rkrafted/silent-speech/hw/pod/design-notes.md

# ss-pod v1 schematic: design notes (rev 0.8)

Rev 0.2 is Claude's rebuild of the DeepSeek draft (rev 0.1, commit d74f075). Every pin and value
below was checked against the datasheets in `hw/pod/ref/` (gitignored). Items still waiting on a
datasheet are marked **OPEN**. The schematic is generated by `gen_sch.py`. Edit the generator and
not the `.kicad_sch` file, because the next run overwrites manual edits.

Verification, all re-run after every change:

```
python3 hw/pod/gen_sch.py
kicad-cli sch erc --severity-error --exit-code-violations -o hw/pod/erc.rpt hw/pod/pod.kicad_sch   # 0 errors
kicad-cli sch export netlist -o hw/pod/pod.net hw/pod/pod.kicad_sch
python3 hw/pod/check_nets.py hw/pod/pod.net                                                       # 129 rules
```

ERC leaves 6 warnings, and all of them are intended. TESTP_PACE_OUT1/2 are tied to AVDD, and GPIO1..4
are tied to GND, exactly as TI specifies. KiCad warns because those pins are "bidirectional".
`check_nets.py` was itself tested against rev 0.1: it flags every bug listed in section 2.

## 1. What it is

A battery-powered 8-channel surface-EMG front end for a small wearable sensor pod. It is built from these parts:

- **Analog front end:** an ADS1298IPAG (TQFP-64) on a unipolar 3.3 V supply. All 8 channels are
  referential: IN1P..IN8P go to electrodes E1..E8, and IN1N..IN8N go to the REF electrode. One bias
  electrode is driven by the chip's RLD amplifier.
- **Radio:** a u-blox **NINA-B306-00B** module (nRF52840, 10 × 15 mm, internal antenna, 32.768 kHz
  crystal on board, CE/RED). It talks to the ADS1298 over SPI and streams over BLE.
- **Battery input:** one protected 1-cell LiPo on the swappable cartridge (or the bench JST), through an
  **AO3401A reverse-polarity FET**.
- **Charging (rev 0.7):** none on the pod. The cartridge is charged on the separate dock board (`hw/dock`).
- **Fuel gauge (rev 0.7):** MAX17048 on +BATT, I2C on EXP4/EXP5.
- **Supplies:** two **TPS7A2033** low-noise regulators (7 µV RMS, pin-compatible with the LP5907, which is out of stock). LDO1 feeds AVDD only, and LDO2 feeds DVDD and the
  module.
- **Electrode lines:** each of the 10 lines has an ESD array, a 2.2 k series resistor and a 1 nF
  capacitor to ground (OpenBCI Cyton values).
- **Connector:** 12 individual SMD spring pins (**Harwin P70-1000045R**) carry E1..E8, REF, BIAS, CLK_POGO and GND,
  in a 3 × 4 grid at 3.0 mm pitch on the top side. Rev 0.7: P11 = CLK_POGO (the ADS clock, for linking two pods;
  it was VBUS) and P12 = GND (the link's shared ground).

## 2. Bugs fixed from rev 0.1

| # | Rev 0.1 | Rev 0.2 | Source |
|---|---|---|---|
| 1 | TESTP_PACE_OUT1, TESTN_PACE_OUT2, RLDIN tied to GND | tied to **AVDD** | TI SBAS459K TQFP pin table, note 1: "Connect unused pins to AVDD". The forum bug the draft cited was about unused INxP inputs with SRB2 on the ADS1299, a different pin type |
| 2 | ADS1298 GPIO1..4 left floating | shorted to **DGND** | SBAS459K GPIO section: "do not float these pins … If not used, short these pins to DGND" |
| 3 | WCT not connected | **1 nF** to AVSS | SBAS459K Figure 106 (single-supply example) |
| 4 | NINA VBUS (pin 31) tied to +3V3 | fed from the **5 V VBUS** through 2.2 k | UBX-17052099 Table 8: "USB interface 5 V input … Must be connected to 5 V". The nRF52840 now detects the charger natively (USBDETECTED), which removes the old VBUS divider |
| 5 | MCP73831 STAT wired to a 3.3 V nRF GPIO | STAT **left open** | STAT swings to VDD = 5 V when charging is complete, which is over the nRF52840 pin rating. Charging state comes from USBDETECTED plus battery voltage instead |
| 6 | Battery divider switched by a 2N7002. With the FET off, the ADC pin saw the full battery voltage (4.2 V) through 1 M | **fixed 1 M / 1 M divider**: the pin sees at most 2.1 V, and the divider draws 2.1 µA. The FET was removed | nRF52840 inputs must stay ≤ VDD + 0.3 V |
| 7 | No battery polarity protection | **AO3401A P-FET**: drain to the cell, source to the load, gate to GND | Small JST LiPo leads come in both polarities from different vendors. A reversed cell would otherwise destroy both LDOs and the charger |
| 8 | 1 µF on the charger input and output | **10 µF 0805 25 V** on VBUS and on VBAT | MCP73831 DS20001984H 3.1/3.2: "Bypass to VSS with a minimum of 4.7 µF" (VDD and VBAT). A 0603 10 V part loses about half its capacitance at 5 V, so it uses 0805 25 V |
| 9 | ADS control pins float while the nRF boots | 100 k pulls: PWDN low, CS high, START low, RESET high | defines a known state before firmware runs, and keeps the ADS powered down until firmware starts it |
| 10 | Battery soldered to bare pads (the assembler does not fit LiPo cells, and the owner does not solder) | **JST SH 1.0 mm 2-pin socket**: the cell plugs in | owner requirement |
| 11 | Unreadable grid of label-connected boxes, custom box symbols | 6 labelled blocks, **stock KiCad library symbols** (ADS1298xPAG, LP5907MFX-3.3, MCP73831-2-OT, AO3401A, R, C, LED), power symbols | stock symbols carry pin numbers checked by the KiCad librarians. The ADS1298 pin map was cross-checked against them on all 64 pins |
| 12 | ADS1298 price in the BOM was $32 | DigiKey/Mouser 1-off **≈ $46–49** | distributor listings |
| 13 | Two LEDs, pin 1 = anode (they would have been mounted reversed) | **no LEDs at all** | owner 2026-10-07: nothing on the pod may light up. Status, battery and charging are shown in the phone app |

## 2a. Rev 0.3 changes (2026-10-12, from the MobilECG-II comparison in `ref-compare.md`)

1. **BIAS series 10 k (R25)**: RLDOUT → R25 10 k → C10 1 nF + bead → BIAS pad. The RLD amplifier no longer
   drives C10, the ESD capacitance and the strip directly (series R isolates a capacitive load), and fault
   current into skin is limited. RLD feedback (R10 ‖ C11) is taken at RLDOUT, before R25. Answers reviewer
   question 2 (section 8). MobilECG-II uses the same 10 k.
2. **33 Ω source series resistors (R26–R30)** on SCLK, MOSI, CS_N (NINA drives) and MISO, DRDY (ADS drives).
   Nets: NINA side keeps the old name, ADS side is `<name>_A`. CS pull-up R21 is on CS_N_A.
3. **Ferrite bead per electrode line (FB1–FB10)** between the ESD array and the series R (BIAS: between pad
   and C10). Against BLE-burst pickup on the strip. MobilECG-II and the 12-lead holter use the same pattern.

**OPEN (parts):** LCSC numbers for the 33 Ω 0402 (Yageo RC0402FR-0733RL or the JLCPCB basic equivalent) and
for BLM15HD182SN1D, plus its impedance at 2.4 GHz (want ≥ 1 kΩ; otherwise pick a BLM15GG/HG type).

## 2b. Rev 0.4 changes (2026-10-14, from the layout)

1. **ADS1298 link moved to the NINA's outer left pin column.** The inner-ring pins (31-46) cannot be
   escaped on this LGA: the outer pads are 0.3 mm apart. New map, in the ADS1298's pin order:
   MOSI = pin 8 (P1.00), PWDN = 7 (P0.25), RESET = 5 (P0.24), START = 4 (P0.16), CS = 3 (P0.15),
   SCLK = 2 (P0.14), MISO = 1 (P0.13), DRDY = 25 (P0.04). UBX-17052099 flags **none of these as near the
   radio**, which is better than rev 0.3: P1.01-P1.11 were near the radio.
2. **SPI 33 ohm series resistors R26-R30 removed.** The ADS1298 sits under that pin column, so each line
   is about 3 mm (pad -> via -> pad). That is electrically short for nRF52840 standard-drive edges.
3. **EXP1-EXP5 (pins 17, 18, 20, 21, 22) ARE near the radio** (UBX-17052099): use them only for signals
   below 10 kHz, so no 100/400 kHz I2C there. BAT_SENSE (pin 16, P0.03) is near the radio too; it is a
   slow analog input, which is fine.
4. **SWD on a Tag-Connect TC2030-NL footprint J3** (pads only; cable TC2030-CTX-NL) instead of loose test
   pads. Test and expansion pads are 0.8 mm.
5. **6-layer board** (see section 6).

## 2c. Rev 0.5 / 0.6 changes (2026-10-16, owner review of the 3D model)

1. **Swappable battery cartridge (rev 0.6; owner decision: modular, swappable cells).** The cell no longer lives
   inside the pod. It sits on a removable cartridge (`hw/cartridge/`, generated by `gen_cartridge.py`): a 0.6 mm
   2-layer board that forms the pod's bottom, with a JST SH socket J1 for the cell's plug and two tall SMD pogo pins
   (Harwin P70-1100045R, C20826701: 6.3 mm free, 5.0 mm working, 0.4 um gold; picked 2026-10-17) that press up onto
   two 1.8 mm ENIG pads on the pod's bottom face:
   TP15 = BATT+ on BAT_RAW at (110.9, 126.1) and TP16 = BATT- on GND at (112.4, 128.6). Swap = unclip one cartridge,
   clip in a charged one: no tools, no soldering. Spare cartridges can be sold separately.
   - **Cell:** 20 x 20 x 4 mm pouch (402020 class, about 120 mAh, about 17-20 h at 5-6 mA), at y 104.8-124.8, clear
     of the H1 screw head. It leaves the strip y 125-130 for the pads, the pins and J1. Footprint unchanged; the
     0.6 mm cartridge board replaces the 0.8 mm printed bottom wall, so the thickness is unchanged too.
   - **Pads diagonal, 2.9 mm apart:** a misplaced pin can never bridge + and -, which would short the cell.
   - **Test/expansion pads** moved from that strip to the free spot by H1 (3 x 3 at 1.3 mm around (110.4, 103.4)).
     They stay reachable: the cartridge comes off.
   - The cartridge's + also goes through the AO3401A, so a reversed cell is blocked like a reversed plug.
     J1 pin 1 = +, the same as the pod's own J2. **One cell at a time:** J2 (bench) or the cartridge, never both.
   - A swap restarts the pod (about 1 s plus a BLE reconnect); the flash buffer covers it.
   - The clip and the locating features that hold the cartridge to within about 0.4 mm belong to the case.
2. **Electrode tab without overhang**: the right-angle 1x10 header that stuck out past the pod edge is replaced by
   an upright SMD 2x5 2.54 mm header on the tab's top face. The tab is L-shaped and stays inside the pod outline:
   the grid part (x 100-110.4) plus a foot over the pod's low parts (all <= 1.25 mm; the tab rides 3.0 mm up) that
   stops 0.5 mm short of the JST socket and clear of the antenna end. All tab traces are on F.Cu (the pod side
   carries only the contacts), so the header pin order is whatever routes planar; `route_tab.py` finds it and the
   silkscreen prints it.
3. **Charger tab unchanged**: inside the outline its USB-C shell legs would land on C28 or the JST socket. It is only
   attached while charging, so it keeps its overhang.

## 2d. Rev 0.7 changes (2026-10-16, owner decisions: no charging on the pod, two pods worn at once)

1. **No USB charging on the pod.** U5 MCP73831, R11, C28, D5 SMAJ5.0A, R16 and the VBUS net are removed, and so is
   the charger tab. Cells are charged in their cartridge on the new **dock** board (`gen_dock.py`, `hw/dock/`).
   - NINA pin 31 (VBUS) was left open in rev 0.7, with **R34** (0R to GND, DNP). **Rev 0.8 fits R34** (section 2e).
   - C29 10 uF stays as bulk on +BATT. Q2 stays.
   - With no USB, firmware is flashed with a cell fitted (the programmer does not power the pod).
2. **Two-pod clock link.**
   - ADS1298 CLKSEL moves from DVDD to NINA pin 23 (P0.29), with **R33 100k** to +3V3: internal oscillator by
     default, firmware pulls it low on a slave pod.
   - ADS CLK (net CLK_SYNC, also on TP1) -> **R31 100R** -> pogo **P11** (net CLK_POGO), ESD on D4's spare IO3.
     **R32 1M** to GND, so CLK never floats.
   - The master sets CONFIG1 CLK_EN = 1. Without a lead, each pod time-stamps its samples and the phone aligns the two streams.
   - START needs no pin: both pods start on a BLE command, and the fixed whole-sample offset is removed from the
     timestamps.
3. **MAX17048 fuel gauge U7** (TDFN-8 2 x 2):
   - VDD and CELL on +BATT; CTG, QSTRT and EP on GND; ALRT open (polled); C35 100 nF (datasheet: bypass VDD with 0.1 uF).
   - SDA = EXP4 (pin 21), SCL = EXP5 (pin 22), R35/R36 4.7k to +3V3. The bus stays on the expansion pads, so add-on
     sensors share it.
   - These pins are near the radio. I2C runs about 1 ms once a minute, timed between BLE events (reviewer question).
   - The 1M/1M divider stays as a fallback.
   - Pin table checked 2026-10-17 against datasheet 19-6171 p. 6: identical.
4. **Board size stays 24 x 30.** 24 x 28 was checked first, on paper: cell 20 mm + H1 screw-head clearance + the
   4.3 mm cartridge-pad strip = 28.0 mm with zero margin, and the case needs about ±0.4 mm for the cartridge.
5. **Board 1.2 mm thick** (2026-10-17): JLCPCB offers 6 layers at 1.2 mm for the same price, with the same rules
   (JLCPCB capabilities and quote pages, checked 2026-10-17). Spring-pin heights are measured from the board faces, so nothing else moves.
   The pod gets 0.4 mm thinner. Short top-side pins were checked and rejected: thinner gold, and no gain with a
   1.2 mm PETG wall.
6. **Layout:** the charger's strip now holds U7, C35, R35/R36 and, right under P11, R31/R32. R33 and R34 take the
   free slots in the right-edge resistor columns.
   - ADS GND pin 20 lost its via-reachable pour (an island under the module), so `fix_gnd_pin.py U1 20` routes it to
     the nearest GND via, as pin 51 already was.
   - CLK_SYNC is about 37 mm of track (ADS CLK pin -> TP1 -> R31/R32). It only toggles on a master pod with CLK_EN
     set (reviewer question).
7. **Electrode tab:**
   - The 2x5 electrode header J1 is unchanged.
   - A new SMD 1x2 header J2 above the grid carries CLK and GND, for a 2-wire lead between two pods' tabs.
   - A single 2x6 header was tried and did not route on one layer.

## 2e. Rev 0.8 changes (2026-10-19)

1. **VCAP1 cap C14 is now a polymer tantalum:** Vishay T58MM226M6R3C0300 (LCSC **C215879**), 22 µF, 6.3 V, 1608-09 case,
   0.9 mm max height, 300 mΩ max ESR, about $0.57, JLCPCB Extended, in stock. Backup: KEMET T597S226M010APE100
   (C19941081, 3216-12, 1.2 mm, but only 40 in stock). Research: `research/jaw/tantalum.md`.
   - **Why:** SBAS459K p. 96: where the board sees vibration, use a nonferroelectric VCAP1 cap, "a tantalum or class 1
     capacitor (C0G or NPO)"; X5R is piezoelectric and picks up microphonics. The same page says noise on VCAP1 degrades
     performance (forum answer Q3, `research/jaw/chip-forums.md`).
   - **Voltage:** with the 3.3 V analog supply the reference is 2.4 V. The 4 V figure in the research file (datasheet p. 33)
     is the 5 V-supply option (VREF_4V), which this board does not use. 6.3 V clears either.
   - **Footprint:** `Capacitor_Tantalum_SMD:CP_EIA-1608-10_AVX-L`, with the Vishay T58 pad table giving the same pads for the
     MM (1608-09) and M0 (1608-10) cases. **Pad 1 = +**, on VCAP1 (toward ADS pin 28); pad 2 = GND. Symbol Device:C_Polarized.
     Placed where the 0805 was (bottom side, second row). Checked in the rebuilt PCB and in `check_nets.py`.
   - **Leakage:** polymer, up to 14 µA at 6.3 V (about 0.1·C·V in general terms). The ADS1298 gives no leakage limit for VCAP1
     (reviewer question 6).
2. **NINA pin 31 (VBUS) is tied to GND through R34 0R, now fitted** (was open, DNP). Nordic's no-USB reference configuration
   and the DevZone threads 35658 and 48589 say to ground VBUS (forum answer Q5, `research/jaw/chip-forums.md`). The
   reviewer question about it stays as a confirmation.
3. Nothing else changed. Pod board 24 × 30 mm, 91 placed parts, DRC 0, unconnected 0, parity 0, ERC 0, net rules pass.

## 3. Values and their sources

| Part | Value | Source |
|---|---|---|
| Electrode series R (R1–R9) | 2.2 k | OpenBCI Cyton R4 array (CC BY-SA 4.0) |
| Electrode ferrite beads (FB1–FB10) | BLM15HD182SN1D | MobilECG-II / 12-lead holter input filter pattern (rev 0.3) |
| BIAS series R (R25) | 10 k | MobilECG-II RLD output (rev 0.3) |
| SPI series R (R26–R30) | 33 Ω | MobilECG-II RP3 (51 Ω) pattern; 33 Ω because the nRF52840 driver adds its own output resistance (rev 0.3) |
| Electrode C to GND (C1–C10) | 1 nF | Cyton C26. With 2.2 k this forms a ≈72 kHz EMI filter, not an anti-alias filter (SBAS459K 9.3.1.1) |
| ESD arrays (D2–D4) | TPD4E1B06 | Cyton D5/D6. Placed on the electrode side of the 2.2 k |
| RLD feedback | 392 k ‖ 10 nF (R10, C11) | TI ADS1298ECG-FE user guide SBAU171D 4.8 |
| RLDREF | internal (AVDD+AVSS)/2, 100 nF on the pin | SBAS459K, CONFIG3 RLDREF_INT |
| VREFP | 0.1 µF + 10 µF, VREFN = AVSS, internal 2.4 V | SBAS459K Figure 106 |
| VCAP1 / VCAP2..4 | 22 µF polymer tantalum C215879 (rev 0.8) / 1 µF | SBAS459K pin table + Figure 106 |
| AVDD, DVDD decoupling | 0.1 µF + 1 µF each | Figure 106 ("as close to the package as possible") |
| CLKSEL | rev 0.7: NINA pin 23 + 100 k pull-up (internal oscillator unless firmware pulls it low). CLK on TP1 and pogo P11 | SBAS459K Table 11 |
| RESV1, DAISY_IN | DGND | pin table |
| Charger (dock, rev 0.7) | MCP73831-2 (4.20 V) on the dock, R_PROG 15 k = 67 mA (about 0.55 C for 120 mAh) | MCP73831 datasheet: I = 1000 V / R_PROG |
| Fuel gauge (rev 0.7) | MAX17048 on +BATT, I2C 4.7 k pull-ups | MAX17048 datasheet 19-6171 p. 6 (pin table checked 2026-10-17); LCSC C2682616 |
| Two-pod clock | CLK 100 R series, 1 M pull-down; CLKSEL 100 k pull-up | SBAS459K CLKSEL / CONFIG1 CLK_EN |
| LDOs | TPS7A2033PDBVR (LCSC C2862740, 200k in stock). EN tied to IN (always on). 1 µF in and out | TPS7A20 datasheet: SOT-23 pins 1 IN, 2 GND, 3 EN, 4 NC, 5 OUT (same as LP5907). Needs ≥ 0.47 µF effective on OUT. Noise 6.7 µV RMS at 20–100 mA |
| Module decoupling | 0.1 µF + 1 µF | u-blox NINA-B3 integration |
| Battery sense | 1 M / 1 M + 100 nF on NINA pin 16 (P0.03, AIN1) | the 100 nF supplies the SAADC sample charge at the high source impedance |

**Part types:** 23 BOM lines, of which 5 resistor values and 6 capacitor values are JLCPCB basic parts.
Reusing values keeps the extended-part fees low.

## 4. Pin map: NINA-B306 ↔ ADS1298 and the rest

| NINA pin | nRF52840 | Net | Notes |
|---|---|---|---|
| 2 | P0.14 | SCLK → ADS SCLK | rev 0.4: the whole ADS link is on pins u-blox does **not** mark near the radio, with no series R |
| 8 | P1.00 | MOSI → ADS DIN | (P1.00 is also SWO; SWO is not used: J3 pin 6 is open) |
| 1 | P0.13 | MISO ← ADS DOUT | |
| 3 | P0.15 | CS_N → ADS CS | R21 100 k pull-up |
| 25 | P0.04 | DRDY ← ADS DRDY | 500-1000 Hz |
| 4 | P0.16 | START | static; also on TP2. R22 pull-down |
| 5 | P0.24 | ADS_RESET | static. R23 pull-up |
| 7 | P0.25 | ADS_PWDN | static. R20 pull-down |
| 17, 18, 20 | P0.28, P0.02, P0.31 | EXP1-EXP3 | **near the radio**: signals below 10 kHz only |
| 21, 22 | P1.12, P1.13 | EXP4 = SDA, EXP5 = SCL | rev 0.7: MAX17048 I2C (bursts about 1 ms per minute), also on the pads |
| 23 | P0.29 | CLKSEL | rev 0.7: static. R33 100 k pull-up |
| 16 | P0.03 / AIN1 | BAT_SENSE | analog (near the radio: fine for a slow ADC input) |
| 31 | VBUS | VBUS_MOD: tied to GND by R34 0R (fitted) | rev 0.8: no USB on the pod; Nordic no-USB configuration |
| 15 / 11 / 19 | SWDIO / SWDCLK / P0.18 | J3 Tag-Connect pins 2 / 4 / 3 | programming (J3.1 = +3V3, J3.5 = GND). R13 pulls RESET up |
| 9, 10 | VCC_IO, VCC | +3V3 | VCC_IO must tie to VCC on NINA-B3 |
| 6/12/14/26/30/53, EGP, EAGP | | GND | **EAGP** (antenna-area ground pads, NINA-B306 only) must be grounded, so the footprint must carry them |

All other module pins have no-connect flags.

## 5. Firmware rules the hardware depends on

- **Power-up:** drive PWDN and RESET high, wait for t_POR, pulse RESET, send SDATAC, and only then
  write registers (SBAS459K power-up sequence).
- **ADS1298 registers:**
  - CONFIG3: `PD_REFBUF = 1` (internal reference), `RLDREF_INT = 1`, `PD_RLD = 1`.
  - RLD_SENSP/N: select the electrode channels.
  - Gain: x6 or lower for EMG (the forum found x24 rails).
  - Data rate: 1000 SPS by default (owner 2026-10-07); 500 only as the weak-link fallback.
  - Do not use the pace/test outputs. They are tied to AVDD.
- **Charging (rev 0.7):** never on the pod. A cartridge swap restarts the pod; buffer to flash and back-fill after the
  BLE reconnect. Battery % comes from the MAX17048 (fallback: BAT_SENSE).
- **Two pods:** the master keeps CLKSEL high and sets CONFIG1 CLK_EN = 1; the slave drives CLKSEL low before START.
  Only one pod drives BIAS (the other powers its RLD amplifier down).
- **No light anywhere:** there are no LEDs. Every status (connected, recording, battery, charging)
  goes to the phone app over BLE.
- **Battery:** read BAT_SENSE × 2. Below 3.5 V, warn and stop, because LDO dropout starts near 3.4 V.
- **Idle:** keep PWDN low and advertise BLE slowly. There is no power switch, so idle current sets
  shelf life (tens of µA is weeks to months on the 120 mAh cartridge; MAX17048 adds about 23 µA, or 4 µA in hibernate).

## 6. Layout (rev 0.4 board, 2026-10-14; rev 0.5-0.7 changes in sections 2c and 2d)

Rebuild everything with `hw/pod/build.sh`:

| Step | Script | What it does |
|---|---|---|
| 1 | `gen_sch.py` | schematic, ERC, netlist, `check_nets.py` |
| 2 | `gen_nina_fp.py` | module footprint |
| 3 | `gen_pcb.py` | placement, rules, planes, keep-outs, locked decoupling routes, GND fan-out |
| 4 | `route.py` | Freerouting |
| 5 | `finish_route.py` | A* for leftovers, GND stitching, clearance nudges |
| 6 | DRC | must be clean |

Order files come from `fab.py`, which refuses on any DRC error, unrouted net or placeholder. The mating
tabs come from `gen_tabs.py`, and the electrode tab is then routed by `route_tab.py` (F.Cu only). Shared mechanics are in `pod_geom.py`. The review package is `hw/review/`.

- **Board:** 24 x 30 mm, **6 layers**: F.Cu / In1 GND / In2 sig / In3 sig / In4 GND / B.Cu, parts on both
  sides. The owner chose 24 x 30 after 22 x 28 measured 76 % courtyard density (893 mm2 of parts). Six
  layers instead of four (about $10-30 more per order) because:
  - on four layers the autorouter left 8-27 nets open in every attempt;
  - an In2 +3V3 plane split into islands;
  - six layers give each assembled side its own solid ground plane.
  Rev 0.6+: the 402020 cell (20 x 20 x 4, about 120 mAh) sits on the removable cartridge against the bottom side.
- **Top:**
  - NINA-B306 at the top edge, antenna outward (footprint rotated 180 deg), with an all-layer copper
    keep-out under its antenna end;
  - 3 x 4 pogo grid (3.0 mm pitch, P1-P3 / P4-P6 / P7-P9 / P10-P12; rev 0.7: P11 CLK_POGO + P12 GND), with
    an M2 NPTH clamp hole at each end;
  - Tag-Connect between H1 and the grid;
  - rev 0.7: R31 (CLK 100R) and R32 (1M) under P11, where the VBUS TVS was;
  - flash directly under the module's QSPI pin row;
  - rev 0.7: MAX17048 + pull-ups where the charger was; FET, JST SH socket (opening at the bottom edge);
  - the boot pull resistors and battery divider in two columns at the right edge.
- **Bottom:**
  - ADS1298 under the module;
  - every decoupling cap 2 mm outside its own pin, with a **locked** pad-to-pin route;
  - VREFP 10 uF and VCAP1 22 uF (rev 0.8: 1608 polymer tantalum) in a second row, lined up on free gaps;
  - the 10 filter rows (bead, 2.2k, 1 nF) under the pogo grid in ADS pin order, ESD arrays in the
    grid-area corners;
  - both LDOs, with EN tied to IN on a locked route;
  - 0.8 mm test and expansion pads.
- **Clamp:** the bench electrode tab screws down on 3.0 mm M2 nylon spacers (pogo
  working height 2.9 mm). Hole keep-out is r 2.1 mm on both sides (spacer on top, screw head below).
  Screws are for the bench tab only. The worn flex strip, the battery cartridge and the dock hold on with magnets in
  the printed case (owner, 2026-10-06/07). The two NPTH holes double as locating posts.
- **Tabs:**
  - the pod-facing side carries only the contact pads, so a pogo tip can't press through the mask onto
    other copper;
  - the electrode tab stays inside the pod outline (rev 0.5); the charger tab is gone (rev 0.7);
  - electrode tab header J1 (upright SMD 2x5, pin 1 top left, odd pins left column), rev 0.7 order: 1 REF, 2 E6,
    3 E3, 4 E5, 5 E4, 6 E2, 7 E1, 8 E8, 9 BIAS, 10 E7. Link header J2 (1x2): 1 CLK, 2 GND. The order is the one that routes on the top layer alone; the
    silkscreen prints it beside the header.
- **Rules (JLCPCB 6-layer standard):**
  - signals routed at 0.10 / 0.10 mm; necked tracks widened to the 0.09 mm minimum;
  - DRC uses 0.09 mm space;
  - vias 0.45 / 0.20 mm;
  - via hole to copper 0.20 mm (confirm in review);
  - copper to edge 0.30 mm;
  - battery path (+BATT, BAT_RAW) 0.20 mm tracks.
- **Ground:** every GND SMD pad gets its own stub and via where one fits. The pads listed in the review
  README reach ground through the pour plus stitching vias, and DRC confirms them connected.

## 7. Datasheet check, 2026-10-07 (PDFs in hw/pod/ref/ds/, read by Claude)

| Item | Result |
|---|---|
| TPD4E1B06 DCK pinout | **confirmed** (TI SLVSBQ8E Table 4-1): 1 IO1, 2 IO2, 3 GND, 4 IO3, 5 IO4, 6 NC. Matches `TPD_MAP` |
| LP5907MFX-3.3 | out of stock. **Replaced by TPS7A2033PDBVR** (TI, identical pinout, as quiet). MSKSEMI C20538881 is the fallback |
| MCP73831 capacitors | minimum 4.7 µF on VDD and on VBAT. **10 µF 0805 25 V** used |
| Battery socket | **JST SM02B-SRSS-TB, LCSC C160402** (JLCPCB extended, 32k stock). The cell needs a JST **SH 1.0 mm** 2-pin plug (cable housing SHR-02V-S-B). **When buying the battery:** choose the SH1.0 plug option and check its polarity. The AO3401A only protects; a reversed cell does not power on |
| **Pogo connector** | **Resolved (ds2/).** C55173001 was a single row of 6 at 2.5 mm, through-hole. The only real 2×6 pogo at LCSC (C5200695) is 8 mm tall and through-hole, too tall for a 10 mm pod. **Chosen: 12 × Harwin P70-1000045R (C17702549)**, an SMD single pin: 0.4 µm Au plunger over Ni (good for sweat), 10k cycles, 2 A, 3.5 mm free / **2.9 mm working height** / 2.7 mm minimum, recommended pad Ø2.20 mm, tape and reel (pick-and-place OK), 1,983 in stock. Cheaper fallback: YIYUAN YTC1P-1807-01R (C53185156, $0.21, 20k cycles), but it has only 1 µ" flash gold |
| 10 µF 0805 25 V (C15850) | JLCPCB **basic** part, 4.8 M in JLCPCB stock (0 at LCSC retail, irrelevant for assembly). The Samsung catalog gives no DC-bias curve. Two of them (VBUS, VBAT) still clear 4.7 µF at 5 V only if derating stays under about 50 %, so the reviewers are asked to confirm, or use 2 × 10 µF |
| NINA-B306 stock | only **38** at LCSC. Order soon, or note the alternative module before ordering |
| NINA-B306 antenna (integration manual UBX-17056748, 3.3) | module at the **centre of a board edge**, antenna facing away from the body. **Ground plane ≥ 10 mm on both sides** (so that edge is about 30 mm). Full GND plane under the module, with the cut-out under the antenna per its Figure 14. The **4 EAGP pads must be grounded** (they are). u-blox also wants **10 mm to the case and to metal parts**, which a 24 × 30 × 10 mm pod cannot meet. **Expect reduced range.** For a phone within about 1 m this is acceptable: the BLE link budget has more than 20 dB margin at 1 m even with 10–15 dB of body and detuning loss. Check the RSSI on the first boards |

## 8. Questions for the reviewers (TI E2E, r/PrintedCircuitBoard)

1. **RLD loop stability.** The bias electrode will often be a dry or hydrogel pad with 0.1–2 MΩ
   contact impedance that varies. Is TI's 392 k ‖ 10 nF still stable, or should C11 change?
2. **Series resistance on BIAS.** *Answered in rev 0.3:* 10 k (R25), as on MobilECG-II.
3. **Internal RLDREF** on a unipolar 3.3 V build: any reason to prefer an external mid-supply divider?
4. **MCP73831 without power-path.** The pod draws about 5 mA while the cell charges at 100 mA. Do we
   accept the termination behaviour for v1?
5. **Single GND net** with a split-return layout under the ADS1298, versus separate AGND/DGND nets
   joined at one point.
6. **VCAP1 22 µF.** *Changed in rev 0.8* to a Vishay T58 polymer tantalum (C215879), as SBAS459K p. 96 advises under
   vibration (research/jaw/chip-forums.md Q3, research/jaw/tantalum.md). Open for the reviewer: (a) is the 1608 polymer land
   pattern right (the KiCad `CP_EIA-1608-10_AVX-L` pads, identical to the T58 MM case table)? (b) Is polymer leakage on
   VCAP1 (up to about 14 µA at 6.3 V) acceptable, or should it be a MnO₂ tantalum?
7. **NINA VBUS to GND.** Done in rev 0.8 (R34 fitted; research/jaw/chip-forums.md Q5). Confirm.
