rkrafted/silent-speech/hw/revisions/2026-10-07-392cefe4/pod/design-notes.md

# ss-pod v1 schematic: design notes (rev 0.2)

Rev 0.2 is Claude's rebuild of the DeepSeek draft (rev 0.1, commit d74f075). Every pin and value
below was checked against the datasheets in `hw/pod/ref/` (gitignored). Items still waiting on a
datasheet are marked **OPEN**. The schematic is generated by `gen_sch.py`. Edit the generator and
not the `.kicad_sch` file, because the next run overwrites manual edits.

Verification, all re-run after every change:

```
python3 hw/pod/gen_sch.py
kicad-cli sch erc --severity-error --exit-code-violations -o hw/pod/erc.rpt hw/pod/pod.kicad_sch   # 0 errors
kicad-cli sch export netlist -o hw/pod/pod.net hw/pod/pod.kicad_sch
python3 hw/pod/check_nets.py hw/pod/pod.net                                                       # 85 rules
```

ERC leaves 6 warnings, and all of them are intended. TESTP_PACE_OUT1/2 are tied to AVDD, and GPIO1..4
are tied to GND, exactly as TI specifies. KiCad warns because those pins are "bidirectional".
`check_nets.py` was itself tested against rev 0.1: it flags every bug listed in section 2.

## 1. What it is

A battery-powered 8-channel surface-EMG front end for the hidden jaw pod. It is built from these parts:

- **Analog front end:** an ADS1298IPAG (TQFP-64) on a unipolar 3.3 V supply. All 8 channels are
  referential: IN1P..IN8P go to electrodes E1..E8, and IN1N..IN8N go to the REF electrode. One bias
  electrode is driven by the chip's RLD amplifier.
- **Radio:** a u-blox **NINA-B306-00B** module (nRF52840, 10 × 15 mm, internal antenna, 32.768 kHz
  crystal on board, CE/RED). It talks to the ADS1298 over SPI and streams over BLE.
- **Battery input:** one protected 1-cell LiPo, through an **AO3401A reverse-polarity FET**.
- **Charging:** an **MCP73831** at 100 mA from the pogo VBUS pin.
- **Supplies:** two **TPS7A2033** low-noise regulators (7 µV RMS, pin-compatible with the LP5907, which is out of stock). LDO1 feeds AVDD only, and LDO2 feeds DVDD and the
  module.
- **Electrode lines:** each of the 10 lines has an ESD array, a 2.2 k series resistor and a 1 nF
  capacitor to ground (OpenBCI Cyton values).
- **Connector:** 12 individual SMD spring pins (**Harwin P70-1000045R**) carry E1..E8, REF, BIAS, VBUS and GND. They sit on the same (top) side as every other part, in a 2 × 6 grid at 3.0 mm pitch at one board end. P11 (VBUS) and P12 (GND) are adjacent, so the charger tab touches only those two.

## 2. Bugs fixed from rev 0.1

| # | Rev 0.1 | Rev 0.2 | Source |
|---|---|---|---|
| 1 | TESTP_PACE_OUT1, TESTN_PACE_OUT2, RLDIN tied to GND | tied to **AVDD** | TI SBAS459K TQFP pin table, note 1: "Connect unused pins to AVDD". The forum bug the draft cited was about unused INxP inputs with SRB2 on the ADS1299, a different pin type |
| 2 | ADS1298 GPIO1..4 left floating | shorted to **DGND** | SBAS459K GPIO section: "do not float these pins … If not used, short these pins to DGND" |
| 3 | WCT not connected | **1 nF** to AVSS | SBAS459K Figure 106 (single-supply example) |
| 4 | NINA VBUS (pin 31) tied to +3V3 | fed from the **5 V VBUS** through 2.2 k | UBX-17052099 Table 8: "USB interface 5 V input … Must be connected to 5 V". The nRF52840 now detects the charger natively (USBDETECTED), which removes the old VBUS divider |
| 5 | MCP73831 STAT wired to a 3.3 V nRF GPIO | STAT **left open** | STAT swings to VDD = 5 V when charging is complete, which is over the nRF52840 pin rating. Charging state comes from USBDETECTED plus battery voltage instead |
| 6 | Battery divider switched by a 2N7002. With the FET off, the ADC pin saw the full battery voltage (4.2 V) through 1 M | **fixed 1 M / 1 M divider**: the pin sees at most 2.1 V, and the divider draws 2.1 µA. The FET was removed | nRF52840 inputs must stay ≤ VDD + 0.3 V |
| 7 | No battery polarity protection | **AO3401A P-FET**: drain to the cell, source to the load, gate to GND | Small JST LiPo leads come in both polarities from different vendors. A reversed cell would otherwise destroy both LDOs and the charger |
| 8 | 1 µF on the charger input and output | **10 µF 0805 25 V** on VBUS and on VBAT | MCP73831 DS20001984H 3.1/3.2: "Bypass to VSS with a minimum of 4.7 µF" (VDD and VBAT). A 0603 10 V part loses about half its capacitance at 5 V, so it uses 0805 25 V |
| 9 | ADS control pins float while the nRF boots | 100 k pulls: PWDN low, CS high, START low, RESET high | defines a known state before firmware runs, and keeps the ADS powered down until firmware starts it |
| 10 | Battery soldered to bare pads (the assembler does not fit LiPo cells, and the owner does not solder) | **JST SH 1.0 mm 2-pin socket**: the cell plugs in | owner requirement |
| 11 | Unreadable grid of label-connected boxes, custom box symbols | 6 labelled blocks, **stock KiCad library symbols** (ADS1298xPAG, LP5907MFX-3.3, MCP73831-2-OT, AO3401A, R, C, LED), power symbols | stock symbols carry pin numbers checked by the KiCad librarians. The ADS1298 pin map was cross-checked against them on all 64 pins |
| 12 | ADS1298 price in the BOM was $32 | DigiKey/Mouser 1-off **≈ $46–49** | distributor listings |
| 13 | Two LEDs, pin 1 = anode (they would have been mounted reversed) | **no LEDs at all** | owner 2026-10-07: the pod is meant to be hidden, so nothing may light up. Status, battery and charging are shown in the phone app |

## 3. Values and their sources

| Part | Value | Source |
|---|---|---|
| Electrode series R (R1–R9) | 2.2 k | OpenBCI Cyton R4 array (CC BY-SA 4.0) |
| Electrode C to GND (C1–C10) | 1 nF | Cyton C26. With 2.2 k this forms a ≈72 kHz EMI filter, not an anti-alias filter (SBAS459K 9.3.1.1) |
| ESD arrays (D2–D4) | TPD4E1B06 | Cyton D5/D6. Placed on the electrode side of the 2.2 k |
| RLD feedback | 392 k ‖ 10 nF (R10, C11) | TI ADS1298ECG-FE user guide SBAU171D 4.8 |
| RLDREF | internal (AVDD+AVSS)/2, 100 nF on the pin | SBAS459K, CONFIG3 RLDREF_INT |
| VREFP | 0.1 µF + 10 µF, VREFN = AVSS, internal 2.4 V | SBAS459K Figure 106 |
| VCAP1 / VCAP2..4 | 22 µF / 1 µF | SBAS459K pin table + Figure 106 |
| AVDD, DVDD decoupling | 0.1 µF + 1 µF each | Figure 106 ("as close to the package as possible") |
| CLKSEL | high (DVDD) = internal oscillator. CLK on test pad TP1 for future two-chip sync | SBAS459K Table 11 |
| RESV1, DAISY_IN | DGND | pin table |
| Charger | MCP73831-2 (4.20 V), R_PROG 10 k = 100 mA | MCP73831 datasheet: I = 1000 V / R_PROG |
| LDOs | TPS7A2033PDBVR (LCSC C2862740, 200k in stock). EN tied to IN (always on). 1 µF in and out | TPS7A20 datasheet: SOT-23 pins 1 IN, 2 GND, 3 EN, 4 NC, 5 OUT (same as LP5907). Needs ≥ 0.47 µF effective on OUT. Noise 6.7 µV RMS at 20–100 mA |
| Module decoupling | 0.1 µF + 1 µF | u-blox NINA-B3 integration |
| Battery sense | 1 M / 1 M + 100 nF on NINA pin 16 (P0.03, AIN1) | the 100 nF supplies the SAADC sample charge at the high source impedance |

**Part types:** 20 BOM lines, of which 5 resistor values and 6 capacitor values are JLCPCB basic parts.
Reusing values keeps the extended-part fees low.

## 4. Pin map: NINA-B306 ↔ ADS1298 and the rest

| NINA pin | nRF52840 | Net | Notes |
|---|---|---|---|
| 32 | P0.11 | SCLK | SPI on pins u-blox does **not** mark radio-sensitive |
| 33 | P1.09 | MOSI (ADS DIN) | |
| 34 | P1.08 | MISO (ADS DOUT) | |
| 35 | P1.01 | CS_N | radio-sensitive pin. Toggles once per frame (≤ 1 kHz), under the 10 kHz limit |
| 36 | P1.02 | DRDY | 500–1000 Hz |
| 37 | P1.03 | START | static. Also on TP2 |
| 38 | P1.10 | ADS_RESET | static |
| 39 | P1.11 | ADS_PWDN | static |
| 16 | P0.03 / AIN1 | BAT_SENSE | analog |
| 31 | VBUS | VBUS via 2.2 k | charger present → USBDETECTED event |
| 15 / 11 / 19 | SWDIO / SWDCLK / P0.18 | TP3 / TP4 / TP5 | programming. TP6 = +3V3, TP7 = GND. R13 pulls RESET up |
| 9, 10 | VCC_IO, VCC | +3V3 | VCC_IO must tie to VCC on NINA-B3 |
| 6/12/14/26/30/53, EGP, EAGP | | GND | **EAGP** (antenna-area ground pads, NINA-B306 only) must be grounded, so the footprint must carry them |

All other module pins have no-connect flags.

## 5. Firmware rules the hardware depends on

- **Power-up:** drive PWDN and RESET high, wait for t_POR, pulse RESET, send SDATAC, and only then
  write registers (SBAS459K power-up sequence).
- **ADS1298 registers:**
  - CONFIG3: `PD_REFBUF = 1` (internal reference), `RLDREF_INT = 1`, `PD_RLD = 1`.
  - RLD_SENSP/N: select the electrode channels.
  - Gain: x6 or lower for EMG (the forum found x24 rails).
  - Data rate: 500–1000 SPS.
  - Do not use the pace/test outputs. They are tied to AVDD.
- **Charging:** on USBDETECTED (charger present), stop streaming and power the ADS down. On
  USBREMOVED, resume. Report "charging" to the app while VBUS is present, and "full" once the battery
  reads ≥ 4.15 V for a few minutes (STAT is not wired: it swings to 5 V).
- **No light anywhere:** there are no LEDs. Every status (connected, recording, battery, charging)
  goes to the phone app over BLE.
- **Battery:** read BAT_SENSE × 2. Below 3.5 V, warn and stop, because LDO dropout starts near 3.4 V.
- **Idle:** keep PWDN low and advertise BLE slowly. There is no power switch, so idle current sets
  shelf life (tens of µA means months on 200 mAh).

## 6. Rules for the layout (next item)

- **Placement:** every part is on the TOP side, so it is one economic assembly side, including the
  12 pogo pins. The bottom side is bare and flat against the battery.
- **Pogo grid:** P1..P12 in a 2 × 6 grid, 3.0 mm pitch, Ø2.2 mm pads, at the board end that faces
  the strip tab. Nothing taller than 2.5 mm within 2 mm of the grid, so the tab can reach the 2.9 mm
  working height. The case has 12 holes over the pins and a magnet each side of the grid.
- **Mating tabs (strip end and charger):** 12 (or 2) gold pads, Ø ≥ 2.5 mm, at the same grid, on a
  stiffened flex or rigid tab with a steel or magnet insert. **Hard gold over Ni** is preferred for
  daily mating (Mill-Max guidance). ENIG works for the prototype.
- **Analog area:** 4 layers, with layer 2 a solid GND plane. Keep the analog section (ADS1298, input
  RCs, RLD, VREF/VCAP caps) in one corner, away from the module antenna. Return digital currents under
  the digital section. Every TI decoupling cap goes at its pin.
- **Antenna:** module at the centre of the opposite short edge, antenna outward (away from the head).
  Ground ≥ 10 mm either side, full GND under the module, and the u-blox cut-out under the antenna.
- **Matching:** route the input traces E1..E8 / REF as matched short runs. Keep BIAS away from the
  inputs.
- **Footprints to draw:**
  - `pod:u-blox_NINA-B306`: u-blox land pattern, including EGP and the 4 EAGP pads.
  - `pod:Harwin_P70-1000045R_pad2.2`: one Ø2.2 mm SMD pad, plus a courtyard.
- **Charger:** needs a separate tiny board (same JLCPCB order). It is a USB-C socket feeding 2 gold
  pads at the P11/P12 positions, with magnets. It is not part of this schematic.

## 7. Datasheet check, 2026-10-07 (PDFs in hw/pod/ref/ds/, read by Claude)

| Item | Result |
|---|---|
| TPD4E1B06 DCK pinout | **confirmed** (TI SLVSBQ8E Table 4-1): 1 IO1, 2 IO2, 3 GND, 4 IO3, 5 IO4, 6 NC. Matches `TPD_MAP` |
| LP5907MFX-3.3 | out of stock. **Replaced by TPS7A2033PDBVR** (TI, identical pinout, as quiet). MSKSEMI C20538881 is the fallback |
| MCP73831 capacitors | minimum 4.7 µF on VDD and on VBAT. **10 µF 0805 25 V** used |
| Battery socket | **JST SM02B-SRSS-TB, LCSC C160402** (JLCPCB extended, 32k stock). The cell needs a JST **SH 1.0 mm** 2-pin plug (cable housing SHR-02V-S-B). **When buying the battery:** choose the SH1.0 plug option and check its polarity. The AO3401A only protects; a reversed cell does not power on |
| **Pogo connector** | **Resolved (ds2/).** C55173001 was a single row of 6 at 2.5 mm, through-hole. The only real 2×6 pogo at LCSC (C5200695) is 8 mm tall and through-hole, too tall for a 10 mm pod. **Chosen: 12 × Harwin P70-1000045R (C17702549)**, an SMD single pin: 0.4 µm Au plunger over Ni (good for sweat), 10k cycles, 2 A, 3.5 mm free / **2.9 mm working height** / 2.7 mm minimum, recommended pad Ø2.20 mm, tape and reel (pick-and-place OK), 1,983 in stock. Cheaper fallback: YIYUAN YTC1P-1807-01R (C53185156, $0.21, 20k cycles), but it has only 1 µ" flash gold |
| 10 µF 0805 25 V (C15850) | JLCPCB **basic** part, 4.8 M in JLCPCB stock (0 at LCSC retail, irrelevant for assembly). The Samsung catalog gives no DC-bias curve. Two of them (VBUS, VBAT) still clear 4.7 µF at 5 V only if derating stays under about 50 %, so the reviewers are asked to confirm, or use 2 × 10 µF |
| NINA-B306 stock | only **38** at LCSC. Order soon, or note the alternative module before ordering |
| NINA-B306 antenna (integration manual UBX-17056748, 3.3) | module at the **centre of a board edge**, antenna facing out from the head. **Ground plane ≥ 10 mm on both sides** (so that edge is about 30 mm). Full GND plane under the module, with the cut-out under the antenna per its Figure 14. The **4 EAGP pads must be grounded** (they are). u-blox also wants **10 mm to the case and to metal parts**, which a 30 × 20 × 10 mm pod cannot meet. **Expect reduced range.** For a phone within about 1 m this is acceptable: the BLE link budget has more than 20 dB margin at 1 m even with 10–15 dB of body and detuning loss. Check the RSSI on the first boards |

## 8. Questions for the reviewers (TI E2E, r/PrintedCircuitBoard)

1. **RLD loop stability.** The bias electrode will often be a dry or hydrogel pad with 0.1–2 MΩ
   contact impedance that varies. Is TI's 392 k ‖ 10 nF still stable, or should C11 change?
2. **Series resistance on BIAS.** RLDOUT drives the bias electrode directly; only the 1 nF and ESD
   are on the line. Cyton-style 2.2 k on the sense lines only. Should BIAS get a series resistor to
   limit fault current into skin?
3. **Internal RLDREF** on a unipolar 3.3 V build: any reason to prefer an external mid-supply divider?
4. **MCP73831 without power-path.** The pod draws about 5 mA while the cell charges at 100 mA. Do we
   accept the termination behaviour for v1?
5. **Single GND net** with a split-return layout under the ADS1298, versus separate AGND/DGND nets
   joined at one point.
6. **VCAP1 22 µF X5R in a wearable** (TI notes microphonics under vibration). Is it worth a
   tantalum/polymer part?
