rkrafted/silent-speech/hw/revisions/2026-10-16-01f62380/pod/design-notes.md

# ss-pod v1 schematic: design notes (rev 0.4)

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

Verification, all re-run after every change:

```
python3 hw/pod/gen_sch.py
kicad-cli sch erc --severity-error --exit-code-violations -o hw/pod/erc.rpt hw/pod/pod.kicad_sch   # 0 errors
kicad-cli sch export netlist -o hw/pod/pod.net hw/pod/pod.kicad_sch
python3 hw/pod/check_nets.py hw/pod/pod.net                                                       # 122 rules
```

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

## 1. What it is

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

## 2. Bugs fixed from rev 0.1

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

## 2b. Rev 0.4 changes (2026-10-14, from the layout)

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

## 3. Values and their sources

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

## 4. Pin map: NINA-B306 ↔ ADS1298 and the rest

| NINA pin | nRF52840 | Net | Notes |
|---|---|---|---|
| 2 | P0.14 | SCLK → ADS SCLK | rev 0.4: the whole ADS link is on pins u-blox does **not** mark near the radio, with no series R |
| 8 | P1.00 | MOSI → ADS DIN | (P1.00 is also SWO; SWO is not used: J3 pin 6 is open) |
| 1 | P0.13 | MISO ← ADS DOUT | |
| 3 | P0.15 | CS_N → ADS CS | R21 100 k pull-up |
| 25 | P0.04 | DRDY ← ADS DRDY | 500-1000 Hz |
| 4 | P0.16 | START | static; also on TP2. R22 pull-down |
| 5 | P0.24 | ADS_RESET | static. R23 pull-up |
| 7 | P0.25 | ADS_PWDN | static. R20 pull-down |
| 17, 18, 20, 21, 22 | P0.28, P0.02, P0.31, P1.12, P1.13 | EXP1-EXP5 | **near the radio**: signals below 10 kHz only |
| 16 | P0.03 / AIN1 | BAT_SENSE | analog (near the radio: fine for a slow ADC input) |
| 31 | VBUS | VBUS via 2.2 k | charger present → USBDETECTED event |
| 15 / 11 / 19 | SWDIO / SWDCLK / P0.18 | J3 Tag-Connect pins 2 / 4 / 3 | programming (J3.1 = +3V3, J3.5 = GND). R13 pulls RESET up |
| 9, 10 | VCC_IO, VCC | +3V3 | VCC_IO must tie to VCC on NINA-B3 |
| 6/12/14/26/30/53, EGP, EAGP | | GND | **EAGP** (antenna-area ground pads, NINA-B306 only) must be grounded, so the footprint must carry them |

All other module pins have no-connect flags.

## 5. Firmware rules the hardware depends on

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

## 6. Layout (rev 0.4 board, 2026-10-14)

Rebuild everything with `hw/pod/build.sh`:

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

Order files come from `fab.py`, which refuses on any DRC error, unrouted net or placeholder. The mating
tabs come from `gen_tabs.py`. Shared mechanics are in `pod_geom.py`. The review package is `hw/review/`.

- **Board:** 24 x 30 mm, **6 layers**: F.Cu / In1 GND / In2 sig / In3 sig / In4 GND / B.Cu, parts on both
  sides. The owner chose 24 x 30 after 22 x 28 measured 76 % courtyard density (893 mm2 of parts). Six
  layers instead of four (about $10-30 more per order) because:
  - on four layers the autorouter left 8-27 nets open in every attempt;
  - an In2 +3V3 plane split into islands;
  - six layers give each assembled side its own solid ground plane.
  The 150 mAh pouch (19.75 x 26.0 x 3.8) sits against the bottom side.
- **Top:**
  - NINA-B306 at the top edge, antenna outward (footprint rotated 180 deg), with an all-layer copper
    keep-out under its antenna end;
  - 3 x 4 pogo grid (3.0 mm pitch, P1-P3 / P4-P6 / P7-P9 / P10-P12, P11 VBUS + P12 GND adjacent), with
    an M2 NPTH clamp hole at each end;
  - Tag-Connect between H1 and the grid;
  - VBUS TVS under P11;
  - flash directly under the module's QSPI pin row;
  - charger, FET, JST SH socket (opening at the bottom edge);
  - the boot pull resistors and battery divider in two columns at the right edge.
- **Bottom:**
  - ADS1298 under the module;
  - every decoupling cap 2 mm outside its own pin, with a **locked** pad-to-pin route;
  - VREFP 10 uF and VCAP1 22 uF (0805) in a second row, lined up on free gaps;
  - the 10 filter rows (bead, 2.2k, 1 nF) under the pogo grid in ADS pin order, ESD arrays in the
    grid-area corners;
  - both LDOs, with EN tied to IN on a locked route;
  - 0.8 mm test and expansion pads.
- **Clamp:** the electrode tab and the charger tab screw down on 3.0 mm M2 nylon spacers (pogo
  working height 2.9 mm). Hole keep-out is r 2.1 mm on both sides (spacer on top, screw head below).
- **Tabs:**
  - the pod-facing side carries only the contact pads, so a pogo tip can't press through the mask onto
    other copper;
  - through-hole pins sit in an overhang left of the pod outline;
  - electrode tab header, top to bottom: E1..E8, REF, BIAS = header pins 10..1 (pin 1, square, = BIAS).
- **Rules (JLCPCB 6-layer standard):**
  - signals routed at 0.10 / 0.10 mm; necked tracks widened to the 0.09 mm minimum;
  - DRC uses 0.09 mm space;
  - vias 0.45 / 0.20 mm;
  - via hole to copper 0.20 mm (confirm in review);
  - copper to edge 0.30 mm;
  - charge path (VBUS, +BATT, BAT_RAW) 0.20 mm tracks.
- **Ground:** every GND SMD pad gets its own stub and via where one fits. The pads listed in the review
  README reach ground through the pour plus stitching vias, and DRC confirms them connected.

## 7. Datasheet check, 2026-10-07 (PDFs in hw/pod/ref/ds/, read by Claude)

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

## 8. Questions for the reviewers (TI E2E, r/PrintedCircuitBoard)

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
