rkrafted/silent-speech/hw/revisions/2026-10-16-676691bc/pod/design-notes.md

# ss-pod v1 schematic: design notes (rev 0.4)

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

Verification, all re-run after every change:

```
python3 hw/pod/gen_sch.py
kicad-cli sch erc --severity-error --exit-code-violations -o hw/pod/erc.rpt hw/pod/pod.kicad_sch   # 0 errors
kicad-cli sch export netlist -o hw/pod/pod.net hw/pod/pod.kicad_sch
python3 hw/pod/check_nets.py hw/pod/pod.net                                                       # 122 rules
```

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

## 1. What it is

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

## 2. Bugs fixed from rev 0.1

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

## 2b. Rev 0.4 changes (2026-10-14, from the layout)

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

## 2c. Rev 0.5 changes (2026-10-16, owner review of the 3D model)

1. **Battery-sled contacts TP15 (BATT+, on BAT_RAW) and TP16 (BATT-, GND)**: two 2.5 mm ENIG pads on the bottom
   face, in parallel with the JST socket J2. A v2 snap-in battery sled with its own spring contacts can then power
   the pod without tools (owner decision: modular, swappable cells). Placed on the two largest free spots of the
   bottom face, 16 mm apart, far from the antenna end: TP15 at (105.2, 107.0) under the Tag-Connect footprint
   (TC2030-NL has no legs, so nothing comes through), TP16 at (109.0, 122.9). The sled's + goes through the AO3401A
   like the plug, so a reversed sled is blocked too. **Use one cell at a time (plug or sled), never both.** A swap
   without a hold-up cap restarts the pod (about 1 s plus a BLE reconnect); the flash buffer covers it.
2. **Electrode tab without overhang**: the right-angle 1x10 header that stuck out past the pod edge is replaced by
   an upright SMD 2x5 2.54 mm header on the tab's top face. The tab is L-shaped and stays inside the pod outline:
   the grid part (x 100-110.4) plus a foot over the pod's low parts (all <= 1.25 mm; the tab rides 3.0 mm up) that
   stops 0.5 mm short of the JST socket and clear of the antenna end. All tab traces are on F.Cu (the pod side
   carries only the contacts), so the header pin order is whatever routes planar; `route_tab.py` finds it and the
   silkscreen prints it.
3. **Charger tab unchanged**: inside the outline its USB-C shell legs would land on C28 or the JST socket. It is only
   attached while charging, so it keeps its overhang.

## 3. Values and their sources

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

## 4. Pin map: NINA-B306 ↔ ADS1298 and the rest

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

All other module pins have no-connect flags.

## 5. Firmware rules the hardware depends on

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

## 6. Layout (rev 0.4 board, 2026-10-14)

Rebuild everything with `hw/pod/build.sh`:

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

- **Board:** 24 x 30 mm, **6 layers**: F.Cu / In1 GND / In2 sig / In3 sig / In4 GND / B.Cu, parts on both
  sides. The owner chose 24 x 30 after 22 x 28 measured 76 % courtyard density (893 mm2 of parts). Six
  layers instead of four (about $10-30 more per order) because:
  - on four layers the autorouter left 8-27 nets open in every attempt;
  - an In2 +3V3 plane split into islands;
  - six layers give each assembled side its own solid ground plane.
  The 150 mAh pouch (19.75 x 26.0 x 3.8) sits against the bottom side.
- **Top:**
  - NINA-B306 at the top edge, antenna outward (footprint rotated 180 deg), with an all-layer copper
    keep-out under its antenna end;
  - 3 x 4 pogo grid (3.0 mm pitch, P1-P3 / P4-P6 / P7-P9 / P10-P12, P11 VBUS + P12 GND adjacent), with
    an M2 NPTH clamp hole at each end;
  - Tag-Connect between H1 and the grid;
  - VBUS TVS under P11;
  - flash directly under the module's QSPI pin row;
  - charger, FET, JST SH socket (opening at the bottom edge);
  - the boot pull resistors and battery divider in two columns at the right edge.
- **Bottom:**
  - ADS1298 under the module;
  - every decoupling cap 2 mm outside its own pin, with a **locked** pad-to-pin route;
  - VREFP 10 uF and VCAP1 22 uF (0805) in a second row, lined up on free gaps;
  - the 10 filter rows (bead, 2.2k, 1 nF) under the pogo grid in ADS pin order, ESD arrays in the
    grid-area corners;
  - both LDOs, with EN tied to IN on a locked route;
  - 0.8 mm test and expansion pads.
- **Clamp:** the electrode tab and the charger tab screw down on 3.0 mm M2 nylon spacers (pogo
  working height 2.9 mm). Hole keep-out is r 2.1 mm on both sides (spacer on top, screw head below).
- **Tabs:**
  - the pod-facing side carries only the contact pads, so a pogo tip can't press through the mask onto
    other copper;
  - the charger tab's USB-C (through-hole shell) sits in an overhang left of the pod outline; the electrode tab
    stays inside it (rev 0.5);
  - electrode tab header (rev 0.5, upright SMD 2x5, pin 1 top left, odd pins left column): 1 REF, 2 E4, 3 E2,
    4 E5, 5 E8, 6 E1, 7 BIAS, 8 E7, 9 E3, 10 E6. The order is the one that routes on the top layer alone; the
    silkscreen prints it beside the header.
- **Rules (JLCPCB 6-layer standard):**
  - signals routed at 0.10 / 0.10 mm; necked tracks widened to the 0.09 mm minimum;
  - DRC uses 0.09 mm space;
  - vias 0.45 / 0.20 mm;
  - via hole to copper 0.20 mm (confirm in review);
  - copper to edge 0.30 mm;
  - charge path (VBUS, +BATT, BAT_RAW) 0.20 mm tracks.
- **Ground:** every GND SMD pad gets its own stub and via where one fits. The pads listed in the review
  README reach ground through the pour plus stitching vias, and DRC confirms them connected.

## 7. Datasheet check, 2026-10-07 (PDFs in hw/pod/ref/ds/, read by Claude)

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

## 8. Questions for the reviewers (TI E2E, r/PrintedCircuitBoard)

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
