rkrafted/silent-speech/tracks/01-sota-companies.md

Track 01-sota-companies. State of the art and the companies.
- MIT AlterEgo (Kapur, Kapur, Maes, IUI 2018) and follow-ups (Kapur 2019/2020 thesis, the clinical/MS paper):
  exact electrode sites, channel count, AFE, sample rate, vocabulary, accuracy, how "silent" it is
  (internal articulation vs mouthing).
- The AlterEgo company (2025 relaunch?) and any company called "Subvocal" or similar; what they publicly
  claim, what the hardware looks like, funding, patents (search Google Patents for Kapur / AlterEgo).
- Other players: Meta/CTRL-labs sEMG wristband (Nature 2025 "generic non-invasive neuromotor interface"),
  Augmental, Wispr (pivoted?), startups doing silent speech with ultrasound, radar, in-ear, cameras.
- Academic SOTA in silent speech: Gaddy & Klein "Digital Voicing of Silent Speech" (EMNLP 2020) and the
  2021 follow-up, Benster et al. "MONA LISA" / LLM-assisted silent speech (2024), EMG-UKA corpus,
  Wand/Schultz work at KIT/Bremen, Chinese groups (wearable sEMG silent speech 2023–2026), any 2025–2026
  best results (WER on open vocabulary).
Produce a comparison table: system | modality | sensor sites | channels | vocab | silent/mouthed | result | year.
Output: research/01-sota-companies.md
