rkrafted/silent-speech/tracks/02-modalities.md

Track 02-modalities. Which sensing modality fits "decodes silent speech AND is nearly invisible on the face"?
Compare with numbers and sources: facial/submental/neck surface EMG; ultrasound tongue imaging;
permanent-magnet articulography (PMA: small magnets on/in tongue/lips + magnetometers — MVOCA, Gonzalez,
Gilbert, Hofe et al.) and EMA; in-ear sensing (ear-canal deformation, in-ear EMG, in-ear microphones
for "non-audible murmur"); NAM microphones / throat or skin accelerometers (whispered/murmur, not truly
silent); radar / RF / Wi-Fi / mm-wave lip & jaw sensing; strain sensors and e-skin on the throat;
camera/visual speech recognition (lip reading, incl. from a glasses-mounted or downward camera);
EEG (and why it fails for this).
For each: how silent can the user be, best demonstrated accuracy and vocabulary, sensor placement,
visibility on the face, maturity, and DIY feasibility. Finish with a ranked recommendation for this
owner's constraints and a note on fusing two modalities (e.g. sEMG + in-ear or sEMG + IMU).
Output: research/02-modalities.md
