rkrafted/silent-speech/tracks/04-electrodes-formfactor.md

Track 04-electrodes-formfactor. Making it nearly invisible on the face, non-invasively.
- Which muscles/sites carry the most silent-speech information (AlterEgo's sites; Gaddy's 8 sites;
  ablation studies on fewer channels; submental/under-chin and jawline sites that are hidden from front view).
- Electrode tech: wet Ag/AgCl vs dry vs textile vs hydrogel; ultrathin epidermal / "electronic tattoo"
  electrodes (graphene e-tattoos — Akinwande/Lu groups; gold tattoos; Rogers-style epidermal electronics),
  skin-coloured or transparent electrodes, their impedance, wear time, sweat, adhesion, irritation.
- Concealed form factors: hidden along the jawline/under chin with thin flex interconnect to a behind-ear
  pod (hearing-aid style), glasses-temple integration, in-ear/around-ear electrodes (cEEGrid-style),
  beard/collar concealment, neck-band. Any published silent-speech system using only behind-ear/around-ear
  or under-chin sites, with accuracy.
- Daily-wear practicalities: reapplying tattoos/patches, signal drift across sessions, re-calibration.
Finish with 2–3 concrete concealed layouts (sites, electrode type, where the electronics pod sits) ranked
by invisibility vs expected accuracy.
Output: research/04-electrodes-formfactor.md
