rkrafted/silent-speech/tracks/06-implant-option.md

Track 06-implant-option. The owner accepts a SMALL SUBDERMAL implant (skin-level, not brain/nerve) if it
buys invisibility. Research honestly what exists and the real risks:
- Implantable EMG sensors: Alfred Mann Foundation IMES (implantable myoelectric sensors for prosthetics),
  other implanted myoelectric systems (e.g. MyoPlant, Ripple, Phantom Neuro 2024–2026), subdermal needle /
  wire EMG; any use for facial or speech muscles.
- Permanent-magnet articulography with implanted vs glued magnets (tongue/lip), clinical work for
  laryngectomy patients (Gilbert, Gonzalez, Hofe; Sheffield/Hull MVOCA), and biohacker magnet implants
  (finger magnets): migration, coating failure, MRI incompatibility.
- Subdermal electrodes / biohacking implants (NFC/RFID chips, Northstar), who implants them, infection
  and rejection rates, facial-specific risks (facial nerve branches, scarring, visibility).
- Regulatory reality: such devices are medical devices; a surgeon vs body-mod artist; what can be done
  legally in the EU (owner lives in Latvia).
- Does an implant actually improve signal over good surface electrodes for this use? Evidence.
Give a clear verdict: is any implant route worth it versus concealed epidermal electrodes, and if yes,
which one and with which professional.
Output: research/06-implant-option.md
