rkrafted/silent-speech/tracks/07-prior-art-diy.md

Track 07-prior-art-diy. Who already built a DIY / open AlterEgo-style silent-speech device, and what can be
reused? Search GitHub (sort by stars and recent), Hackaday.io, Hackster, OpenBCI forum/community,
Reddit (r/BCI, r/OpenBCI, r/biohackers), YouTube "I built AlterEgo"/"silent speech EMG", theses and
student projects (2018–2026). For each: link, hardware used, channels, electrode sites, vocabulary,
reported accuracy, code/license, what went wrong. Include commercial dev kits that make it easier
(OpenBCI, BioAmp, Mindrove, Myoware 2.0, Delsys) and their limits.
Finish with: the best 3 things to fork or buy to get a first working closed-vocabulary prototype fast.
Output: research/07-prior-art-diy.md
