rkrafted/silent-speech/tracks/08-ear-region.md

Track 08-ear-region. EVERY silent-speech (or jaw/tongue-activity) sensing idea located at or near the ear, because the
owner wants a hidden hearing-aid / earbud / headphone form factor. Already known (do not just repeat; go deeper and wider):
headphone-earmuff textile EMG 96% on 10 silent words (arXiv 2504.13921); AESSI around-ear cEEGrid 92.24% on 25
Mandarin sentences (arXiv 2609.21436); EarSSR, EarCommand (ear-canal deformation); QuietSync; Naqi Logix in-ear;
The Subvocal Company (is it behind-ear or under-chin? settle it from their own site/YC page).
Cover, with numbers (vocab, silent vs mouthed, accuracy, channels, users) and sources:
- In-ear / ear-canal EMG and ear-EEG electrodes (IDUN, Naox, NeuroBuds, Neurable, Mentalab, cEEGrid, custom silicone
  earmolds with electrodes, dry in-ear electrodes), and whether they pick up jaw/tongue/speech muscle activity.
- Behind-the-ear and mastoid sites; posterior auricular, masseter, temporalis, digastric posterior belly, sites just
  below the earlobe / behind the jaw angle. Which speech-relevant muscles are reachable within ~3 cm of the ear.
- Ear-canal deformation sensing (pressure, optical, acoustic/ultrasonic echo in the canal), in-ear microphones for
  murmur/non-audible murmur, in-ear IMU / bone-conducted vibration, earable acoustic sensing of jaw/tongue.
- Hearing-aid form factors: RIC/BTE/CIC dimensions, how a hearing-aid shell could host electrodes + AFE + battery;
  custom earmold printing (biocompatible resins), commercial hearing-aid-style EEG/EMG devices.
- Combinations: ear electrodes + one thin strip/e-tattoo running from behind the ear under the jaw.
Finish with a ranked list of ear-region designs (invisibility, expected accuracy for commands vs dictation, DIY
difficulty) and the exact experiment to run first.
Output: research/08-ear-region.md
