rkrafted/silent-speech/tracks/09-etattoo-diy.md

Track 09-etattoo-diy. Electronic tattoo / epidermal electrodes the owner can MAKE or BUY in weeks, for silent-speech
sEMG under the chin, along the jaw and behind the ear.
- Fabrication routes with recipes and equipment: graphene e-tattoo (wet transfer onto tattoo paper), gold/gold-nanomesh,
  laser-cut / "cut-and-paste" Cu or Au on polyimide/PET (Lu group), inkjet/screen-printed PEDOT:PSS or silver ink on
  commercial temporary-tattoo paper, PEDOT:PSS + ionic liquid, drawn-on / "on-skin printed" electrodes, liquid-metal.
  What a hobbyist with a fiber/CO2 laser, inkjet printer, or makerspace can do; what needs a cleanroom.
- Commercial or semi-commercial suppliers of tattoo/epidermal electrodes or ultrathin EMG patches (2024–2026), prices.
- THE INTERCONNECT problem: how tattoos are connected to rigid electronics (ACF tape, conductive adhesive, FPC
  bonding, magnetic snaps, printed traces to a connector pad), and which designs survive jaw motion and speaking.
- Measured performance: skin-electrode impedance vs Ag/AgCl gel, SNR for facial EMG, wear duration, sweat, shaving,
  removal, skin reactions; any silent-speech or facial-EMG validation (e.g. Liu et al. Cu/PI patch).
- Skin-tone / transparent options and how visible each is in practice.
Finish with a concrete DIY recipe for a first under-chin + jawline tattoo array (materials, steps, cost, interconnect),
and a fallback commercial option.
Output: research/09-etattoo-diy.md
