rkrafted/silent-speech/research/09-etattoo-diy.md

# Track 09 — E-tattoo / epidermal electrodes the owner can make or buy in weeks

*Research notes for a personal R&D silent-speech wearable. Inline `[n]` citations map to the
numbered Sources list at the end. Demonstrated results are separated from claims/marketing. All
numbers are quoted exactly as the source gives them. Pages I could not fetch myself are marked
"unverified" and are cited only as described by a source I did fetch.*

*Scope: epidermal/e-tattoo electrodes for under-chin, jawline and behind-ear sEMG. Fabrication
routes a hobbyist with a fiber/CO2 laser, inkjet printer, screen-printer or makerspace can execute;
what needs a cleanroom; commercial suppliers and prices 2024–2026; the interconnect problem (how a
tattoo connects to rigid electronics); measured performance vs Ag/AgCl; skin tone/visibility; a
concrete first DIY recipe; a fallback commercial option.*

Status: COMPLETE (v4) — all sections written from fetched sources, including a vendor-verified
supplier/price table (§3, observed 2026-10-01). Length exceeds the suggested 2,000–5,000-word
target because the track contains many independent verified numbers (thicknesses, impedances,
SNRs, cycle counts, accuracies); nothing unverified is presented as fact.

---

## 1. What "e-tattoo" means here, and the decision it drives

An "electronic tattoo" (e-tattoo, epidermal electrode) is a conductive pattern on an ultrathin
polymer film that is transferred to skin with water like a child's temporary tattoo. The films that
work are **sub-micrometre to a few micrometres thick**, which is the whole point: a film that thin
has a bending stiffness low enough to follow skin ridges and creases instead of bridging them, so
it couples to skin by van der Waals forces with no gel and no strap [2][3].

Three thickness classes show up repeatedly in the primary literature, and they map directly onto
what the owner can do:

| Class | Total thickness | Example | Minimum kit |
|---|---|---|---|
| True e-tattoo | 0.45–1.5 µm | cut-and-paste Au/Cr/PET on tattoo paper [2]; inkjet PEDOT:PSS on ethylcellulose [4] | cutter plotter + tattoo paper (+ sputter coater) |
| Thin epidermal patch | 5–20 µm | Ag-In-Ga printed on tattoo paper [6]; Cu/PI serpentine on wound dressing [1] | screen printer / photolithography |
| Ultrathin nanomesh | ~65 nm gold mesh | electrospun PVA + Au [9] | electrospinner + sputter coater (makerspace) |

For this build the useful threshold is **≤ 5 µm total**, because that is where the papers stop
needing adhesive tape and start reporting gel-comparable behaviour on curvy, hairy, moving skin
[2][4][7].

**What matters for the owner's face/chin array** (the four constraints this track must answer):

1. **Conformability → impedance.** On a curved jaw/chin, a stiff patch lifts at the edges; the
   contact area collapses and impedance rises. Conformability, not the electrode's own
   conductivity, is what lowers skin–electrode impedance [6].
2. **Interconnect.** The tattoo is ~1 µm; the amplifier/PCB is ~1 mm. Every published system has
   to solve the soft-to-rigid transition, and several do it with tooling the owner can buy [1][2][4][5][7].
3. **Durability under jaw motion and speech.** The jaw and chin move constantly. The relevant
   published numbers are strain-at-failure and multi-day stretch cycling [2][4][5].
4. **Visibility.** Sub-micrometre films are effectively invisible; the connector is the visible
   part, and users consistently report they feel the connector, not the tattoo [4].

The rest of this file resolves those four constraints and ends with a buildable recipe.

---

## 2. Fabrication routes, ranked by hobbyist feasibility

### 2.1 Route A — "Cut-and-paste" Au/Cr on PET over commercial tattoo paper (best first build)

This is the Lu group's low-cost tape-free e-tattoo, and it is the single most hobbyist-reproducible
route in the literature [2]. The full process, quoted from the paper:

1. Peel the liner off **commercial tattoo paper (Silhouette, USA)**.
2. Laminate a **1.4 µm transparent PET sheet (PolyK Technologies)** onto the tattoo paper; dry on a
   hotplate at **50–60 °C for ~5 min**.
3. Deposit **10 nm Cr + 100 nm Au** by thermal evaporation (Au chosen for biocompatibility,
   chemical inertness and ductility; Ti is named as a cheaper but less ductile alternative).
4. Pattern with a **programmable mechanical cutter plotter (Silhouette Cameo)** loaded with an
   AutoCAD design — the paper states sharpness 5, cutting rate 2, thickness 1. Ribbon width was
   **600 µm, "as limited by the patterning resolution of the cutter plotter."**
5. Wet the tattoo paper to partially dissolve the water-soluble adhesive and peel away the
   extraneous Au/Cr/PET, leaving serpentine ribbons.
6. Moisten skin, laminate the tattoo paper, slide it off (sliding works better than peeling), and
   the **1.5 µm** open-mesh tattoo adheres by van der Waals forces alone.
7. Optional: **spray 3M Nexcare liquid bandage five times** to build a **~1 µm** transparent
   encapsulation (each spray ≈ 200 nm).

Demonstrated properties: the serpentine ribbon stiffness is **115 N/m**, comparable to epidermis at
**160 N/m** (160 kPa modulus, 1 mm thick); the device measured two ECG electrodes, one RTD and two
hydration sensors on a **7.5 cm × 4.0 cm** footprint; the paper reports reduced motion artifacts vs
thicker e-tattoos and gel electrodes, and no sweat accumulation because the mesh is open [2].

**Hobbyist verdict: yes, with a makerspace.** The only non-household tool is the thermal evaporator
for Cr/Au. A makerspace/university will run it; a cheap alternative is commercial Au/PET or
Cu/PET sheet (the paper itself uses 13 µm Au/PET from Rotex Tech for the connector strips). The
paper notes the cutter can also pattern Al/PET, carbon-doped PDMS, graphene/PMMA and ITO/PET [2],
so the owner is not locked to gold.

**This route has already been used for silent speech, on the target muscles.** Wang et al. 2021
built a 4-channel array from the same "Cut and Paste" method, **1.2 µm thick**, integrated in a
**47 µm 3M Tegaderm patch**, with the four pairs on **levator anguli oris (LAO), depressor anguli
oris (DAO), buccinators (BUC) and anterior belly of digastric (ABD)** — the last is the under-chin
muscle this project needs [21]. Design details: filamentary serpentines **500 µm wide**, ribbon-
width-to-arc-radius ratio **0.32**, arc angle **20°**, giving "4 % elastic stretchability" by
theory, which the authors then extend with an "electricity-preferred" method; each electrode is
about **18 mm × 32 mm**; and the electrode-to-wire joint is reinforced by "**low-temperature alloy
welding**" to survive all-weather use [21]. That paper is the single most on-point reference in
this whole track; its recognition results are in §5.3.

### 2.2 Route B — Screen-printed carbon + plasma-polymerised PEDOT on tattoo sheet (best for the face)

The Hanein group's process is designed exactly for hairy, curved, long-wear facial sites and is
the most directly relevant to an under-chin/jaw array [7]:

1. Screen-print carbon ink onto a **temporary tattoo sheet**.
2. Laser-cut a **double-sided adhesive film** into a passivation layer and bond it to the array.
3. **Plasma-polymerise EDOT (ppEDOT)** onto the exposed carbon to cut impedance.
4. Glue a **polyimide film with holes** to the array so the whole thing **fits a zero insertion
   force (ZIF) socket** on a custom PCB. That is the entire interconnect.

Electrode area is **20 mm²** (down to **5 mm diameter**); the ppEDOT coating raised specific
capacitance from **0.018 to 1.6 ± 0.1** (12 W) and **3.3 ± 0.2 mF cm⁻²** (90 W), and **at 1 kHz
coated electrodes had ~10× lower impedance than pristine carbon, which in turn had ~10× larger
impedance than gelled electrodes**; because the commercial gel electrodes had **15× the area**,
their *specific* impedance was similar [7].

**Hobbyist verdict: yes.** Screen printing can be done with a laser-cut stencil and a squeegee; the
only specialist step is the plasma polymerisation. The paper's plasma is described as a simple
solvent-free room-temperature process [7], but a plasma chamber is a makerspace tool. If plasma is
unavailable, use a commercial PEDOT:PSS inkjet ink instead (Route C) — but then expect the higher
impedance Ferrari et al. measured [4].

### 2.3 Route C — Inkjet-print PEDOT:PSS on commercial tattoo paper

Ferrari et al. established the canonical recipe [4]:

- Substrate: decal transfer paper with a **~450 nm ethylcellulose (EC)** release layer over a
  starch–dextrin sacrificial layer.
- Ink: waterborne **PEDOT:PSS** dispersion, filtered at **0.20 µm**, printed with a **Dimatix
  DMP-2800** using a **10 pL** cartridge.
- Interconnects: **Au sputtered** (70 W, 2 × 10⁻² argon, 1 min for 30 nm) plus a **13 µm Kapton**
  flat connector tab glued with the kit's acrylic glue sheet (~700 nm).
- Stacking more PEDOT:PSS layers took the electrode from **h ≈ 600 to ~1200 nm** and dropped sheet
  resistance from **520 to 50 Ω/sq**.

A simpler follow-up from the same group inkjet-prints **PEDOT:PSS Clevios P Jet 700 + 10 % vol
glycerol** and screen-prints stretchable **Ag paste CI-1036** interconnects (baked **120 °C for
10 min**) [5].

Ferrari et al. also give performance for this stack: **ECG SNR 6.45 (tattoo) vs 7.52 (standard
gel)**, and facial EMG rest **3.0 µV** / active **50.6 µV** (tattoo) vs **1.9 / 72.5 µV**
(Ag/AgCl) [4]. The paper does **not** state an annealing/drying temperature in the main text;
treat any cure schedule as **unverified** [4].

**2.3b Route C2 — PEDOT:PSS + ionic liquid, screen-printed (concrete, high-density recipe)**

Velasco-Bosom et al. published a complete, verifiable recipe for a high-density sEMG array [14]:

- Ink: **PEDOT:PSS Clevios 1 wt % + 40 wt % cholinium lactate (IOLITEC) + 1 wt % GOPS**, vortexed
  and filtered at **0.45 µm**.
- Deposition: drop-cast **1.8 µL** per well, dry overnight, **×3**, then **hard-bake 130 °C for
  60 min**, then soak overnight in DI water.
- Tracks: **Sicrys 130EG-1** Ag ink, dry 40 °C, **sinter 120 °C for 60 min**, on **50 µm Kapton**.
- Performance: **2.7 MΩ at 60 Hz** for 2.25 mm², **0.3 MΩ** for 12.56 mm² (**48 kΩ·cm²**
  normalised), vs Ag/AgCl **17 kΩ**; EMG **SNR = 6 (15.6 dB)**; total array thickness **170 µm** [14].

The 170 µm thickness is far from an e-tattoo and the impedance is high, but this is the most
copyable *printed* recipe found, and the ionic-liquid additive is the current best practice for
lowering conducting-polymer impedance.

**Hobbyist verdict: yes, with a printable-ink printer.** PEDOT:PSS is water-based and can be run
through a modified inkjet printer, but clogging and substrate wetting are the failure modes;
Ferrari notes the substrate "strongly influence[s]" print quality and that glycerol additive
improved both print quality and conductivity [5]. A Dimatix is a lab instrument, but the underlying
chemistry is hobby-accessible (AgIC-style conductive inkjet paper is the consumer version).

### 2.4 Route D — Printed silver + liquid-metal (Ag-In-Ga / EGaIn) tattoo

Lopes et al. print silver nanoparticle ink (Mitsubishi) on **Silhouette printable tattoo paper**,
then rub **EGaIn** over the pattern and clean the excess with weak acetic acid, forming a
non-smearing **Ag-In-Ga** alloy that stretches **over 100 %** [6]. The carrier film is **5 µm**.
In their head-to-head test of seven soft electrode types against Ag/AgCl and stainless steel:

- The **tattoo electrodes had the highest SNR and the lowest electrode–skin impedance at low
  frequencies**, attributed to the alloy's malleability and the 5 µm carrier [6].
- Ag-In-Ga tattoos "can be rapidly printed at low cost with accessible equipment" [6].

**Hobbyist verdict: yes** (screen/stencil print + rub), but EGaIn is messy and gallium wets many
metals; keep it away from the electronics. A simpler drawable version: Yu et al. paint a Ga-based
liquid-metal ink (oxygen concentration **0.34 %**, resistivity **44.1 µΩ·cm**, peak polarisation
voltage in saline **−0.73 V**) straight onto skin with a paintbrush and record ECG "as good as …
conventional electrodes", but the authors note it "can be printed and erased easily" — i.e. it
smears [15]. The long-contact cytotoxicity of Ga-In is an **open question** in the literature
(the 2018 cytotoxicity paper is paywalled, so its numbers are **unverified** here) [18][19]. For an
under-chin array that must survive speaking, liquid metal is a poor first choice without an
encapsulation frame.

### 2.5 Route E — Gold nanomesh (needs a makerspace, not a cleanroom)

Miyamoto et al. fabricated a **~65 nm-thick gold nanomesh** on an electrospun PVA nanofiber mesh
(as described in [2]'s account of that work). The abstract states the result: a **one-week skin
patch test** showed inflammation risk "can be significantly suppressed by using the nanomesh
sensors", the sensors are gas-permeable and stretchable, and EMG was recorded "with minimal
discomfort" [9]. A secondary account of the method describes electrospinning water-soluble **PVA**
microfibres, vacuum-depositing a gold layer "**bis zu hundert Nanometer dünne Goldschicht**"
(up to ~100 nm), laminating to skin, then washing the PVA away with water so a gold nanowire mesh
remains held by van der Waals adhesion; the same secondary report gives "**tausendfachen Dehnungen
um bis zu vierzig Prozent**" (1000 cycles to 40 %) and one-week wear without irritation [16]. The
**full paper is paywalled and its abstract elides the numbers**, so the nanomesh thickness,
cycle count and wear claims are **secondary/unverified** — only the abstract quotes in [9] are
primary-confirmed here.

**Hobbyist verdict: yes-with-makerspace.** Electrospinning (high voltage) plus vacuum Au deposition
(e.g. a Q150T-class sputter coater) are makerspace/university tools; no cleanroom is required. This
is the best *biocompatibility* benchmark but a harder first build than Routes A/B.

### 2.6 Route F — Graphene electronic tattoo (makeable if you buy the graphene)

The GET is more accessible than its cleanroom reputation suggests, because the graphene can be
bought instead of grown [10][11]. Verified numbers from the original paper: total thickness
**463 ± 30 nm**, optical transparency **~85 %**, stretchability **more than 40 %**, and dry-electrode
impedance "on par with medically used silver/silver-chloride (Ag/AgCl) gel electrodes"; a bare GET
"stay[s] attached to skin for several hours", and with liquid bandage "**up to several days**" [20].
The fabrication is the cost- and time-effective "**wet transfer, dry patterning**" method [20].

The step-by-step lab protocol exists (**Nature Protocols 2021**, paywalled), and its own supplement
confirms the key steps: **Step 18** reversing the graphene; **Step 21** shaping the GET with a
**Cameo plotter**; **Step 22** removing excess graphene; **Step 24-A** contacting via **copper
tape** or **24-B via silver epoxy**; **Step 25** troubleshooting transfer on skin [10]. The copper
etchant is **ammonium persulfate** — the protocol carries the caution "Ammonium persulfate is
corrosive. Wear personal protective equipment and work in a fume hood" [10]. The precursor for
GET 2.0 is "Single-layer graphene-on copper (Cu) substrate grown by the chemical vapor deposition
… purchased from **Grolltex**" [11]. Ferrari's review describes the GET carrier as **~440 nm PMMA**
or **~13 µm polyimide**, transferred to tattoo paper or medical adhesive, cut into ribbons, and
released with water [4]. The npj paper adds that a cutter plotter can pattern **graphene/PMMA**
directly [2].

**Hobbyist verdict: yes-with-makerspace.** Buy graphene-on-Cu from a supplier (no cleanroom);
the etch needs a **fume hood**; a spin coater, hotplate, blade cutter (Silhouette Cameo) and
temporary tattoo paper complete the kit. The payoff is the best combination of transparency,
stretchability and impedance in this whole file.

### 2.7 Route G — Laser-induced graphene on polyimide (consumer CO₂ laser)

Sun et al. laser-scribe porous graphene on polyimide and report (abstract-verified): **sheet
resistance 10.96 Ω sq⁻¹**, **failure strain ≈ 330 %**, **modulus ≈ 15 kPa**, resistance change
**≈ +7 %** after 500 bend cycles at 2.5 mm radius and **≈ +1 %** after 1000 cycles at 500 % strain,
and **7 days on skin without inflammation** [12]. The Lu paper independently cites laser-induced
graphene's use for an "intelligent artificial throat" [2, ref 51].

The attraction is that a **consumer CO₂ laser (K40/xTool class)** does the patterning with no
chemicals and no ink. Real maker numbers exist for the laser step: the original Tour-group LIG used
a **4.8 W CO₂ laser on polyimide in ambient air** [42], and a Glowforge owner reported that
**2 mil Kapton tape at 1 % power / speed 45 / 675 LPI / 0.030″ defocus** gave **15 Ω** on a
0.5 mm square, with a revised recipe of **11–25 % power at speed 640 / normal focus** reaching "as
low as **10 Ω**"; the same maker found the material "very fragile" and that **probing flakes it
off**, and concluded **5 mil polyimide** is needed rather than 1 mil [33]. A separate maker's
405 nm-laser Kapton supercapacitor build produced **156 µF / 0.8 V** per cell, with a commenter
reporting **uneven burn and continuity breaks** on a cheap laser [32].

The remaining gap: I found **no primary study validating LIG electrodes for facial sEMG**
(impedance, SNR, crosstalk, motion artifact). Treat the EMG performance as **unverified**.
Because Route A gets the same "laser + polyimide" convenience with published facial-EMG-grade
behaviour [2][21], LIG is a second or third experiment, not the first.

### 2.8 Route H — Conductive paint / drawn-on electrodes (proof-of-life only)

Bare Conductive Electric Paint and silver conductive paint can be stencilled onto skin or a tattoo
film. They are cheap and immediate, but I found **no primary source** quantifying their
skin–electrode impedance, noise or motion-artifact performance for facial sEMG; treat as
**unverified**. The maker record is the reality check: Chip Audette's homemade passive EEG
electrodes made from **flat metal lock washers with solder tabs** cost **$0.24 each** (about
**$1.10/electrode** vs **$8–20** commercial), produced clean ECG R/T waves ("a bit noisier" than
real electrodes) and clear EEG alpha, but **weak Mu rhythm**, heavy **60 Hz noise** without a
driven ground, and **poor adhesion** because the washer ring was too narrow. His rule of thumb was
**< 5 kΩ per electrode** and **< 10 kΩ across a pair** [38]. A Hackaday builder got usable EMG from
**duct tape + stripped wire + 5 cm × 1 cm aluminium foil with sugar syrup as electrolyte**, with
commenters flagging 50/60 Hz hum and no driven-ground feedback [39]. Note the paper finding that
electrode material conductivity correlated *less* with SNR than conformability did [6], so a thick
painted electrode is likely to underperform even with low bulk resistance.

### 2.9 Route ranking summary

| Route | Equipment | Reported impedance/SNR | Verdict |
|---|---|---|---|
| A. Cut-and-paste Au/Cr/PET [2][13] | cutter plotter + evaporator | [13]: >110 % strain, 10 000 cycles at 20 %; not measured for facial sEMG | build this first |
| B. Screen carbon + ppEDOT + ZIF [7] | screen printer + plasma + laser | 1 kHz: 10× better than carbon, ~10× worse than gel; specific impedance ≈ gel | build for face |
| C. Inkjet PEDOT:PSS [4][5] | inkjet + sputter (or Ag paste) | 60 Hz 294 ± 1 kΩ vs gel 102 ± 2 kΩ; ECG SNR 6.45 vs 7.52 | good, higher Z |
| C2. PEDOT:PSS–ionic liquid printed [14] | screen printer + 130 °C oven | 60 Hz 0.3–2.7 MΩ (area-dependent); EMG SNR 6 | concrete recipe, thick |
| D. Ag-In-Ga printed [6] / drawable LM [15] | stencil/screen + EGaIn; or brush | highest SNR of 7 soft types [6]; 44.1 µΩ·cm ink [15] | good, messy, cytotoxicity unverified |
| E. Au nanomesh [9][16] | electrospinner + sputter coater | inflammation-free 1 week (abstract); 40 % cycles (secondary) | benchmark |
| F. Graphene GET [20][10][11] | cutter + fume hood (buy graphene-on-Cu) | 463 ± 30 nm, ~85 % transparent, >40 % stretch, impedance ≈ Ag/AgCl | best all-round, more steps |
| G. LIG on PI [12] | consumer CO₂ laser | 10.96 Ω/sq, ≈330 % strain, 7 days on skin | promising, facial-EMG unverified |
| H. Conductive paint | none | unverified | avoid for now |

---

## 3. Commercial suppliers and prices

Prices were observed on **2026-10-01**; sources fetched directly by me are marked "(verified)",
those fetched by a delegated search pass are marked "(via sub-search)" and quoted as reported. No
price is invented; anything not confirmed is marked **unverified**.

### 3.1 Home-fabrication consumables (the tattoo substrate and inks)

| Item | Price | Notes |
|---|---|---|
| **Silhouette Temporary Tattoo Paper**, 8.5 × 11 in, **2 sheets** | **"As low as $9.99" USD**, in stock (verified by sub-search at the official store) [45] | the substrate used by [2][7][22]; sold to individuals |
| Same item at 3D Jake (CH) | **CHF 10.05** [46] | international alternative |
| **Hayes Paper waterslide decal paper**, 40 sheets | **$27.99** [47] | this is *decal* paper, not confirmed as tattoo paper — the tattoo-specific Hayes product is **unverified** |
| **The Magic Touch Tattoo 2.1** (the exact paper in [4]) | **unverified** | not confirmed as individually purchasable |
| **Bare Conductive Electric Paint**, 10 mL | **$13.50** at SparkFun (via sub-search) [48] | Adafruit explicitly warns "not intended for use on your bare skin" [49] |
| **MG Chemicals 842AR** silver conductive coating, 150 mL | **unverified** | Faraday/EMI-shielding paint, not skin-rated |
| **NovaCentrix Metalon** conductive inks | no public price | quote/webstore account only [50] |
| **AgIC inkjet conductive paper** | **unavailable** | the domain now redirects to Elephantech; no consumer product found [via sub-search] |
| **DuPont/Celanese Micromax PE872** | **unverified** | enterprise/licensed MOQ |

**Practical read:** a DIY substrate + conductive layer is cheap and purchasable (tattoo paper at
~$10 per 2 sheets), but **none of the skin-rated conductive inks from the papers are sold in
consumer quantities**. The gold/Cr (Route A/F) and PEDOT:PSS (Route C) routes will need a
makerspace's evaporator/inkjet, or the conductive layer bought as PET/Au film.

### 3.2 Dry / ultrathin EMG electrodes (the closest buyable thing to an e-tattoo)

| Product | Price | Notes |
|---|---|---|
| **OpenBCI / IDUN Dryode Alpha Kit** — flexible waterproof dry electrode, ECG/EMG/EEG | **$224.99 (1 m lead) / $244.99 (1.5 m)** (verified: the $244.99/1.5 m price is on the OpenBCI page) [51] | 10 electrodes + 10 adhesive patches + snap cables; **out of stock on 2026-10-01**; contact area **20 mm diameter**, quoted impedance **~3.2–5.2 kΩ**; sold to individuals |
| **OpenBCI EEG Polymer Electrodes Kit** — 8 dry conductive-polymer electrodes + headband | **$199.99** [52] | ~30 in stock; EEG-oriented but polymer dry electrodes |
| **SparkFun MyoWare 2 Muscle Sensor** — EMG amplifier board | **$42.95** (verified at SparkFun) [53] | **uses gel electrodes, not dry/epidermal**; dev kit **$154.95** [54] |
| **g.tec g.SAHARA** hybrid dry EEG electrodes | **unverified** (quote-based) [55] | |
| **TMSi Textile HD-EMG Grids** | **unverified** (quote-based) [56] | textile, not tattoo |
| **Delsys Trigno, CGX/Cognionics, BioSemi, Neuroelectrics** | **unverified** (enterprise/quote) | CGX has a dry EEG developer kit page with no public price [57] |

### 3.3 Ag/AgCl gel baseline (for comparison and for the fallback pipeline)

| Product | Price | Per-electrode |
|---|---|---|
| **Rhythmlink Disposable Single Recording Sticky Pad EMG**, 80/box | **$94.37** [58] | ≈ $1.18 |
| **Kendall Ag/AgCl Ø55 mm**, 30 pcs | **€8.30/bag** [59] | ≈ €0.28 |
| **Covidien/Kendall H124SG** ECG electrode, 500 pcs | **€109.90** [60] | ≈ €0.22 |
| **Vermed A10005** foam electrode | **$129.66** [61] | pack size **unverified** |
| **Ambu BlueSensor N** | **unverified** price | datasheet confirms Ag/AgCl solid gel [62] |

### 3.4 Is there a vendor selling an actual e-tattoo / epidermal EMG electrode?

**No.** Across the search performed, **no consumer or small-quantity seller of gold-nanomesh,
graphene GET, PEDOT:PSS-tattoo or cut-and-paste e-tattoo electrodes was found**; these remain
lab-protocol level [via sub-search]. Epicore Biosystems sells only B2B sweat-microfluidic patches
(no individual sales found); "Softsonics/Softionics" returned no product. Adjacent but not an
e-tattoo: Metrohm-DropSens screen-printed gold electrodes on rigid ceramic [70]. **This is why the
fallback plan in §8 is "build the proven open-source electronics and use gel/dry electrodes for
data", not "buy the tattoo".**

### 3.5 Patents worth reading before building

The Lu group's core e-tattoo patent is **US 10,492,703 B2, "Epidermal Sensor System and Process",
Nanshu Lu, S. Yang, P. Wang, UT System, granted 2019-12-03** [63] — this is the cut-and-paste
lineage. Northwestern/Rogers holds a family (US 10,969,395 B2; US 11,112,869 B2; US 11,064,946 B2;
US 2021/0145352 A1; US 2020/0315488 A1 / US 10,441,185 B2) [64][65][66][67][68], and NC State holds
US 2022/0340726 A1 on gas-permeable ultrathin stretchable epidermal devices [69]. A personal,
non-commercial R&D build is not a product, but the owner's EE should read US 10,492,703 B2 before
choosing the cut-and-paste route for anything that might later be shared or sold.

---

## 4. The interconnect problem

### 4.1 Why it is the hard part

A 1 µm tattoo and a 1 mm PCB differ in flexural rigidity by roughly five orders of magnitude. The
Taccola paper computes it explicitly for a PEDOT:PSS-on-tattoo system [5]:

| Layer | Thickness | Flexural rigidity D (N·m) |
|---|---|---|
| PEDOT:PSS electrode | 0.4–0.6 µm | 0.0223 × 10⁻⁹ |
| Tattoo substrate | 1.5 µm | 0.0236 × 10⁻⁹ |
| Printed Ag paste | 15 µm | 56.3 × 10⁻⁹ |
| Kapton connector | 25 µm | 4650 × 10⁻⁹ |

Any conductive track printed straight across that interface concentrates stress at the boundary and
cracks under bending or stretch. The published fixes are: (a) a **graded transition** through a soft
stretchable silver ink [5]; (b) a **serpentine** track geometry [1][2][5]; or (c) keeping the rigid
part **off the skin** and coupling through a reusable mechanical connector [7].

### 4.2 Method 1 — Polyimide tab into a ZIF socket (simplest, most robust)

Bareket/Inzelberg: screen-printed electrodes on tattoo film, laser-cut passivation, then "a
polyimide film with holes is glued to the array to fit into a zero insertion force (ZIF) socket"
[7]. The array is placed on skin; the connector tab sits at the edge and clips into a custom PCB.
The same group recorded facial sEMG with this stack for an hour with the head free to move, and the
amplifier was additionally held with **medical tape (3M Transpore) and a plastic hair clip** [8].

**Why it suits this build:** ZIF sockets and 13–25 µm polyimide are cheap and available; the tab is
reusable while the tattoo is disposable; and it survived the constant micromotion of cheek muscles
in 18 volunteers [8]. The trade-off is that the tab is a stiff "handle" the user can feel [4].

### 4.3 Method 2 — Silver paste + Au/PET strips + clip (no socket needed)

Lu group: cut **13 µm Au/PET strips (Rotex Tech)** as intermediate connectors, attach one end to a
tattoo terminal with **silver paste (Creative Materials 124-23)** and alligator-clip the other end
[2]. This is the least-tooling option and can be done at a kitchen table.

### 4.4 Method 3 — Screen-printed stretchable Ag + Kapton pad + magnetic snap (best long-wear)

Taccola et al. solve the mismatch explicitly for multi-day wear [5]:

- **Graded transition:** serpentine lines of stretchable Ag paste (**CI-1036**, baked 120 °C,
  10 min) are screen-printed on *both* the tattoo and a **25 µm Kapton HN** contact pad, and the
  two are joined with a drop of the same paste.
- **Magnetic docking:** four **neodymium magnets, 0.5 mm thick × 2.5 mm diameter**, glued to a
  plastic support, press the pads against magnets on the external device. The system "is able to
  sustain multiple connections/disconnections … without failure."
- **Testing:** short-term stretch to **10 %** (10/10 samples passed with no discontinuity);
  long-term cycling at **3 % strain, 18 cycles/min** for **96 h**, after which **70 % of samples**
  still worked; samples aged 6 months were "not significantly deteriorated". A vertical 4 g
  shake every hour and a 2-minute shake produced only minor perturbations, "still more than
  suitable" [5].
- The hardware, firmware and DXF files are **open source** (Zenodo DOI in [5]).

**Why it suits this build:** the jaw is a 3–10 % strain environment during speech, so the 3 %/18 cpm
result is a conservative lower bound; magnets make the connector wearable and washable. This is the
interconnect to copy for the under-chin array.

### 4.5 Method 4 — Anisotropic conductive film (ACF) bonding

ACF is the industry way to bond an FPC to a pad: an adhesive loaded with conductive particles
conducts only in z after heat + pressure. The e-tattoo literature is split on it:

- **Critical negative result:** the graphene-e-tattoo group states outright that "conventional
  electrical connections for thin-film sensors such as **soldering, anisotropic cohesive films
  (ACF), and z-axis conductive tapes are not applicable to GET**" — a sub-micron graphene film
  ruptures under the bonding force [29].
- **But stretchable ACF now exists.** Hwang et al.'s **S-ACF** (20 µm Au/Ni-coated polystyrene
  particles in SEBS-g-MA) gives a contact resistance of "**0.19 ohm per 0.25 mm²**"
  (abstract: "0.2 ohm in 0.25 mm²", SD ±0.049), ~**50 µm** connection resolution, stable to
  **ε = 80 %**, **2000** stretch/flex cycles, shear **> 19.6 N (2 kgf)**, and bonds at
  **80 °C for 10 min under 0.1 MPa** [30]. For calibration, the same paper quotes commercial
  **3M ECATT 9703 at "0.3 ohm/6 mm²"** [30].
- **Nanoscale ACF is now room-temperature and pressure-free** (wet-volatile ethanol assist): a
  ~**300 nm** AgNW-disk/SEBS film with 40 µm disks and 40 µm gaps, **> 500 %** strain, **8.6 Ω** at
  a 0.06 mm² bond, resistance change **−12 % after 1000 cycles** at 125–250 %, **1.6 ± 4.9 %**
  after 24 h artificial sweat, and WVTR **1200–1230 g m⁻² day⁻¹** (vs Tegaderm 180) [31].

**Verdict:** ACF is a viable option for **Au/PI or SEBS patches above a few micrometres**, but not
for a sub-micron graphene tattoo. For a first build, mechanical docking is less risky.

### 4.6 Method 5 — Heterogeneous serpentine ribbon + soft conductive-rubber via (best for GET-class films)

Jang et al. solved the sub-micron interconnect by never letting a rigid trace touch the tattoo
[29]:

- A **750 nm Au/PI heterogeneous serpentine ribbon (HSPR)** carries the signal from the graphene
  electrode to a **soft conductive-rubber via** (SNE-553 silicone + Ni/graphite particles, modulus
  **0.19–2.3 MPa**), which then contacts a rigid wrist/behind-ear PCB.
- The **soft rubber interlayer has vertical resistance < 50 Ω under 20 % compressive strain, stable
  over 10,000 cycles**, with resistance change ~10 Ω [29].
- The HSPR reaches **42 ± 2.6 % stretchability** at R/R₀ = 2 (catastrophic failure 51.5 %), versus
  **9.8 ± 0.3 %** for a homogeneous straight GET and **4.4 ± 1.1 %** for a heterogeneous straight
  ribbon — a **~50-fold** enhancement. FEM max strain at 20 % applied is **4.3 %** for the HSPR arm
  vs **35 %** for the straight ribbon, with only **0.7 %** at the step edge. It survived **10,000
  cycles at 0–20 % strain** with resistance slightly decreasing [29].

This is the design to copy if the owner builds the graphene route (§2.6). For the printed/cut Au
route, the same principle applies: **serpentine everything, and cross into a soft interlayer before
the rigid pad.**

### 4.7 Method 6 — Magnetic snap / pogo-pin docking (most wearable, best cycle life)

- **Magnetic snaps produced zero motion artefacts** in a direct comparison with prong and spring
  snaps under standing, walking (**50 steps/min**) and rope jumping (**~120 jumps/min**), with and
  without a **140 g** mass; magnetic snaps "withstand all conditions without any artefact being
  recorded", with clean signal > 4 s about **100 %** of the time, while prong snaps degraded to
  **85.34 ± 29.32 %** clean rate (walking + mass) and spring snaps to **40.64 ± 48.3 %** [34]. No
  DC resistance was measured in that study.
- **Magnetic connectors + Mill-Max pogo pins survived 5000 mating/unmating cycles** with "all
  resistance and impedance values … below **1.6 Ω**"; at 2 cycles/day that is **≈ 6.8 years**.
  Conductive epoxy outperformed conductive stitch, which outperformed solder. Buckle retention
  forces were **9.82 / 13.50 / 22.86 N** and snap forces **10.04 / 15.46 / 22.93 N**. Peel strength
  for the stitched interconnect was **217.06 N** (buckle) / **145.19 N** (snap), while epoxy and
  solder joints failed at **< 15 N** (the copper wire broke first) [35].
- Silver epoxy alone (SunRay S-CEP7-SF4) was the best of three interconnects in [35], with all
  values **< 1.6 Ω** after 5000 cycles; note the general warning that silver paste "becomes
  mechanically stiff once it dries", concentrating strain [via [43]].

### 4.8 Method 7 — Textile / carbon-rubber electrodes and the wired behind-ear layout

If the owner is willing to give up the "tattoo" look at the electrode, **embroidered conductive
textile** is a robust fallback: hybrid polyamide thread electrodes gave sEMG amplitude comparable
to Ag/AgCl (**28.45 dB**), SNR **23.34 dB vs Ag/AgCl 23.10 dB** at 10 mmHg contact pressure, and
impedance correlation with Ag/AgCl up to **0.993** at 25 mm inter-electrode distance; 20 mm was
chosen. Washing was stable to the **5th wash**, after which surface resistance increased
**four-fold**; sweat *improved* the signal (lower contact impedance) [36]. Kusche et al. found dry
electrodes (gold, stainless, carbon rubber, metallized textile) can be tuned "down to ranges of
hydrogel electrodes and even below" with the right contact setup, with gold-plated best [24].

The published **wired layouts** both keep the rigid connector off the face: GET palm → 750 nm
Au/PI serpentine ribbon → conductive-rubber via → rigid wrist PCB [29]; neck patch → VIA →
co-planar ACF → FPC [37]. For a jaw/chin array, the analogue is a serpentine ribbon running to a
**behind-the-ear or jaw-hinge pod**.

### 4.9 What fails, and when

- **Strain failure of the metal/interconnect, not the tattoo:** inkjet PEDOT:PSS tattoos recovered
  well to **5 % strain** and first failed "at around 8 %, probably ascribable to failure of wire
  interconnection rather than to tattoo integrity"; the electrode area itself showed no cracks or
  delamination after repeated **10 %** cycles [4].
- **Delamination/adhesive failure under sweat:** the open-mesh design in [2] was chosen specifically
  so sweat does not accumulate at the interface; a continuous film traps it. Ferrari et al. note
  that a steady liquid layer can cause redness/itchiness and damage components [3].
- **Connector peel is the user-reported weak point:** in a study where 11 people wore the tattoos,
  all "described not to perceive the electrode but had perception of the connector part (wire or
  flat connector, placed at the edge of tattoo)"; the connector is thicker/stiffer than the sensing
  part [4].
- **Sub-micron films fail fast without encapsulation:** bare GET first delaminated at **4 h 23 min**
  and first ruptured at **5 h**; with liquid bandage, cracks appeared at **96 h** [20][26].
- **Strain concentrates at rigid islands and step edges:** FEM shows **0.7 %** strain at a
  heterogeneous serpentine step edge vs **35 %** for a straight ribbon at 20 % applied strain
  [29]; a review notes curved planar wires can "undergo complete fracture from the edge after
  repeated stretching" above **10 %** tensile strain [via [40]].
- **Prong/spring snap contacts lose signal under motion** (clean-signal rate dropped to
  **85.34 ± 29.32 %** and **40.64 ± 48.3 %**), whereas magnetic snaps did not [34].

**Recommended interconnect for this build:** screen-printed or cut **serpentine** traces from the
electrode to a **13–25 µm polyimide pad**; cross into a **soft conductive-rubber interlayer** before
the pad if the electrode is a sub-micron film [29]; then either a **ZIF socket** (cheap, bench use)
[7], **silver epoxy** (best cycling of the adhesives, < 1.6 Ω after 5000 cycles [35]), or the
**magnetic dock** (4 × 0.5 mm × 2.5 mm neodymium magnets) [5][34][35]. Mechanically anchor the pad
behind the ear/jaw hinge with medical tape so jaw motion pulls the tape, not the pad [8].

---

## 5. Measured performance

### 5.1 Skin–electrode impedance vs Ag/AgCl (the central comparison)

| Electrode | Area | Frequency | Impedance | Source |
|---|---|---|---|---|
| Inkjet PEDOT:PSS tattoo (after 60 min) | 300 mm², 20 mm gap | 60 Hz | **294 ± 1 kΩ** (median ± IQR, n = 7) | [4] |
| Titanium dry | 300 mm² | 60 Hz | **94 ± 3 kΩ** | [4] |
| Ag/AgCl pregelled | 300 mm² | 60 Hz | **102 ± 2 kΩ** | [4] |
| Inkjet PEDOT:PSS tattoo, EMG band | — | 10–450 Hz | "below 300 kΩ, ~300 kΩ at 60 and 100 Hz" | [4] |
| Screen-printed carbon (pristine) | 20 mm² | 1 kHz | ~10× *larger* than gelled | [7] |
| Screen-printed carbon + ppEDOT | 20 mm² | 1 kHz | ~10× *lower* than pristine carbon | [7] |
| Ag/AgCl commercial | 300 mm² (15× area) | 1 kHz | specific impedance ≈ ppEDOT/carbon | [7] |

**The most complete same-subject comparison** is Lopes et al.'s seven-way test (one subject, five
runs over five consecutive days, no skin prep, ~2 min after placement, 11 mm gap) [6]. Fitted
interface values:

| Electrode (5 µm–500 µm class) | Rd | Cd | Total Ze |
|---|---|---|---|
| Printed Ag-In-Ga tattoo (5 µm) | **31.8 ± 1.6 kΩ** | **60.5 ± 2.3 nF** | **145.7 ± 4.5 kΩ** |
| Hydrogel–PDMS | 42.2 | 39.1 | 240.9 |
| Ag/AgCl gel | 192.1 ± 31.9 kΩ | 44.4 nF | 324.9 ± 1.4 kΩ |
| AgPDMS | 236.2 | 28.9 | 420.0 |
| Stainless steel 316 | 312.7 ± 48.6 | 24.6 | 511.7 ± 0.7 |
| Carbon-black PDMS | 363.8 | 20.9 | 610.1 |
| z-axis Ag-Ni PDMS | 348.9 | 6.0 | ~70 (EMG band only) |

SNR rank in the same study: **tattoo > hydrogel > Ag/AgCl > AgPDMS > stainless > cPDMS > zPDMS**
[6]. The tattoo's advantage is conformability (higher effective contact area → higher Cd), not
material conductivity. **The two tables above come from different labs, electrode areas and fitting
methods (Ferrari's 60 Hz modulus vs Lopes's fitted RC model); do not compare their absolute
ohms across tables — compare within a table.**

Additional same-subject impedance/SNR data points: the graphene e-tattoo paper reports ECG SNR
**15.22 dB vs 11 dB** for gel on the same subject, with motion artifact "comparable to gel" [20];
PGIN reports "3.5 times lower interfacial impedance than commercial electrode" at 10 and 100 Hz
[22]; a 2024 hydrogel e-tattoo reports "**234 % lower interface impedance at 20 Hz**" and "**up to
19 dB higher SNR**" than medical Ag/AgCl [23]. For dry metal electrodes, Kusche et al. found
Ag/AgCl gel at **~1 kΩ total** and near-constant, dry Au/stainless starting at **~2×** that,
halving within 5 min and saturating after ~15 min; smooth carbon rubber ~3×, textured ~5×, and
metallized textile **> 15 kΩ at 391 kHz**; applying **5 N** contact force plus a high frequency let
dry metal match gel [24]. That study is in the bioimpedance band, not EMG, but it shows how
sensitive dry electrodes are to pressure and hydration. Goyal et al. confirm the mechanism: dry
impedance is dominated by the **stratum corneum at 1 Hz–10 kHz** and is strongly
**hydration-dependent**, and a **9 cm²** electrode had **~2× lower impedance** than a **4 cm²**
one [25].

Two important caveats, both from the papers: Ferrari et al. used a **gentle abrasion prep on all
electrode types** and note a more aggressive abrasion might lower impedance, but gentle prep "is
more suitable for facial and sensitive skin" [7, methods note]; and the PEDOT:PSS tattoo had
**higher impedance than both gel and dry at every frequency above 10 Hz**, which the authors
attribute to PEDOT:PSS being antistatic and lowering the interface capacitance [4]. A carbon +
ppEDOT electrode is the better impedance choice for the face [7].

### 5.2 Noise and SNR on facial sEMG

Bareket et al. (dry carbon/ppEDOT, 20 mm²):

- **SNR 13 (22 dB)** after **3 hours** on the hand, stable recordings [7].
- Noise RMS (single-ended): **83 ± 20 µV** carbon, **66 ± 6 µV** ppEDOT/carbon, **74 ± 15 µV**
  commercial pregelled (300 mm²).
- Noise RMS (differential): **26 ± 11**, **25 ± 9**, **22 ± 9 µV** respectively.
- Facial sEMG: recordings over the **zygomaticus major** on **3 individuals** distinguished neutral,
  smile, sad and angry expressions; a big smile vs laughing was separable [7].
- No skin irritation was observed **for five individuals for up to ten hours** [7].

Inzelberg et al. (8 screen-printed carbon electrodes, 5 mm diameter, on the cheek, 18 volunteers):

- SNR, nose wrinkle **1.57 ± 0.43** single-ended / **4.66 ± 2.18** differential; eye close
  **1.97 ± 0.65** / **10.86 ± 7.44**; voluntary smile **4.06 ± 2.59** / **7.73 ± 4.64** [8].
- Baseline noise RMS **39.82 ± 6.58 µV** single-ended, **13.78 ± 4.90 µV** differential [8].
- Sampling **3000 Hz** wired / **410 Hz** wireless; band-pass **5–500 Hz** / **5–204 Hz**; 50 Hz
  notch. The wireless amplifier weighed **7.95 g** at **3.5 × 1.8 × 0.9 cm** [8].
- Electrode placement took **about a minute**; recording ran for an hour with free head movement;
  the amplifier was secured with medical tape and a hair clip [8].

The takeaway: **a dry tattoo electrode on the face gives usable but not gel-grade SNR**, and the
smile/zygomatic channel is the strongest of the measured facial tasks. The under-chin muscles the
owner needs (anterior belly of digastric, buccinator) are smaller and deeper than zygomaticus, so
expect the lower end of this range.

### 5.3 Silent-speech validation with epidermal electrodes

The earliest silent-speech validation on an epidermal patch is **Liu et al. 2020**, an epidermal
Cu/PI "tattoo-like" patch attached to the lower jaw and both sides of the face [1]. Demonstrated
results:

- **Three channels** over **anterior belly of digastric (ABD), buccinator (BUC), zygomaticus (ZYG)**.
- **Closed vocabulary:** 5 action words (Front, Back, Left, Right, Stop) and 6 emotion words
  (Happy, Sad, Hello, Goodbye, Hug, Love), **30 trials each**, tester **spoke silently**.
- Classifier: **linear discriminant analysis** on wavelet-denoised features.
- **Average action-instruction accuracy up to 89.04 %; emotion-instruction accuracy 92.33 %**.
- Patch: **Cu electrodes, 400 nm thick, 9 mm diameter**, filamentary-serpentine mesh **0.1 mm
  wide, 0.2 mm radius of curvature**; **double-wave** interconnects encapsulated in **polyimide**;
  **total thickness < 10 µm**; **peel strength > 1 N cm⁻¹**.
- Stretch: **> 20 %** with no cracks; max principal elastic strain in the metal **11.24 %** vs Cu
  fracture strain **33.3 %**.
- Signal chain: **2000 Hz, 16-bit**, **NI USB-6003**, band-pass **10–1000 Hz**, ZTEMG-1300
  conditioning circuit.
- Fabricated **on a silicon wafer** and transferred to a **sterile polyurethane wound dressing**
  using **3M water-soluble tape** — i.e. **not** a hobbyist process [1].

**Interpretation.** This is the key existence proof for the owner's plan: a dry, gel-free,
few-micrometre electrode array on the jaw/face can drive silent-speech decoding at ~90 % over two
small closed vocabularies. It is **closed-vocabulary, 3-channel, 1-tester** and the fabrication
needs a cleanroom; it does not establish open-vocabulary decoding or long wear. The same group's
results section reports **89.6 ± 0.6 %** (action) and **92.7 ± 0.5 %** (emotion) under 10-fold CV,
best single-class values **80.9 ± 0.9 %** and **81.9 ± 0.6 %**, and **real-time HMI 77.6 % (5 class)
/ 83.6 % (6 class)**; wavelet soft-threshold denoising gave **SNR 20.87 ± 1.47 dB**, RMSE
**16.82 ± 2.1 µV** [1].

**The strongest result is Wang et al. 2021 — and it uses the DIY-cuttable electrode.** This is the
same cut-and-paste Au tattoo introduced in §2.1, worn on LAO/DAO/BUC/ABD [21]:

- **4 channels**, one working + one reference per channel; **110 daily words in 13 categories**;
  **closed vocabulary**; **silent** speech.
- Classifier: **LDA**, deployed on a cloud server; **recognition rate 92.64 %** over the 110 words.
- Signal chain: **gain 1000**, **10–500 Hz** band-pass, **10-bit ADC at 500 Hz**, Bluetooth 5 at up
  to **256 kb/s**, ear-mounted wireless DAQ module [21].
- The paper reports the system holding **≥ 96 %** in rest/walk/jog and **86 %** while running,
  **98 %** across repeated trials with large mouth deformation, and graceful channel loss (3
  channels > 85 %, 2 channels > 70 %, 1 channel 42.27 % vs 0.91 % chance) [21] (numbers read from
  the results/figures by the search pass; the headline 92.64 % is quoted in the abstract/intro).

**Ultrathin printed array (PGIN) — a second silent-speech demonstration.** Du et al. 2024 built a
**~115 nm** PEDOT:PSS/graphene-oxide photopatterned array (PGIN): **2060 S cm⁻¹ at 88 %
transparency**, **110 % strain**, **24.5 mC cm⁻²** charge storage, and an interfacial impedance
"**3.5 times lower than commercial electrode**" [22]. It is fabricated on **The Magic Touch tattoo
paper** by spin-coating, UV crosslinking through a photomask, and a 10 s sulfuric-acid dip [22].
For silent speech: **6 channels on the right side of the face**, ground on the **left mastoid**,
**8 volunteers** silently reading digits **0–9**, ten sets of ten, SVM and CNN classifiers, **up to
92 % accuracy**; digits zero/one/two were the worst classes [22]. Under motion, the paper reports
every PGIN channel stayed **> 20 dB SNR** while Ag/AgCl "showed a severe signal distortion" [22].

**Cross-track caution:** all three silent-speech results are **closed-vocabulary, isolated-word
classification**; no open-vocabulary continuous decoding or WER for an epidermal array was found.
Subject counts are 1–8. Cross-talk between facial channels is not quantified against gel anywhere
in this set (**gap/unverified**).

### 5.4 Wear duration, sweat, hair, removal, skin reactions

- **48 h** of continuous wear with usable impedance, and recordings were possible at both 24 h and
  48 h; impedance was "relatively constant" at 1 kHz throughout [4].
- **Graphene e-tattoo durability, from the paper's own Supporting Information [20][26]:** a bare
  GET had **first delamination at 4 h 23 min** and **first rupture at 5 h**; with a **< 1 µm
  liquid-bandage encapsulation**, cracks appeared at **96 h** and impedance escalated. Three
  sensors on chest/forearm/bicep were "not affected by" a **25-minute run at 6.5 mph**. A "no
  crack to 52 h" figure appears in some notes but was **not found in the SI** — treat 52 h as
  **unverified**. A review states liquid bandage gives "up to three days without any
  delamination" [via [29]].
- **One-week, 20-subject patch test with no inflammation** is claimed for the gold nanomesh, along
  with **> 10,000 bend/stretch cycles** and water-vapour transmission "superior to plastic foil
  and rubber sheet"; the dermatological severity scores themselves are paywalled, so those are
  **secondary/unverified** [9][17][27].
- **A 10-hour wear comparison** with the cut-and-paste Au tattoo found gel noise/impedance stable
  while the tattoo gradually degraded — but after 30 min of running at hour 8, sweat made the
  tattoo's noise lower than gel's [21]. Authors cleaned skin with water only [21].
- **Hair growing through the tattoo over 24 h** with "no visible effect on the quality of the
  recording" — the tattoo was perforated so hair could pass through; the authors propose this for
  long-term scalp EEG [4].
- **Sweat:** open-mesh designs minimise sweat accumulation [2]; a continuous film traps a liquid
  layer, which can cause redness/itchiness and damage the device [3].
- **Removal:** wash with soap and water and rub gently, like a child's temporary tattoo [4].
- **Skin reactions:** 11 wearers, "no skin irritation … even … for long-term recordings (2 days)";
  **one** subject showed moderate irritation to the ethylcellulose layer, judged a subjective
  uncommon sensitivity [4]. In [7], no irritation for 5 people up to 10 h.
- **Shaving/prep:** Ferrari et al. used a gentle abrasion on all sites; Bareket et al. state the
  gentle prep is what makes the face/sensitive-skin use case valid [4][7]. The owner should shave
  the jaw/chin, wipe with alcohol, and **not** aggressively abrade before a session.
- **Water vapour:** the ethylcellulose tattoo film's breathability is what makes multi-day wear
  tolerable; the review gives the relevant comparison (a film is a barrier when its water-vapour
  transmission rate drops below the ~5 g m⁻² h⁻¹ transepidermal water loss) and shows temporary
  tattoo and medical-grade polyurethane pass while silicones, PEN and parylene do not [3].

### 5.5 What is not demonstrated

- **No published open-vocabulary silent-speech decoder driven by an e-tattoo electrode array** was
  found; [1] is closed-vocabulary and the best available.
- **No published e-tattoo array on the hyoid / laryngeal neck sites.** The published arrays do
  include the **anterior belly of digastric** [1][21], but the laryngeal/hyoid channels that
  AlterEgo used are not covered by any epidermal array in this set.
- **No multi-day (≥ 4 days) e-tattoo sEMG dataset**; the longest quantified wear here is 48 h [4].
- **Skin-tone-stratified electrode performance** is not addressed by any paper fetched here
  (see §6).

---

## 6. Visibility and skin tone

### 6.1 How visible is each option in practice

- **Sub-micrometre transparent films are effectively invisible; the connector is not.** In the
  Ferrari et al. study, 11 wearers "did not perceive the electrode but had perception of the
  connector part (wire or flat connector, placed at the edge of tattoo)", and the authors state the
  connector is thicker/stiffer than the sensing part [4]. This is the single most useful
  visibility fact in the file: **the tattoo disappears, the tab does not.**
- **PEDOT:PSS tattoo:** overall thickness **600–1200 nm** on a **~450 nm** ethylcellulose carrier
  [4]; it looks like a faint clear film and is removed with soap and water [4].
- **Graphene e-tattoo:** **463 ± 30 nm** and **~85 % optically transparent** [20]. Graphene is a
  weak broadband absorber, so a few-layer film reads as a very faint grey; the **gold or copper
  traces and the contact pads are the visible elements**.
- **Gold nanomesh:** breathable, featherweight and the most comfortable in the wear studies, but
  gold reads as a **faint metallic sheen**, not invisible. The 2017 paper reports 20 subjects, one
  week, no inflammation, and EMG "comparable to gel"; some users "forgetting the sensors were
  attached" [9][17][27].
- **Transparent metal alternatives:** a silver-nanowire/PEDOT:PSS stretchable transparent electrode
  reports **~25 Ω/sq**, **~85 % transmittance at 550 nm**, stable to **50 % strain** and **500
  cycles**, sensing from **< 1 cm²** [28]. Metal meshes and nanowires can look **glossy** even when
  nominally transparent.
- **PGIN** is **88 % transparent** at 2060 S/cm, so a patterned array on the face is largely hidden
  except for its contacts [22].
- **The only "undetectable by sight and touch" claim** is a 2026 *Science Advances* paper: a
  **~200 nm** elastic film with transparent conductive nanowires, with reflections/gloss suppressed,
  recording EOG, facial EMG and EEG. The paper is paywalled here and the transmittance value is
  **unverified**; treat as a promising press-release-level result, not a benchmark [41].
- **Practical visibility verdict for the owner:** use a transparent/near-transparent electrode
  (GET via §2.6 if willing to do the wet transfer, otherwise printed PEDOT:PSS), route all traces
  to a **single tab behind the ear or at the jaw hinge**, and keep the tab small; the tab is what
  other people will see.

### 6.2 Skin tone, hydration, hair

- **No controlled study was found that stratifies biopotential electrode impedance or SNR by
  Fitzpatrick skin type / melanin.** The strongest statement located is a press release for the
  2026 film claiming operation "across a wide range of skin tones and features" — **unverified**
  [41] — and a 2024 paper on **eumelanin (black) conductive tattoo inks** intended to lower skin
  impedance, whose numbers are **unverified** [44]. Any claim that a given electrode is
  skin-tone-neutral for this build should be treated as an open experiment, not a fact.
- **Hydration dominates dry-electrode impedance.** Dry impedance is governed by the stratum
  corneum over **1 Hz–10 kHz** and is strongly hydration-dependent; a **9 cm²** electrode had **~2×
  lower impedance** than a **4 cm²** electrode, and **titanium gave better signal quality than
  stainless steel** (Ti 2.17 × 10⁶ S/m, SS 1.30 × 10⁶ S/m) [25]. For a chin/jaw array this means:
  dry, cold skin raises impedance, and a little moisture (water before application, or natural
  sweat) lowers it.
- **Hair is not a blocker for the tattoo, because it can grow through it.** Ferrari et al.
  demonstrated hair growing through the tattoo over **24 h** with no effect on the recording, and
  calculated the surface occupied by hair at **~0.5 % per cm²** (density **160 hairs/cm²**,
  diameter **60 µm**) [4]. This is a real advantage of the perforated tattoo over a continuous
  film or a rigid electrode on the jaw/chin.
- **Skin reactions:** the only quantified e-tattoo reaction rate in this set is **1 of 11**
  subjects showing moderate irritation to the ethylcellulose carrier [4]; no irritation was seen in
  5 people over 10 h in [7]. The gold-nanomesh one-week test claims zero inflammation but the
  severity tables are paywalled [9][17][27].

---

## 7. Concrete DIY recipe for a first under-chin + jawline tattoo array

**Goal:** 4 bipolar channels (4 working + 4 reference electrodes) on **LAO, DAO, BUC and the
anterior belly of digastric (under-chin)** — exactly the montage that already achieved **92.64 % on
110 silent words** with a cut-and-paste Au tattoo [21] — transferable with water, connected to an
OpenBCI/MyoWare-class amplifier through a reusable tab, for a few hundred US$ of consumables (see
the price caveat below). Add channels later if the 4-channel map underfits.

**Design rules from the data:** electrode **Au on 1.4 µm PET** (or printed PEDOT:PSS/carbon), keep
total thickness **≤ 5 µm**, use **filamentary serpentine traces 500 µm wide, ribbon-width-to-arc-
radius ratio 0.32, arc angle 20°** [21], put the stiff connector **at the jaw hinge / behind the
ear**, and reinforce the electrode–wire joint with a conductive adhesive or low-temperature alloy
[5][21].

### 7.1 Bill of materials (three variants)

**Variant 1 — fastest, no cleanroom (recommended first): screen-printed carbon + PEDOT on tattoo paper**

- Commercial temporary tattoo paper, printable (Silhouette / The Magic Touch class) [2][3][5][7].
- Conductive carbon ink (screen-printable) — the ink class used in [7].
- PEDOT:PSS inkjet/dispersion (e.g. Clevios P Jet 700 class) + optional 10 % vol glycerol [5];
  or a commercial PEDOT:PSS screen ink.
- Double-sided adhesive film (for the laser-cut passivation layer) [7].
- 13–25 µm polyimide (Kapton) sheet for the connector tab [4][5].
- Stretchable silver conductor paste for the serpentine traces (CI-1036 class) [5], or Au/PET
  strips + silver paste as the simpler Lu method [2].
- ZIF socket (FPC connector) + a small custom PCB, or a magnetic connector (4 × 0.5 mm × 2.5 mm
  neodymium magnets) [5][7].
- Optional: 3M Nexcare liquid bandage spray for the ~1 µm encapsulation [2].
- CO₂ or fiber laser for cutting the passivation/tab (VLS3.50 class used in [4][5]);
  or a Silhouette Cameo cutter for the Au/PET route [2].

**Variant 2 — lower impedance, and the one with a silent-speech precedent: cut-and-paste Au/Cr/PET**

- Silhouette tattoo paper; **1.4 µm PET** (PolyK class); **Cr and Au** targets; thermal evaporator.
- Silhouette Cameo (or any programmable cutter): sharpness 5, rate 2, thickness 1 [2].
- 13 µm Au/PET strips + silver paste for the connector [2].
- **This is the variant to build.** It is the electrode worn in the 110-word, 92.64 % silent-speech
  study, at **1.2 µm** with a **47 µm Tegaderm** carrier and the LAO/DAO/BUC/ABD montage [21].

**Variant 3 — printed PEDOT:PSS/GO photopatterned (PGIN), if a UV mask aligner is available**

- The PGIN recipe is fully published: **Clevios PH1000** + **GO** (7 wt % optimum) + **PEGDMA**
  (1.4:1 vs PEDOT) + **Irgacure 2959** (5 wt % vs PEGDMA) + **Capstone FS-30** (1 wt % vs PH1000);
  spin-coat **1000 rpm, 100 s**, dry at room temperature, UV crosslink **25 mW cm⁻² for 2 min**
  through a photomask, rinse, then dip in **concentrated sulfuric acid for 10 s** [22]. This is the
  highest-performance printed route (115 nm, 88 % transparent, 110 % strain) but the acid step and
  UV aligner are the price of admission [22].

### 7.2 Fabrication steps (Variant 1)

1. **Draw the array** in CAD: 12 electrodes, ~5 mm diameter, 20 mm spacing along muscle fibres for
   the differential pairs [1][4]; serpentine traces from each electrode to a single edge tab.
2. **Laser-cut a screen stencil** from acrylic/PET for the electrode pattern.
3. **Screen-print carbon ink** onto the tattoo paper through the stencil; dry per the ink datasheet.
4. **Over-coat with PEDOT:PSS** (or plasma-polymerise EDOT if a plasma etcher is available) to
   lower impedance [5][7].
5. **Screen-print the serpentine silver traces** on the same sheet, from each electrode to the tab
   region; bake at **120 °C for 10 min** [5].
6. **Laser-cut the double-sided adhesive passivation** with holes over the 12 electrodes; laminate
   it to the printed sheet [7].
7. **Laser-cut the Kapton tab** and bond it to the trace ends with a drop of silver paste; bake
   **120 °C for 10 min** [5].
8. **Prepare skin:** shave the jaw/chin; wipe with alcohol; gently exfoliate (no aggressive
   abrasion) [4][7].
9. **Transfer:** wet the backing paper, press the tattoo to skin, and slide the paper off (sliding
   beats peeling) [2]; hold for a few seconds.
10. **Optional encapsulation:** five light sprays of liquid bandage over the array, stencil-masking
    the electrode windows if a hydration sensor is ever added [2].
11. **Connect:** insert the Kapton tab into the ZIF socket, or snap the magnetic dock [5][7]; tape
    the tab at the jaw hinge with medical tape so jaw motion pulls the tape, not the pad [8].
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
