rkrafted/silent-speech/research/10-fasttrack-data.md

# Track 10 — Fast-track data: buying used acquisition hardware now + synthetic/transferable EMG data

*Research report for the silent-speech wearable project (personal R&D). Part A: where to buy
used/refurbished biopotential acquisition hardware in the EU today, at what price, and which unit
fits 8–16 ch sEMG at ≥1 kHz with low latency. Part B: what is published on synthetic and
transferable data for silent-speech EMG — augmentation, generative EMG from audio/text, audio/TTS
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
