rkrafted/silent-speech/hw/pod/bom.csv

Reference | Qty | Value | Footprint | MPN | LCSC
C1,C2,C3,C4,C5,C6,C7,C8,C9,C10,C33 | 11 | 1nF | Capacitor_SMD:C_0402_1005Metric | 0402B102K500NT | C1523
C11 | 1 | 10nF | Capacitor_SMD:C_0402_1005Metric | CL05B103KB5NNNC | C15195
C13,C29 | 2 | 10uF | Capacitor_SMD:C_0805_2012Metric | CL21A106KAYNNNE | C15850
C14 | 1 | 22uF 6.3V polymer Ta | Capacitor_Tantalum_SMD:CP_EIA-1608-10_AVX-L | T58MM226M6R3C0300 | C215879
C18,C20,C12,C32,C22,C35,C30,C34 | 8 | 100nF | Capacitor_SMD:C_0402_1005Metric | CL05B104KO5NNNC | C1525
C19,C21,C15,C16,C17,C23,C24,C26,C25,C27 | 10 | 1uF | Capacitor_SMD:C_0402_1005Metric | CL05A105KA5NQNC | C52923
D2,D3,D4 | 3 | TPD4E1B06DCKR | Package_TO_SOT_SMD:SOT-363_SC-70-6 | TPD4E1B06DCKR | C840093
FB1,FB2,FB3,FB4,FB5,FB6,FB7,FB8,FB9,FB10 | 10 | BLM15HD182SN1D | Inductor_SMD:L_0402_1005Metric | BLM15HD182SN1D | C76888
J2 | 1 | LiPo 1S protected | Connector_JST:JST_SH_SM02B-SRSS-TB_1x02-1MP_P1.00mm_Horizontal | SM02B-SRSS-TB(LF)(SN) | C160402
P1,P2,P3,P4,P5,P6,P7,P8,P9,P10,P11,P12 | 12 | pogo pin | pod:Harwin_P70-1000045R_pad2.2 | P70-1000045R | C17702549
Q2 | 1 | AO3401A | Package_TO_SOT_SMD:SOT-23 | AO3401A | C15127
R1,R2,R3,R4,R5,R6,R7,R8,R9 | 9 | 2.2k | Resistor_SMD:R_0402_1005Metric | 0402WGF2201TCE | C25879
R10 | 1 | 392k | Resistor_SMD:R_0402_1005Metric | 0402WGF3923TCE | C27007
R20,R21,R22,R23,R33,R13,R24 | 7 | 100k | Resistor_SMD:R_0402_1005Metric | 0402WGF1003TCE | C25741
R25 | 1 | 10k | Resistor_SMD:R_0402_1005Metric | 0402WGF1002TCE | C25744
R31 | 1 | 100R | Resistor_SMD:R_0402_1005Metric | 0402WGF1000TCE | C25076
R32,R14,R15 | 3 | 1M | Resistor_SMD:R_0402_1005Metric | 0402WGF1004TCE | C26083
R34 | 1 | 0R | Resistor_SMD:R_0402_1005Metric | 0402WGF0000TCE | C17168
R35,R36 | 2 | 4.7k | Resistor_SMD:R_0402_1005Metric | 0402WGF4701TCE | C25900
U1 | 1 | ADS1298IPAG | Package_QFP:TQFP-64_10x10mm_P0.5mm | ADS1298IPAG | GLOBAL
U2 | 1 | NINA-B306-00B | pod:u-blox_NINA-B306 | NINA-B306-00B | C6127317
U3,U4 | 2 | TPS7A2033PDBVR | Package_TO_SOT_SMD:SOT-23-5 | TPS7A2033PDBVR | C2862740
U6 | 1 | W25Q128JVPIQ | Package_SON:WSON-8-1EP_6x5mm_P1.27mm_EP3.4x4.3mm | W25Q128JVPIQ | C190862
U7 | 1 | MAX17048G+T10 | Package_DFN_QFN:TDFN-8-1EP_2x2mm_P0.5mm_EP0.8x1.2mm | MAX17048G+T10 | C2682616
