rkrafted/silent-speech/hw/fab/cartridge/cartridge_bom.csv

Comment | Designator | Footprint | LCSC Part #
JST SH 2-pin horizontal socket SM02B-SRSS-TB | J1 | JST_SH_SM02B-SRSS-TB_1x02-1MP_P1.00mm_Horizontal | C160402
SMD pogo pin Harwin P70-1100045R (6.3 free / 5.0 working, 0.4 um Au) | P1,P2 | Pogo_SMD_tall_pad2.0 | C20826701
