rkrafted/silent-speech/hw/fab/dock/dock_bom.csv

Comment | Designator | Footprint | LCSC Part #
USB-C receptacle HRO TYPE-C-31-M-12 | J1 | USB_C_Receptacle_HRO_TYPE-C-31-M-12 | C165948
5.1k 0402 | R1,R2 | R_0402_1005Metric | C25905
10uF 25V 0805 CL21A106KAYNNNE | C1,C2 | C_0805_2012Metric | C15850
SMAJ5.0A TVS (MDD) | D1 | D_SMA | C113952
MCP73831T-2ACI/OT charger 4.20 V | U1 | SOT-23-5 | C424093
15k 0402 (R_PROG, 67 mA) | R3 | R_0402_1005Metric
1k 0402 (LED, optional) | R4 | R_0402_1005Metric
LED red 0603 (charging, optional) | D2 | LED_0603_1608Metric
