rkrafted/silent-speech/hw/fab/tab_electrode/tab_electrode_bom.csv

Comment | Designator | Footprint | LCSC Part #
2x5 2.54mm SMD vertical pin header hanxia HX PZ2.54-2x5P TP | J1 | PinHeader_2x05_P2.54mm_Vertical_SMD | C32713285
1x2 2.54mm SMD vertical pin header (two-pod link) hanxia HX PZ2.54-1x2P TP-YQ | J2 | PinHeader_1x02_P2.54mm_Vertical_SMD_Pin1Left | C41417359
