rkrafted/silent-speech/hw/revisions/2026-10-16-01f62380/fab/tab_electrode/tab_electrode_bom.csv

Comment | Designator | Footprint | LCSC Part #
1x10 2.54mm right-angle pin header | J1 | PinHeader_1x10_P2.54mm_Horizontal
