rkrafted/silent-speech/hw/revisions/2026-10-16-676691bc/fab/tab_electrode/tab_electrode_bom.csv

Comment | Designator | Footprint | LCSC Part #
2x5 2.54mm SMD vertical pin header | J1 | PinHeader_2x05_P2.54mm_Vertical_SMD
