rkrafted/silent-speech/research/jaw/forum-selection.tsv

rank | id | score | title | url
1 | 2869 | 293.5 | ThinkPulse active electrodes, Q&A | https://openbci.com/forum/index.php?p=/discussion/2869/thinkpulse-active-electrodes-q-a
2 | 138 | 250.5 | Buying Dry / Active Electrodes | https://openbci.com/forum/index.php?p=/discussion/138/buying-dry-active-electrodes
3 | 3594 | 235.8 | Very strong noise in the Delta waves range | https://openbci.com/forum/index.php?p=/discussion/3594/very-strong-noise-in-the-delta-waves-range
4 | 4131 | 218.5 | Using cEEGrid for trigeminal / jaw reflex electrophysiology | https://openbci.com/forum/index.php
5 | 2648 | 211.2 | noise in signal from my DIY ADS1299 board (not Cyton) | https://openbci.com/forum/index.php
6 | 712 | 210.8 | Prospects for higher sample rates? | https://openbci.com/forum/index.php?p=/discussion/712/prospects-for-higher-sample-rates
7 | 1651 | 207.5 | MyoWare and EMG, need to adjust SRB, Bias? | https://openbci.com/forum/index.php?p=/discussion/1651/myoware-and-emg-need-to-adjust-srb-bias
8 | 3502 | 205.0 | Cyton + Wifi, Packet Loss / Noise Issues | https://openbci.com/forum/index.php?p=/discussion/3502/cyton-wifi-packet-loss-noise-issues
9 | 141 | 204.0 | Teensy based ADS1298 EMG acquisition board | https://openbci.com/forum/index.php?p=/discussion/141/teensy-based-ads1298-emg-acquisition-board
10 | 2517 | 203.5 | Expected Impedance range with Ultracortex + Cyton [resolved] | https://openbci.com/forum/index.php
11 | 1663 | 202.8 | Greentek Gelfree-S EEG Cap | https://openbci.com/forum/index.php?p=/discussion/1663/greentek-gelfree-s-eeg-cap
12 | 2460 | 201.0 | Artifact pattern on WiFi Shield + Cyton [resolved] | https://openbci.com/forum/index.php
13 | 2763 | 201.0 | Cyton impedance check, freeze issues | https://openbci.com/forum/index.php?p=/discussion/2763/cyton-impedance-check-freeze-issues
14 | 3019 | 198.0 | Detection of alpha or eye movement with ADS1299EEGFE-PDK | https://openbci.com/forum/index.php
15 | 1527 | 197.2 | pulse sensor with Cyton + Daisy | https://openbci.com/forum/index.php?p=/discussion/1527/pulse-sensor-with-cyton-daisy
16 | 1642 | 196.5 | cannot get 500 or 1000 hz sample rate from Wifi Shield (or SD card) | https://openbci.com/forum/index.php
17 | 156 | 191.5 | GSR & OpenBCI | https://openbci.com/forum/index.php?p=/discussion/156/gsr-openbci
18 | 2828 | 190.8 | ADS1299 interface with Arduino UNO | https://openbci.com/forum/index.php?p=/discussion/2828/ads1299-interface-with-arduino-uno
19 | 1290 | 189.0 | Newbie question - OpenBCI for surface EMG / EEG of cranial nerves? | https://openbci.com/forum/index.php
20 | 2687 | 186.0 | EEG Cap Kit noise issue / EEG+EMG+EOG / AGND [resolved] | https://openbci.com/forum/index.php
21 | 2339 | 184.8 | Electrode Cap vs. Ultracortex | https://openbci.com/forum/index.php?p=/discussion/2339/electrode-cap-vs-ultracortex
22 | 79 | 183.2 | EOG sensors & software | https://openbci.com/forum/index.php?p=/discussion/79/eog-sensors-software
23 | 2226 | 183.0 | Using the ganglion board to read EMG detecting subvocalizations for biofeedback to train suppression | https://openbci.com/forum/index.php
24 | 2401 | 183.0 | Subvocalization Pins/Settings | https://openbci.com/forum/index.php?p=/discussion/2401/subvocalization-pins-settings
25 | 2714 | 181.5 | Questions regarding serial stream format & others | https://openbci.com/forum/index.php
26 | 159 | 180.5 | SSVEP or patterns evoking EEG response | https://openbci.com/forum/index.php?p=/discussion/159/ssvep-or-patterns-evoking-eeg-response
27 | 1753 | 179.2 | Anti Aliasing Filters for EMG application | https://openbci.com/forum/index.php?p=/discussion/1753/anti-aliasing-filters-for-emg-application
28 | 136 | 179.0 | 50hz power filter rather than 60hz power filter | https://openbci.com/forum/index.php
29 | 2729 | 179.0 | sudden drop in all channels while recording with Cyton daisy | https://openbci.com/forum/index.php
30 | 2827 | 178.8 | why is Cyton + Shield sample rate, limited to 1000HZ ? | https://openbci.com/forum/index.php
31 | 2162 | 178.5 | Understanding the Bias pin with Myoware + ECG | https://openbci.com/forum/index.php?p=/discussion/2162/understanding-the-bias-pin-with-myoware-ecg
32 | 4125 | 177.0 | DIY EEG Headset: Does my ADS1299-based architecture make sense? | https://openbci.com/forum/index.php
33 | 2297 | 175.0 | could you give me some feedback on a `neuro-feedback with music` demo? | https://openbci.com/forum/index.php
34 | 2546 | 174.5 | Cyton + Ultracortex RAILED Issue | https://openbci.com/forum/index.php?p=/discussion/2546/cyton-ultracortex-railed-issue
35 | 3678 | 174.5 | problems with Ganglion/Cyton 'clone' boards | https://openbci.com/forum/index.php?p=/discussion/3678/problems-with-ganglion-cyton-clone-boards
36 | 1857 | 173.8 | which GUI to use with OpenBCI 8bit clone? | https://openbci.com/forum/index.php?p=/discussion/1857/which-gui-to-use-with-openbci-8bit-clone
37 | 303 | 171.2 | Active Electrode Circuit Design | https://openbci.com/forum/index.php?p=/discussion/303/active-electrode-circuit-design
38 | 4086 | 171.2 | Thinkpulse: signal quality, default settings & impedance ? | https://openbci.com/forum/index.php
39 | 1195 | 171.0 | Averaged or single reference electrode? | https://openbci.com/forum/index.php?p=/discussion/1195/averaged-or-single-reference-electrode
40 | 2998 | 171.0 | types of EEG / ECG electrodes | https://openbci.com/forum/index.php?p=/discussion/2998/types-of-eeg-ecg-electrodes
41 | 2070 | 169.8 | noise at 20hz - unreliable signal ? [resolved] | https://openbci.com/forum/index.php?p=/discussion/2070/noise-at-20hz-unreliable-signal-resolved
42 | 3924 | 167.8 | Noise introduced into EEG readings when others walk around the patient | https://openbci.com/forum/index.php
43 | 2335 | 166.5 | Noise in unused channels [resolved] | https://openbci.com/forum/index.php?p=/discussion/2335/noise-in-unused-channels-resolved
44 | 3766 | 166.5 | 1 Hz periodic noise peaks from Ganglion board [Mac with native bluetooth] | https://openbci.com/forum/index.php
45 | 102 | 166.0 | Electrode compatibility, amplification and filtering | https://openbci.com/forum/index.php
46 | 1505 | 164.0 | Help with 50 Hz noise bursts | https://openbci.com/forum/index.php?p=/discussion/1505/help-with-50-hz-noise-bursts
47 | 2847 | 163.2 | Cyton Daisy setup for EOG ? [resolved] | https://openbci.com/forum/index.php?p=/discussion/2847/cyton-daisy-setup-for-eog-resolved
48 | 1166 | 162.5 | Why we need reference electrodes in bi-polar configuration | https://openbci.com/forum/index.php
49 | 1557 | 162.0 | add a new bandpass filter on GUI to receive 1-100 hz EEG? | https://openbci.com/forum/index.php
50 | 3074 | 161.8 | use EEG electrode cap for sleep study ? [resolved] | https://openbci.com/forum/index.php
51 | 1532 | 160.5 | Required sampling rate for EMG | https://openbci.com/forum/index.php?p=/discussion/1532/required-sampling-rate-for-emg
52 | 1773 | 159.8 | programming Cyton without RFduino dongle? / our completed SSVEP demo | https://openbci.com/forum/index.php
53 | 4153 | 159.8 | Open-source PRAYCG pipeline: OpenBCI/LSL media protocol, timing QC, and exploratory EEG/autonomic | https://openbci.com/forum/index.php
54 | 4063 | 159.5 | Real-time speech recognition ? | https://openbci.com/forum/index.php?p=/discussion/4063/real-time-speech-recognition
55 | 3645 | 159.0 | General Questions regarding Gel free cap and Cyton Daisy | https://openbci.com/forum/index.php
56 | 4135 | 157.5 | Periodic noise during use of the Ganglion Board | https://openbci.com/forum/index.php
57 | 2983 | 156.8 | Using the Ultracortex Mark IV with a Brainmaster Discovery 24 amp | https://openbci.com/forum/index.php
58 | 3138 | 155.8 | additional channels, higher sampling rates | https://openbci.com/forum/index.php?p=/discussion/3138/additional-channels-higher-sampling-rates
59 | 3803 | 155.5 | Getting railed - using both snap and golden electrodes with Cyton | https://openbci.com/forum/index.php
60 | 3057 | 154.5 | high impedance with cup electrodes? poor SSVEP results. [resolved] | https://openbci.com/forum/index.php
61 | 3569 | 154.2 | DIY headband, all channels railed, known good electrodes | https://openbci.com/forum/index.php
62 | 2293 | 153.5 | Cyton Impedance commands not working through Wifi shield API [resolved] | https://openbci.com/forum/index.php
63 | 2647 | 151.5 | innovative PTSD neurofeedback (Tomas Ros PhD): alpha inhibit / desynchronization protocol | https://openbci.com/forum/index.php
64 | 686 | 151.0 | not detecting any actual EEG signals ... ?? | https://openbci.com/forum/index.php?p=/discussion/686/not-detecting-any-actual-eeg-signals
65 | 3572 | 151.0 | Setup for data acquisition during instrumental performance | https://openbci.com/forum/index.php
66 | 545 | 150.2 | dry vs wet electrodes, quantitative noise & signal quality comparisons | https://openbci.com/forum/index.php
67 | 3430 | 150.2 | Ultracortex + Thinkpulse, LSL, and EEGlab / import and noise issues | https://openbci.com/forum/index.php
68 | 2363 | 149.8 | Pulse Noise when sending to MAX | https://openbci.com/forum/index.php?p=/discussion/2363/pulse-noise-when-sending-to-max
69 | 932 | 149.0 | EOG cross talk on openBCI channels | https://openbci.com/forum/index.php?p=/discussion/932/eog-cross-talk-on-openbci-channels
70 | 3726 | 149.0 | electrode impedance test using the GUI widget | https://openbci.com/forum/index.php?p=/discussion/3726/electrode-impedance-test-using-the-gui-widget
71 | 1494 | 148.8 | Sample rate of 1kHz for EMG cursor control, How? | https://openbci.com/forum/index.php
72 | 2114 | 148.5 | Noise when electrodes are not attached. | https://openbci.com/forum/index.php?p=/discussion/2114/noise-when-electrodes-are-not-attached
73 | 4158 | 148.5 | Leakage-controlled baselines on 3 public imagined/silent speech datasets before building a 16-ch rig | https://openbci.com/forum/index.php
74 | 2908 | 147.5 | Streaming through GUI 4.2 LSL with timestamp problem | https://openbci.com/forum/index.php
75 | 2849 | 147.0 | How are EMG channels calculated? | https://openbci.com/forum/index.php?p=/discussion/2849/how-are-emg-channels-calculated
76 | 3082 | 146.0 | abnormal Ganglion 1 Hz ramp ? [resolved with reflash] | https://openbci.com/forum/index.php
77 | 2257 | 145.8 | Noise at 30Hz when electrodes are not attached | https://openbci.com/forum/index.php
78 | 1907 | 145.5 | Myoware, measuring muscle fatigue - asking for hardware advice | https://openbci.com/forum/index.php
79 | 2112 | 144.5 | Trouble getting alpha waves, Cyton with Ultracortex | https://openbci.com/forum/index.php
80 | 2507 | 144.2 | WiFi connection with different ESP8266 [resolved] | https://openbci.com/forum/index.php
81 | 3887 | 143.5 | openbci-ceegrids CythonDaisy Board- GUI | https://openbci.com/forum/index.php?p=/discussion/3887/openbci-ceegrids-cythondaisy-board-gui
82 | 3112 | 142.2 | details of skin-electrode impedance measurement ? | https://openbci.com/forum/index.php
83 | 3084 | 142.0 | EMG recording shows discontinuous jumps in data | https://openbci.com/forum/index.php
84 | 2095 | 141.2 | SRB and references | https://openbci.com/forum/index.php?p=/discussion/2095/srb-and-references
85 | 1471 | 140.8 | What impedances are to expect using the standard dry electrodes? | https://openbci.com/forum/index.php
86 | 2163 | 139.8 | Weird 60Hz burst on some Ultracortex electrodes only | https://openbci.com/forum/index.php
87 | 2206 | 139.8 | what is the relationship between high impedance on EEG channels and 50/60hz noise? | https://openbci.com/forum/index.php
88 | 1501 | 139.5 | EEG Single-channel minimum electrode montage | https://openbci.com/forum/index.php?p=/discussion/1501/eeg-single-channel-minimum-electrode-montage
89 | 1079 | 138.8 | AJ's new Wifi Shield / beta testers signup | https://openbci.com/forum/index.php?p=/discussion/1079/ajs-new-wifi-shield-beta-testers-signup
90 | 1677 | 138.8 | Migraine-relief training | https://openbci.com/forum/index.php?p=/discussion/1677/migraine-relief-training
91 | 2313 | 138.2 | headband kit for sleep EEG? / longterm EEG techniques | https://openbci.com/forum/index.php
92 | 3553 | 138.0 | Bias feedback | https://openbci.com/forum/index.php?p=/discussion/3553/bias-feedback
93 | 2940 | 137.0 | Sending EEG and accelerometer data to LSL through BrainFlow [resolved] | https://openbci.com/forum/index.php
94 | 3822 | 137.0 | ECG Artifacts + Muscle Contamination in simultaneous acquisition of EMG and EEG using Cython + Daisy | https://openbci.com/forum/index.php
95 | 1087 | 136.8 | Connecting Mark IV to Cyton (including Daisy Board) | https://openbci.com/forum/index.php
96 | 891 | 136.0 | Reconstruct uV from ADS1299 24-bit value broken into 3 bytes in matlab | https://openbci.com/forum/index.php
97 | 1418 | 136.0 | signal railed if ear clips are connected to ear | https://openbci.com/forum/index.php
98 | 2484 | 136.0 | Different sampling rate between EEG signal and AUX signal, using LSL from GUI [workaround] | https://openbci.com/forum/index.php
99 | 3446 | 135.0 | Ways to improve data collection quality and increase sample rate | https://openbci.com/forum/index.php
100 | 3609 | 135.0 | EMG Multiclass Classification for Forearm | https://openbci.com/forum/index.php?p=/discussion/3609/emg-multiclass-classification-for-forearm
101 | 928 | 134.5 | skin-impedance measurement of active vs. passive electrodes | https://openbci.com/forum/index.php
102 | 2334 | 134.5 | How to mod Cyton firmware to allow >250Hz SD card sampling rate | https://openbci.com/forum/index.php
103 | 1347 | 134.2 | Ganglion Input-Referred Noise? | https://openbci.com/forum/index.php?p=/discussion/1347/ganglion-input-referred-noise
104 | 1431 | 134.0 | questions on Cyton sampling frequency, GUI, signal processing | https://openbci.com/forum/index.php
105 | 243 | 133.5 | SPI / WiFi transfer EEG data to external device | https://openbci.com/forum/index.php?p=/discussion/243/spi-wifi-transfer-eeg-data-to-external-device
106 | 1476 | 133.5 | Ganglion board noise -> bad ear clips | https://openbci.com/forum/index.php?p=/discussion/1476/ganglion-board-noise-bad-ear-clips
107 | 2599 | 133.0 | Cyton V4? Simultaneous EEG, EMG, ECG. [resolved] | https://openbci.com/forum/index.php?p=/discussion/2599/cyton-v4-simultaneous-eeg-emg-ecg-resolved
108 | 3442 | 132.5 | Ganglion ECG data not matching tutorial data | https://openbci.com/forum/index.php?p=/discussion/3442/ganglion-ecg-data-not-matching-tutorial-data
109 | 3679 | 132.2 | PSD Issue | https://openbci.com/forum/index.php?p=/discussion/3679/psd-issue
110 | 3275 | 131.8 | Which board is best for nerve conduction studies in rats? | https://openbci.com/forum/index.php
111 | 1326 | 131.5 | Noise &amp; ~65hz interference | https://openbci.com/forum/index.php?p=/discussion/1326/noise-amp-65hz-interference
112 | 1902 | 131.5 | Python / Wifi, setting Analog Board Mode shuts off Cyton | https://openbci.com/forum/index.php
113 | 3187 | 131.5 | Ganglion Help needed, constant noise | https://openbci.com/forum/index.php?p=/discussion/3187/ganglion-help-needed-constant-noise
114 | 430 | 130.5 | connecting electrodes with the FRI 19 channel headband | https://openbci.com/forum/index.php
115 | 2251 | 130.5 | DIY Cyton Board: ADS1299 Clamping Signal | https://openbci.com/forum/index.php?p=/discussion/2251/diy-cyton-board-ads1299-clamping-signal
116 | 1656 | 130.0 | Stubborn Artifact noise --> GUI resource allocation | https://openbci.com/forum/index.php
117 | 1746 | 129.2 | I can't understand "spikes of noise" in my EMG signal | https://openbci.com/forum/index.php
118 | 2211 | 129.0 | noise spikes seen with Ganglion | https://openbci.com/forum/index.php?p=/discussion/2211/noise-spikes-seen-with-ganglion
119 | 2295 | 129.0 | alternative to Wifi Shield? recording to SD card / 9" thick wall [resolved] | https://openbci.com/forum/index.php
120 | 3782 | 129.0 | 24-Channel Ultracortex "Mark IV" Setup ? | https://openbci.com/forum/index.php?p=/discussion/3782/24-channel-ultracortex-mark-iv-setup
121 | 1621 | 128.5 | Best connection for 1 channel EEG: differential or SRB2? | https://openbci.com/forum/index.php
122 | 3204 | 128.5 | noise signals in tests with Ultracortex and Ganglion | https://openbci.com/forum/index.php
123 | 3414 | 128.5 | two pins per channel? / simultaneous EEG with EMG, EOG or ECG | https://openbci.com/forum/index.php
124 | 1786 | 128.2 | Ganglion/Simblee streaming Bluetooth to Android Studio Project? | https://openbci.com/forum/index.php
125 | 3333 | 127.8 | Fabric sensors vs Gold cups with Cyton. Can't find alpha. | https://openbci.com/forum/index.php
126 | 1170 | 127.5 | Higher sample rates / sample at 2000hz to SDcard? | https://openbci.com/forum/index.php
127 | 958 | 127.2 | Really bad noise only when I am connected. | https://openbci.com/forum/index.php?p=/discussion/958/really-bad-noise-only-when-i-am-connected
128 | 1546 | 127.2 | Best Caps to use with Cyton in 2018 | https://openbci.com/forum/index.php?p=/discussion/1546/best-caps-to-use-with-cyton-in-2018
129 | 1882 | 127.2 | Problems to detect ERP in EEG Signals | https://openbci.com/forum/index.php?p=/discussion/1882/problems-to-detect-erp-in-eeg-signals
130 | 3936 | 127.0 | EEG Newb Question: EEG snap electrodes vs Gold Cup electrodes | https://openbci.com/forum/index.php
131 | 538 | 126.5 | We built an OpenBCI Cyton / Daisy | https://openbci.com/forum/index.php?p=/discussion/538/we-built-an-openbci-cyton-daisy
132 | 2497 | 126.5 | recording of Speech Evoked Auditory Brainstem Response with Ganglion | https://openbci.com/forum/index.php
133 | 4130 | 126.5 | TTL trigger output synchronization for external electrical stimulator | https://openbci.com/forum/index.php
134 | 2699 | 125.2 | WiFi Shield availablity in store? (need higher sample rate) | https://openbci.com/forum/index.php
135 | 3654 | 125.2 | Functions of BIAS(ground) electrode | https://openbci.com/forum/index.php?p=/discussion/3654/functions-of-bias-ground-electrode
136 | 2390 | 125.0 | Cyton generates a lot of noise even if the electrodes are not connected | https://openbci.com/forum/index.php
137 | 3737 | 125.0 | Cyton picking up noise only on one channel? | https://openbci.com/forum/index.php?p=/discussion/3737/cyton-picking-up-noise-only-on-one-channel
138 | 3136 | 124.8 | Ganglion - missing eyes closed alpha / Electrode Problems? [resolved] | https://openbci.com/forum/index.php
139 | 1912 | 124.5 | bandwidth selection in between 50 Hz to 500Hz | https://openbci.com/forum/index.php?p=/discussion/1912/bandwidth-selection-in-between-50-hz-to-500hz
140 | 1720 | 124.2 | very high DC offset, maxes out ADC | https://openbci.com/forum/index.php?p=/discussion/1720/very-high-dc-offset-maxes-out-adc
141 | 3701 | 123.8 | can I use cyton daisy extension board without the main board? | https://openbci.com/forum/index.php
142 | 2917 | 123.5 | Bias Pinout | https://openbci.com/forum/index.php?p=/discussion/2917/bias-pinout
143 | 3105 | 123.5 | For Sale: OpenBCI 16-channel kit with active electrodes add-on, wifi shield, snap cables and more. | https://openbci.com/forum/index.php
144 | 2171 | 123.2 | 2 cyton boards EEG + ECG, Bias conflict? | https://openbci.com/forum/index.php?p=/discussion/2171/2-cyton-boards-eeg-ecg-bias-conflict
145 | 1533 | 123.0 | Signal quality difference between Cyton and Ganglion | https://openbci.com/forum/index.php
146 | 3603 | 122.8 | question on EMG with LSL | https://openbci.com/forum/index.php?p=/discussion/3603/question-on-emg-with-lsl
147 | 2743 | 122.5 | Sensitivity to background noise problem Ganglion vs Cython | https://openbci.com/forum/index.php
148 | 3953 | 122.5 | Low-frequency noise (instability?) when BIAS amp is used on custom Cyton-based board | https://openbci.com/forum/index.php
149 | 4094 | 121.2 | What caused this abnormal (high frequency noise) phenomenon? | https://openbci.com/forum/index.php
150 | 1595 | 121.0 | how to handle dropped packets? [DIY-Cyton] LabVIEW. | https://openbci.com/forum/index.php
151 | 247 | 120.5 | Velcro saline sensor headset | https://openbci.com/forum/index.php?p=/discussion/247/velcro-saline-sensor-headset
152 | 1171 | 120.5 | ADS1299 common-mode interference problem ? | https://openbci.com/forum/index.php?p=/discussion/1171/ads1299-common-mode-interference-problem
153 | 3615 | 120.5 | Sampling rate modification on Cyton board | https://openbci.com/forum/index.php?p=/discussion/3615/sampling-rate-modification-on-cyton-board
154 | 1105 | 120.2 | How to practically increase sample rate? | https://openbci.com/forum/index.php?p=/discussion/1105/how-to-practically-increase-sample-rate
155 | 2012 | 120.0 | Cyton, Wifi Shield, Python (wifi.py): bad raw sample values / but fine using GUI | https://openbci.com/forum/index.php
156 | 3418 | 120.0 | UNABLE TO PROGRAM PIC32 DUE TO FLASH ERROR: "Program memory is not blank" | https://openbci.com/forum/index.php
157 | 3073 | 119.8 | alternative electrodes, to avoid paste allergy ? [resolved] | https://openbci.com/forum/index.php
158 | 1503 | 119.5 | SRB2 off in OpenBCI, how to process it in txt/csv files? | https://openbci.com/forum/index.php
159 | 1226 | 119.2 | EEG results and subject movement | https://openbci.com/forum/index.php?p=/discussion/1226/eeg-results-and-subject-movement
160 | 857 | 119.0 | how to measure electrode impedance? | https://openbci.com/forum/index.php?p=/discussion/857/how-to-measure-electrode-impedance
161 | 1319 | 119.0 | Sample Rates with Wifi Direct | https://openbci.com/forum/index.php?p=/discussion/1319/sample-rates-with-wifi-direct
162 | 1512 | 119.0 | Recording microphone / audio signals on OpenBCI for use as a trigger channel | https://openbci.com/forum/index.php
163 | 3920 | 119.0 | Verbal mind reading using OpenBCI tech | https://openbci.com/forum/index.php?p=/discussion/3920/verbal-mind-reading-using-openbci-tech
164 | 1559 | 118.0 | TLC272 DIY active electrodes, bias connection saturate the output value | https://openbci.com/forum/index.php
165 | 2752 | 118.0 | EMG Streaming from OpenBCI_GUI to Arduino | https://openbci.com/forum/index.php?p=/discussion/2752/emg-streaming-from-openbci-gui-to-arduino
166 | 3543 | 118.0 | The channel of C3 electrode railed if connect the BIAS channel | https://openbci.com/forum/index.php
167 | 3647 | 118.0 | quite low amplitude using micro SD | https://openbci.com/forum/index.php?p=/discussion/3647/quite-low-amplitude-using-micro-sd
168 | 206 | 117.5 | OpenViBE P300 Speller tutorial / questions | https://openbci.com/forum/index.php?p=/discussion/206/openvibe-p300-speller-tutorial-questions
169 | 1626 | 117.5 | No OpenBCI board attached to Wifi Shield, with Cyton v3.1.1, shield v2.0.5 | https://openbci.com/forum/index.php
170 | 1139 | 117.2 | Noise repeats at 5 second intervals | https://openbci.com/forum/index.php?p=/discussion/1139/noise-repeats-at-5-second-intervals
171 | 2641 | 117.0 | 5 Hz Noise/Artifact in all 16 channels [resolved] | https://openbci.com/forum/index.php
172 | 3605 | 117.0 | dry vs wet electrodes | https://openbci.com/forum/index.php?p=/discussion/3605/dry-vs-wet-electrodes
173 | 3870 | 117.0 | Impedance fix / Impedance in LSL stream / Custom electrode layout | https://openbci.com/forum/index.php
174 | 3790 | 116.2 | High impedance | https://openbci.com/forum/index.php?p=/discussion/3790/high-impedance
175 | 2435 | 115.5 | Over 250 SPS to SD card using bluetooth dongle | https://openbci.com/forum/index.php
176 | 2107 | 115.2 | external audio triggers / oddball paradigm / increase sampling frequency? | https://openbci.com/forum/index.php
177 | 2547 | 115.2 | Buying ear clips | https://openbci.com/forum/index.php?p=/discussion/2547/buying-ear-clips
178 | 1246 | 115.0 | Can I use the GUI to change the analog chip's sample rate? | https://openbci.com/forum/index.php
179 | 3992 | 114.8 | BIAS pin seems to enhance noise, use alternative BIAS meas? | https://openbci.com/forum/index.php
180 | 794 | 114.5 | touch proof electrode adapter with Electro-cap | https://openbci.com/forum/index.php?p=/discussion/794/touch-proof-electrode-adapter-with-electro-cap
181 | 2461 | 114.5 | questions on Cyton SRB1/SRB2, BIAS and the OpenBCI electrode cap | https://openbci.com/forum/index.php
182 | 3525 | 114.5 | Which EEG headset | https://openbci.com/forum/index.php?p=/discussion/3525/which-eeg-headset
183 | 3563 | 114.5 | noise, high impedance: electrode cap with Cyton+Daisy | https://openbci.com/forum/index.php
184 | 2564 | 114.2 | Improving Signal Quality with Dry Electrodes | https://openbci.com/forum/index.php?p=/discussion/2564/improving-signal-quality-with-dry-electrodes
185 | 1157 | 114.0 | UltraCortex MK4 - Unreliable readings | https://openbci.com/forum/index.php?p=/discussion/1157/ultracortex-mk4-unreliable-readings
186 | 1440 | 114.0 | Which OpenBCI board? / controlling external hardware | https://openbci.com/forum/index.php
187 | 2055 | 114.0 | Using a custom ESP32 / Ganglion board with serial connection to OpenBCI GUI | https://openbci.com/forum/index.php
188 | 2288 | 113.5 | Active electrodes (TLC272) | https://openbci.com/forum/index.php?p=/discussion/2288/active-electrodes-tlc272
189 | 2329 | 113.5 | How steady is Cyton's sampling rate? [resolved] | https://openbci.com/forum/index.php?p=/discussion/2329/how-steady-is-cytons-sampling-rate-resolved
190 | 3062 | 113.2 | EEG recording for small dogs [resolved] | https://openbci.com/forum/index.php?p=/discussion/3062/eeg-recording-for-small-dogs-resolved
191 | 1695 | 113.0 | Using Wifi shield to Stream Data to a 3rd Party Micro controller (like a Huzzah) | https://openbci.com/forum/index.php
192 | 1750 | 112.8 | Beginner question: 200hz vs 250hz and 'spatial resolution' | https://openbci.com/forum/index.php
193 | 2157 | 112.5 | Can I replace the wet electrodes in EEG Electrode Cap by dry electrodes? | https://openbci.com/forum/index.php
194 | 3865 | 112.2 | Amplitude if I use 16ch weaker than 8ch | https://openbci.com/forum/index.php?p=/discussion/3865/amplitude-if-i-use-16ch-weaker-than-8ch
195 | 884 | 112.0 | OpenBCI 8 channel clone with STM32 processor | https://openbci.com/forum/index.php?p=/discussion/884/openbci-8-channel-clone-with-stm32-processor
196 | 1574 | 112.0 | Comparing ERPs across OpenBCI, Biosemi, Emotiv | https://openbci.com/forum/index.php?p=/discussion/1574/comparing-erps-across-openbci-biosemi-emotiv
197 | 3102 | 112.0 | Ultracortex electrodes contact for high quality EEG-signal [resolved] | https://openbci.com/forum/index.php
198 | 2997 | 111.2 | How do we change the sampling frequency of the WiFi board? | https://openbci.com/forum/index.php
199 | 2395 | 111.0 | DIY board, daisy data stream with USB to serial converter [resolved] | https://openbci.com/forum/index.php
200 | 3858 | 111.0 | EMG bandwidth to calculate Shannon–Hartley theorem | https://openbci.com/forum/index.php
201 | 3285 | 110.8 | What does reference impedance mean and what should I expect? | https://openbci.com/forum/index.php
202 | 4091 | 110.5 | cEEGrid missing second half of channels (9–16) | https://openbci.com/forum/index.php?p=/discussion/4091/ceegrid-missing-second-half-of-channels-9-16
203 | 1488 | 110.2 | EEG with Arduino and Arduino WiFi Shield | https://openbci.com/forum/index.php?p=/discussion/1488/eeg-with-arduino-and-arduino-wifi-shield
204 | 614 | 110.0 | Change sampling rate (frequency) | https://openbci.com/forum/index.php?p=/discussion/614/change-sampling-rate-frequency
205 | 3900 | 110.0 | In search of old hardware schematic for the ads1299 breakout board | https://openbci.com/forum/index.php
206 | 4088 | 109.5 | cEEGrid Adapter to ADS1299EEGFE-PDK – selection of connectors MB1-120, M20-8891045, PCB, pins | https://openbci.com/forum/index.php
207 | 967 | 107.8 | GUI Unexpected Impedance Measurement with Cyton | https://openbci.com/forum/index.php
208 | 2686 | 107.2 | could OpenBCI support Texas Instruments ADS1299EEGFE-PDK ? | https://openbci.com/forum/index.php
209 | 3513 | 107.2 | signal has a sudden drop in one channel while recording with Cyton | https://openbci.com/forum/index.php
210 | 3425 | 107.0 | Why is there no ground electrode on myoware? | https://openbci.com/forum/index.php?p=/discussion/3425/why-is-there-no-ground-electrode-on-myoware
211 | 1939 | 105.8 | ADS124S08IPBS vs ADS1299 | https://openbci.com/forum/index.php?p=/discussion/1939/ads124s08ipbs-vs-ads1299
212 | 3549 | 105.0 | Root cause no data streaming for Cyton | https://openbci.com/forum/index.php?p=/discussion/3549/root-cause-no-data-streaming-for-cyton
213 | 3661 | 105.0 | how to record rTMS sync information with EEG on Cyton | https://openbci.com/forum/index.php
214 | 255 | 104.8 | schematic source files for OpenBCI boards | https://openbci.com/forum/index.php?p=/discussion/255/schematic-source-files-for-openbci-boards
215 | 3552 | 104.0 | Once cannot start the system/session but twice | https://openbci.com/forum/index.php
216 | 2311 | 103.0 | measuring EMG using a ganglion board | https://openbci.com/forum/index.php?p=/discussion/2311/measuring-emg-using-a-ganglion-board
217 | 2476 | 101.8 | impedances, less with pressure; what is normal range? [resolved] | https://openbci.com/forum/index.php
218 | 2891 | 100.5 | ADS1299 usable with lithium cell ? [resolved] | https://openbci.com/forum/index.php?p=/discussion/2891/ads1299-usable-with-lithium-cell-resolved
219 | 1643 | 100.0 | Is the raw data saved to the .csv file already referenced to SRB channel? | https://openbci.com/forum/index.php
220 | 3416 | 100.0 | EEG circuit with ADS1299. Help on schematic, SSI comms and PCB layout | https://openbci.com/forum/index.php
221 | 1997 | 99.2 | Building Cyton questions: 4 layer required, BOM vs schematic | https://openbci.com/forum/index.php
222 | 4010 | 98.5 | Ganglion Impedance measurement | https://openbci.com/forum/index.php?p=/discussion/4010/ganglion-impedance-measurement
223 | 1920 | 98.0 | Wired Cyton. Device connected on GUI but no data stream is displayed | https://openbci.com/forum/index.php
224 | 2890 | 98.0 | ADS1299 to Cyton Pins | https://openbci.com/forum/index.php?p=/discussion/2890/ads1299-to-cyton-pins
225 | 2260 | 97.5 | Cyton Impedance Measurement, at different frequencies? | https://openbci.com/forum/index.php
226 | 727 | 97.0 | SD-only version for increased sample rate and interrupts | https://openbci.com/forum/index.php
227 | 118 | 95.0 | stimulus integration | https://openbci.com/forum/index.php?p=/discussion/118/stimulus-integration
228 | 1854 | 94.8 | No signals EEG, DIY-Cyton 8ch | https://openbci.com/forum/index.php?p=/discussion/1854/no-signals-eeg-diy-cyton-8ch
229 | 359 | 94.0 | direct MATLAB serial interface vs LSL ? | https://openbci.com/forum/index.php?p=/discussion/359/direct-matlab-serial-interface-vs-lsl
230 | 1252 | 94.0 | where to place the + relative to - electrodes in differential mode? | https://openbci.com/forum/index.php
231 | 3819 | 94.0 | question on OpenBCI_Python repository with wifi | https://openbci.com/forum/index.php
232 | 3909 | 92.2 | How to Extract Electrode Impedance Values with UNIX Timestamps? | https://openbci.com/forum/index.php
233 | 616 | 92.0 | ADS1299 EEG board with isolated CANbus, USB, prototyping, etc. | https://openbci.com/forum/index.php
234 | 2574 | 91.5 | Accuracy of impedance test signal on Ganglion | https://openbci.com/forum/index.php?p=/discussion/2574/accuracy-of-impedance-test-signal-on-ganglion
235 | 2919 | 91.5 | Frequency of Impedance Measurement using Cyton Board | https://openbci.com/forum/index.php
236 | 1466 | 90.5 | Input impedance of the Ganglion board? | https://openbci.com/forum/index.php?p=/discussion/1466/input-impedance-of-the-ganglion-board
237 | 3955 | 90.0 | cyton and daisy sending only 0 value data | https://openbci.com/forum/index.php?p=/discussion/3955/cyton-and-daisy-sending-only-0-value-data
238 | 3208 | 89.5 | Cyton board with ADS1298 and another microcontroller | https://openbci.com/forum/index.php
239 | 3343 | 89.0 | LSL Streaming Time Series Un filtered | https://openbci.com/forum/index.php?p=/discussion/3343/lsl-streaming-time-series-un-filtered
240 | 3527 | 87.5 | Gelfree electrode cap: impedance fluctuation | https://openbci.com/forum/index.php?p=/discussion/3527/gelfree-electrode-cap-impedance-fluctuation
241 | 2380 | 86.5 | Cyton impedance calculations | https://openbci.com/forum/index.php?p=/discussion/2380/cyton-impedance-calculations
242 | 1802 | 85.8 | Having issue consuming openbci_lsl data from liblsl_matlab | https://openbci.com/forum/index.php
243 | 1652 | 85.2 | No Data Stream - Cyton V3, Serial, GUI 3.3.1, Win 10 | https://openbci.com/forum/index.php
244 | 1850 | 84.5 | Synchronizing two Cyton+Daisy boards in order to get 32 channels | https://openbci.com/forum/index.php
245 | 2198 | 84.5 | can I change driving current used in impedance calculation? | https://openbci.com/forum/index.php
246 | 3676 | 83.2 | Difference between Electrode impedance and Skin-Electrode impedance? | https://openbci.com/forum/index.php
247 | 2528 | 82.0 | Can I simply solder a ADS1299-4PAGR to get fewer channels? | https://openbci.com/forum/index.php
248 | 1524 | 81.8 | BIAS. Why do I need it? | https://openbci.com/forum/index.php?p=/discussion/1524/bias-why-do-i-need-it
249 | 2207 | 81.5 | is continuous monitoring of impedance possible while recording EEG? | https://openbci.com/forum/index.php
250 | 2617 | 81.5 | Daisy CLKSEL question | https://openbci.com/forum/index.php?p=/discussion/2617/daisy-clksel-question
251 | 3788 | 81.5 | How far apart do ground, ref, and signal electrodes have to be? | https://openbci.com/forum/index.php
252 | 4009 | 79.5 | what is the impedance of Cyton? | https://openbci.com/forum/index.php?p=/discussion/4009/what-is-the-impedance-of-cyton
253 | 2947 | 78.5 | measuring impedance of single vs several electrodes at once [resolved] | https://openbci.com/forum/index.php
254 | 3754 | 78.5 | Impedance value changes for no reason | https://openbci.com/forum/index.php?p=/discussion/3754/impedance-value-changes-for-no-reason
255 | 1078 | 78.0 | Programming of OpenBCI 32 bit PIC controller (DIY board fabrication) | https://openbci.com/forum/index.php
256 | 1198 | 78.0 | Question about ADS1299 Daisy-Chain with STM32 | https://openbci.com/forum/index.php?p=/discussion/1198/question-about-ads1299-daisy-chain-with-stm32
257 | 3287 | 76.2 | BIAS OUT pin non accessibile sulla scheda Cyton | https://openbci.com/forum/index.php
258 | 3722 | 75.0 | Measure at a higher sampling rate | https://openbci.com/forum/index.php?p=/discussion/3722/measure-at-a-higher-sampling-rate
259 | 1424 | 74.0 | How to programming ADS1299 ? | https://openbci.com/forum/index.php?p=/discussion/1424/how-to-programming-ads1299
260 | 1921 | 74.0 | Getting Started | https://openbci.com/forum/index.php?p=/discussion/1921/getting-started
261 | 3807 | 74.0 | Ganglion, dry electrodes, expected impedance ? | https://openbci.com/forum/index.php?p=/discussion/3807/ganglion-dry-electrodes-expected-impedance
262 | 1405 | 71.0 | Circuit Boards | https://openbci.com/forum/index.php?p=/discussion/1405/circuit-boards
263 | 3417 | 71.0 | Strange signal from one of my daisy boards. | https://openbci.com/forum/index.php?p=/discussion/3417/strange-signal-from-one-of-my-daisy-boards
264 | 1839 | 70.5 | Ganglion impedance calculation in GUI | https://openbci.com/forum/index.php?p=/discussion/1839/ganglion-impedance-calculation-in-gui
265 | 3948 | 70.5 | Cyton+Daisy+CEEGrid | https://openbci.com/forum/index.php?p=/discussion/3948/cyton-daisy-ceegrid
266 | 1362 | 70.0 | Myoware connects to a fan | https://openbci.com/forum/index.php?p=/discussion/1362/myoware-connects-to-a-fan
267 | 1731 | 70.0 | Simulation of the circuit | https://openbci.com/forum/index.php?p=/discussion/1731/simulation-of-the-circuit
268 | 1341 | 69.5 | OpenBCI_Python output: "$$$daisy removed" & Test.log.py | https://openbci.com/forum/index.php
269 | 4122 | 69.5 | EEG Snap Electrodes Information | https://openbci.com/forum/index.php?p=/discussion/4122/eeg-snap-electrodes-information
270 | 4124 | 69.5 | EEG Headband Kit Compatibility with Third-Party Boards | https://openbci.com/forum/index.php
271 | 1225 | 68.8 | Impedance test in Cyton board. | https://openbci.com/forum/index.php?p=/discussion/1225/impedance-test-in-cyton-board
272 | 1030 | 68.5 | reading sub-vocalizations via EEG or EMG | https://openbci.com/forum/index.php?p=/discussion/1030/reading-sub-vocalizations-via-eeg-or-emg
273 | 3421 | 68.2 | Daisy not detected | https://openbci.com/forum/index.php?p=/discussion/3421/daisy-not-detected
274 | 2999 | 68.0 | ADS1299 failure | https://openbci.com/forum/index.php?p=/discussion/2999/ads1299-failure
275 | 3210 | 68.0 | Can the ADS1299 be replaced by ADS130E08 ? | https://openbci.com/forum/index.php?p=/discussion/3210/can-the-ads1299-be-replaced-by-ads130e08
276 | 2099 | 67.2 | Creative Commons CCBY | https://openbci.com/forum/index.php?p=/discussion/2099/creative-commons-ccby
277 | 2078 | 67.0 | LIS3DH Registers all set to either FF or 00 | https://openbci.com/forum/index.php?p=/discussion/2078/lis3dh-registers-all-set-to-either-ff-or-00
278 | 1915 | 66.8 | Multiple SPI problem | https://openbci.com/forum/index.php?p=/discussion/1915/multiple-spi-problem
279 | 3270 | 65.5 | Logic behind railed and not railed derivation | https://openbci.com/forum/index.php?p=/discussion/3270/logic-behind-railed-and-not-railed-derivation
280 | 2657 | 65.0 | Replacing PIC32MX250F128 | https://openbci.com/forum/index.php?p=/discussion/2657/replacing-pic32mx250f128
281 | 4079 | 65.0 | Why is BiasOut run through 1M resistor in Series? | https://openbci.com/forum/index.php
282 | 1526 | 64.8 | Can I use more than one MyoWare with an OpenBCI board? | https://openbci.com/forum/index.php
283 | 1313 | 64.5 | How do I "normalize" the wave functions of each Channel based on their impedance? | https://openbci.com/forum/index.php
284 | 2665 | 63.5 | Using an ADS with 4-6 channels | https://openbci.com/forum/index.php?p=/discussion/2665/using-an-ads-with-4-6-channels
285 | 2121 | 63.0 | Use OpenBCI_GUI with ADS1298ECGFE-PDK | https://openbci.com/forum/index.php?p=/discussion/2121/use-openbci-gui-with-ads1298ecgfe-pdk
286 | 2674 | 63.0 | Cyton SPI SCLK frequency | https://openbci.com/forum/index.php?p=/discussion/2674/cyton-spi-sclk-frequency
287 | 2704 | 63.0 | Do OpenBCI products have "international approval"? | https://openbci.com/forum/index.php
288 | 3023 | 63.0 | Question regarding PIC32 SPI bus on the Cyton board | https://openbci.com/forum/index.php
289 | 3453 | 63.0 | Building Cyton Board with ADS1298IPAG | https://openbci.com/forum/index.php?p=/discussion/3453/building-cyton-board-with-ads1298ipag
290 | 3364 | 60.0 | Cyton & Diasy Schematic | https://openbci.com/forum/index.php?p=/discussion/3364/cyton-diasy-schematic
291 | 3780 | 58.2 | cEEGrid and P300 speller | https://openbci.com/forum/index.php?p=/discussion/3780/ceegrid-and-p300-speller
292 | 1055 | 57.0 | [Beginner] EEG Sync with Movies! | https://openbci.com/forum/index.php?p=/discussion/1055/beginner-eeg-sync-with-movies
293 | 1975 | 55.0 | Compatibility of older Daisy with Cyton having V3.x firmware | https://openbci.com/forum/index.php
294 | 2440 | 55.0 | Are there any design limitations in merging the daisy and cyton board into 1? | https://openbci.com/forum/index.php
295 | 2808 | 55.0 | Order of data for Cyton Daisy (16 Channels) | https://openbci.com/forum/index.php?p=/discussion/2808/order-of-data-for-cyton-daisy-16-channels
296 | 328 | 51.0 | Cyton Component Questions | https://openbci.com/forum/index.php?p=/discussion/328/cyton-component-questions
297 | 1542 | 48.5 | Intan making interesting chips. | https://openbci.com/forum/index.php?p=/discussion/1542/intan-making-interesting-chips
298 | 4103 | 47.0 | EEG Mouse Cursor | https://openbci.com/forum/index.php?p=/discussion/4103/eeg-mouse-cursor
299 | 1355 | 45.0 | Uploading Electrode Location Information to EEGLAB | https://openbci.com/forum/index.php
300 | 3035 | 36.5 | FreeEEG32 crowdfunding started | https://openbci.com/forum/index.php?p=/discussion/3035/freeeeg32-crowdfunding-started
