rkrafted/silent-speech/(list of files, drawings)

Other design files:
hw/dock/route/dock.dsn
hw/pod/route/pod.dsn
hw/tab_electrode/route/tab.dsn
