rkrafted/silent-speech/hw/revisions/2026-10-19-591862ab/pod/pod.kicad_pcb

## KiCad design hw/revisions/2026-10-19-591862ab/pod/pod.kicad_pcb (2026-10-31)

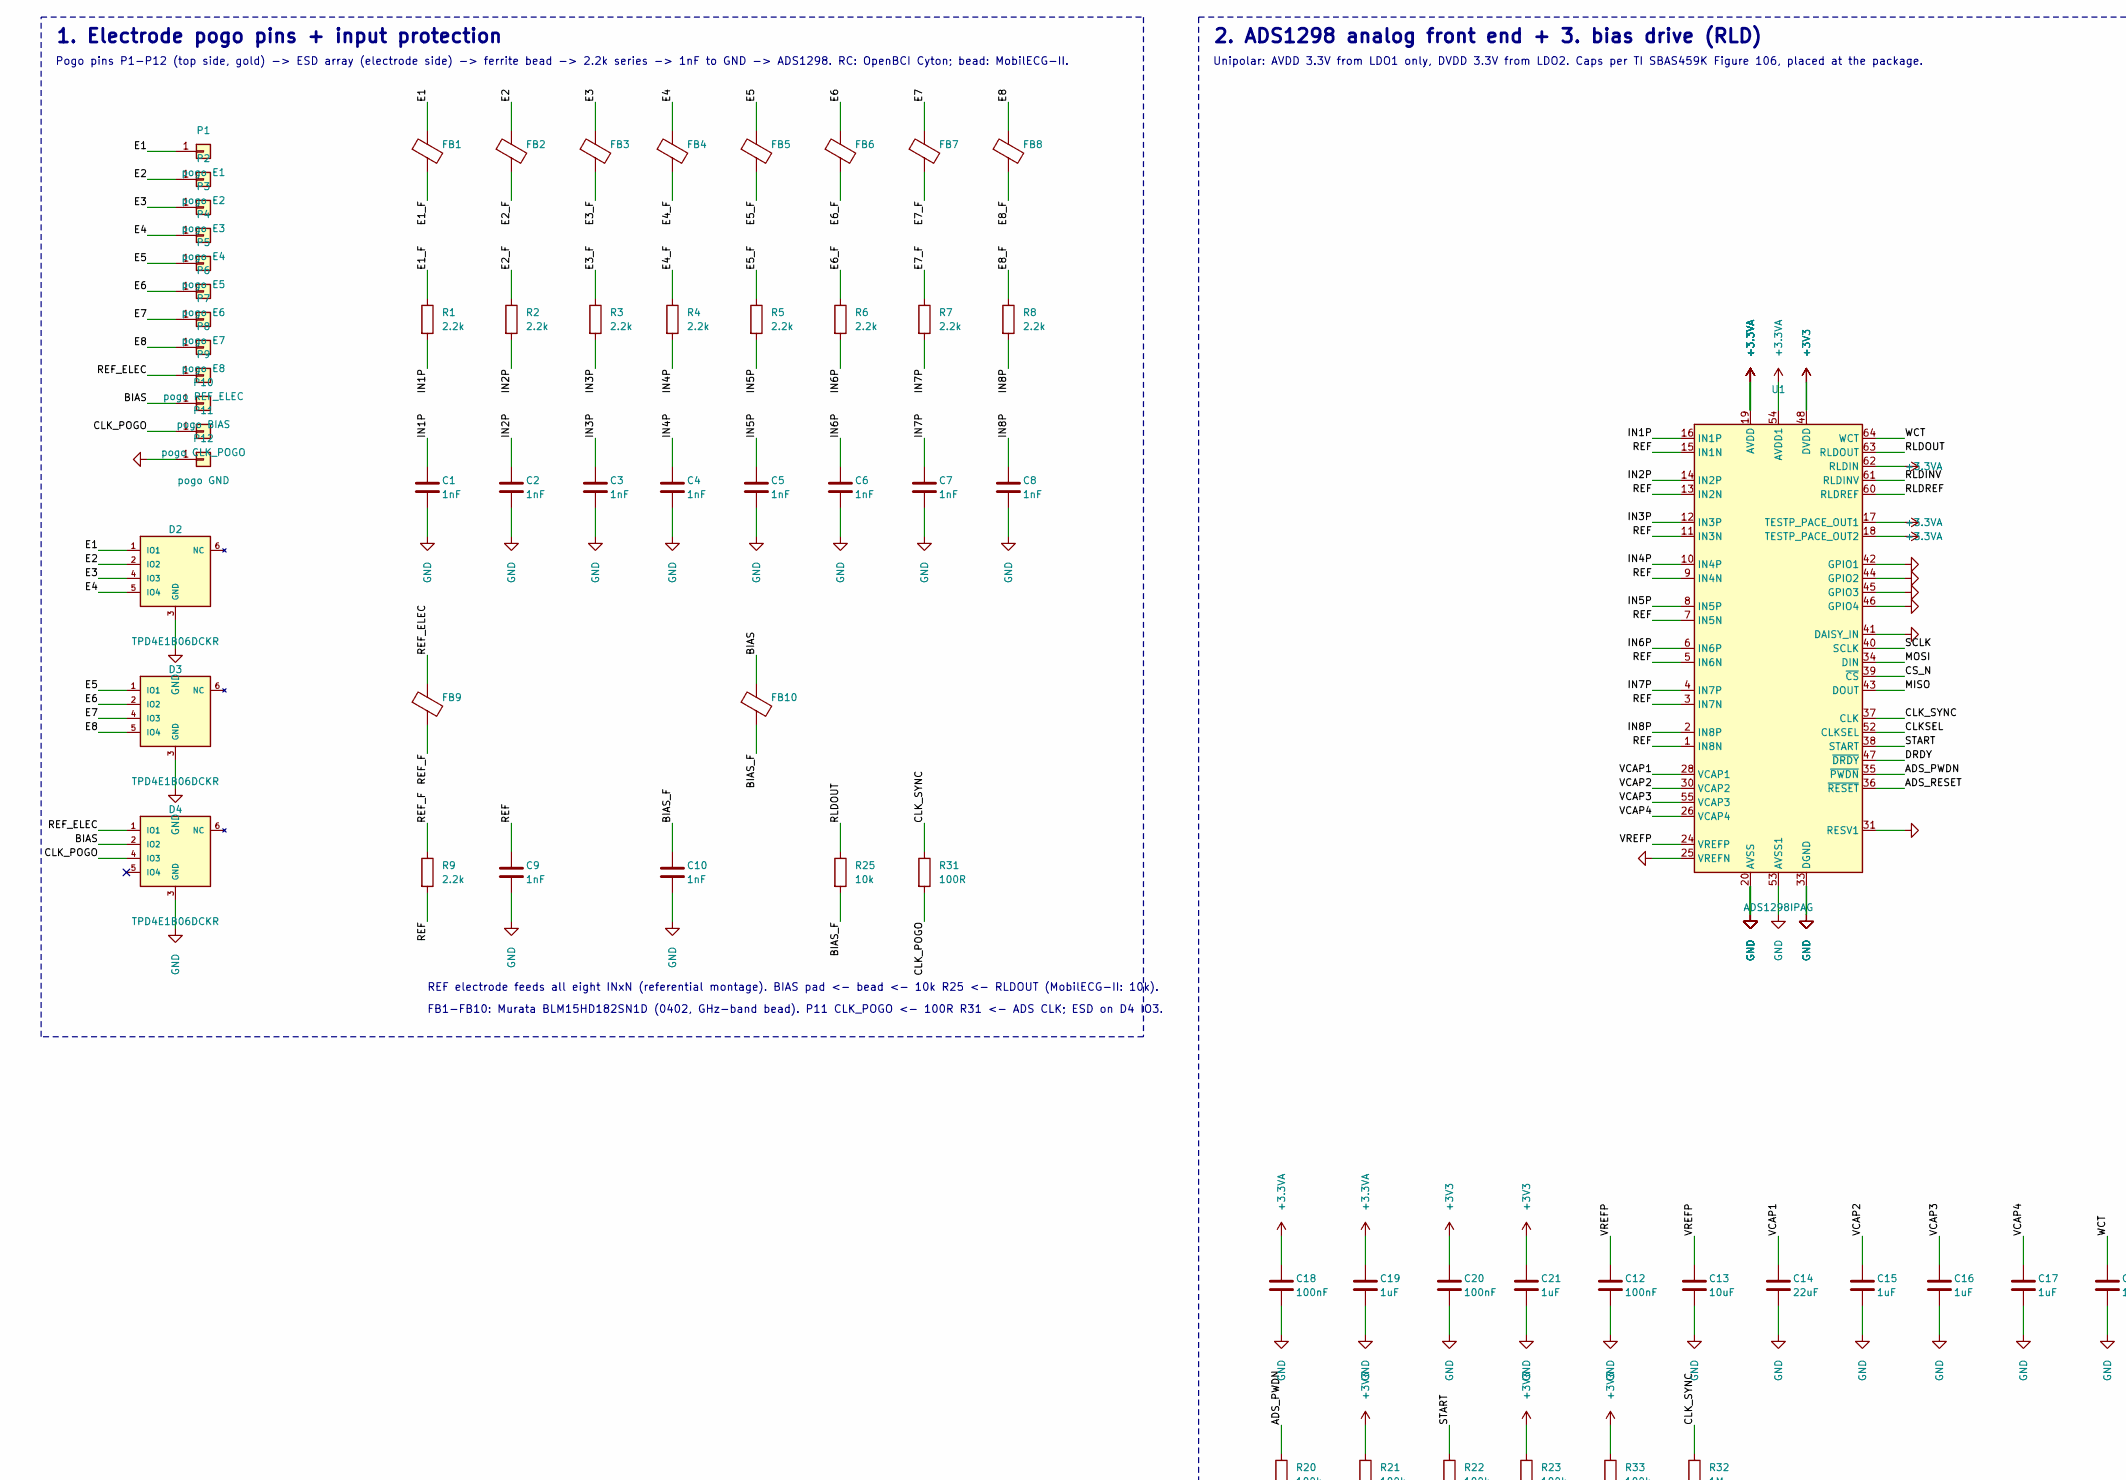
[picture p2: schematic pod.kicad_sch, ss-pod v1: ADS1298 + nRF52840 (NINA-B306) EMG pod, part in row 1, column 1]

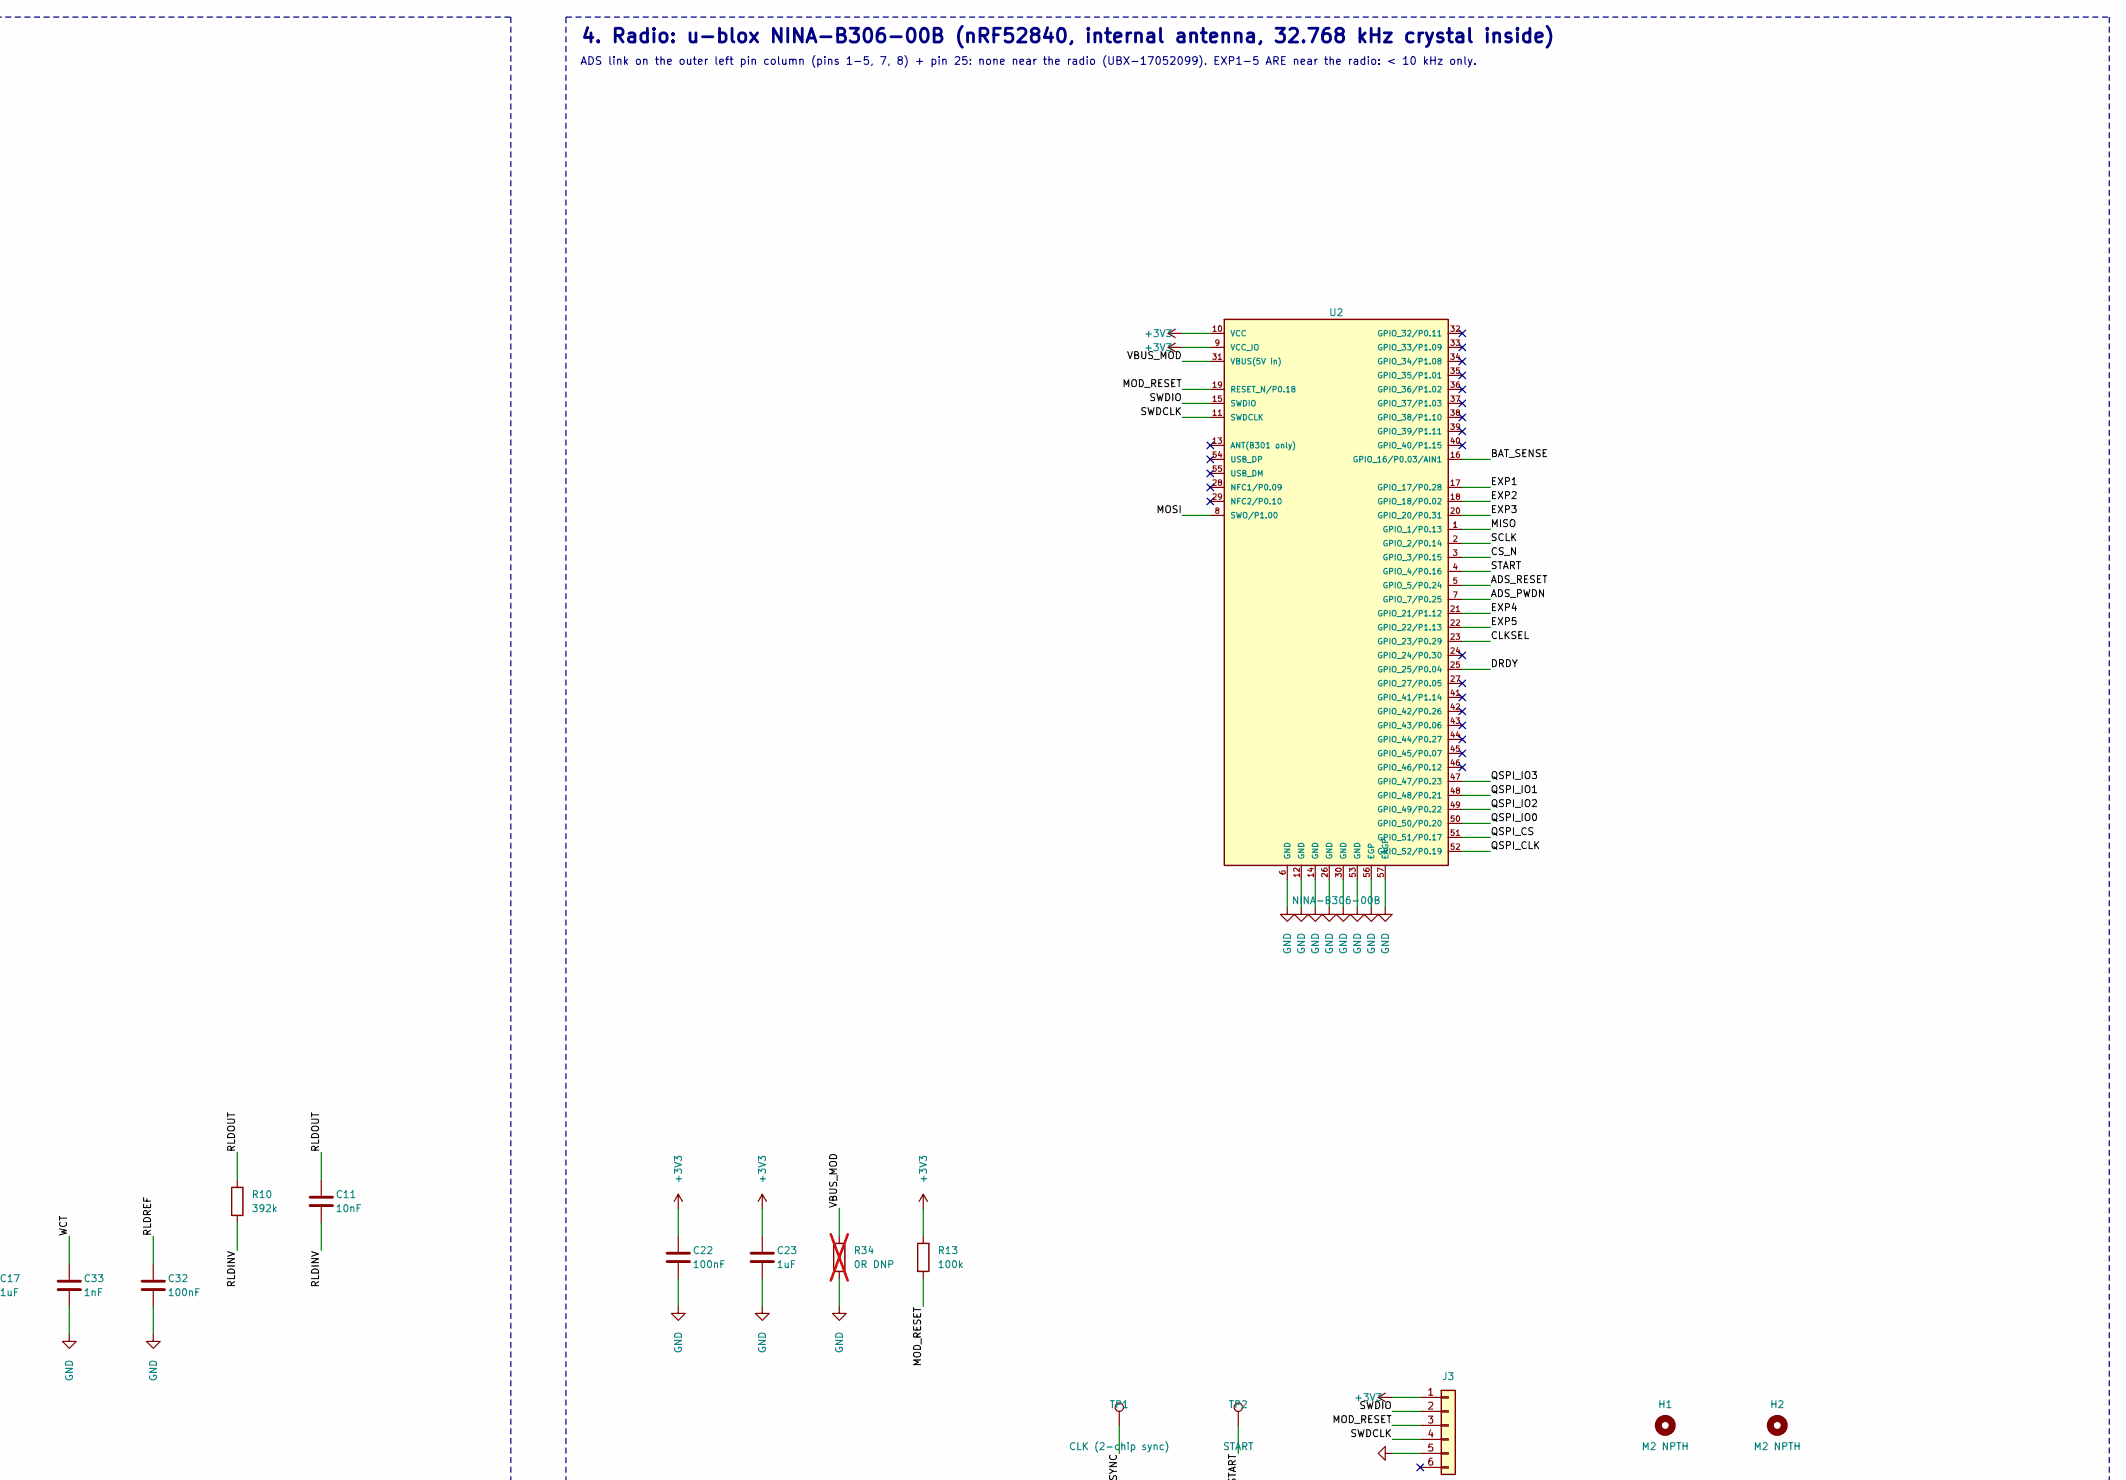
[picture p3: schematic pod.kicad_sch, ss-pod v1: ADS1298 + nRF52840 (NINA-B306) EMG pod, part in row 1, column 2]

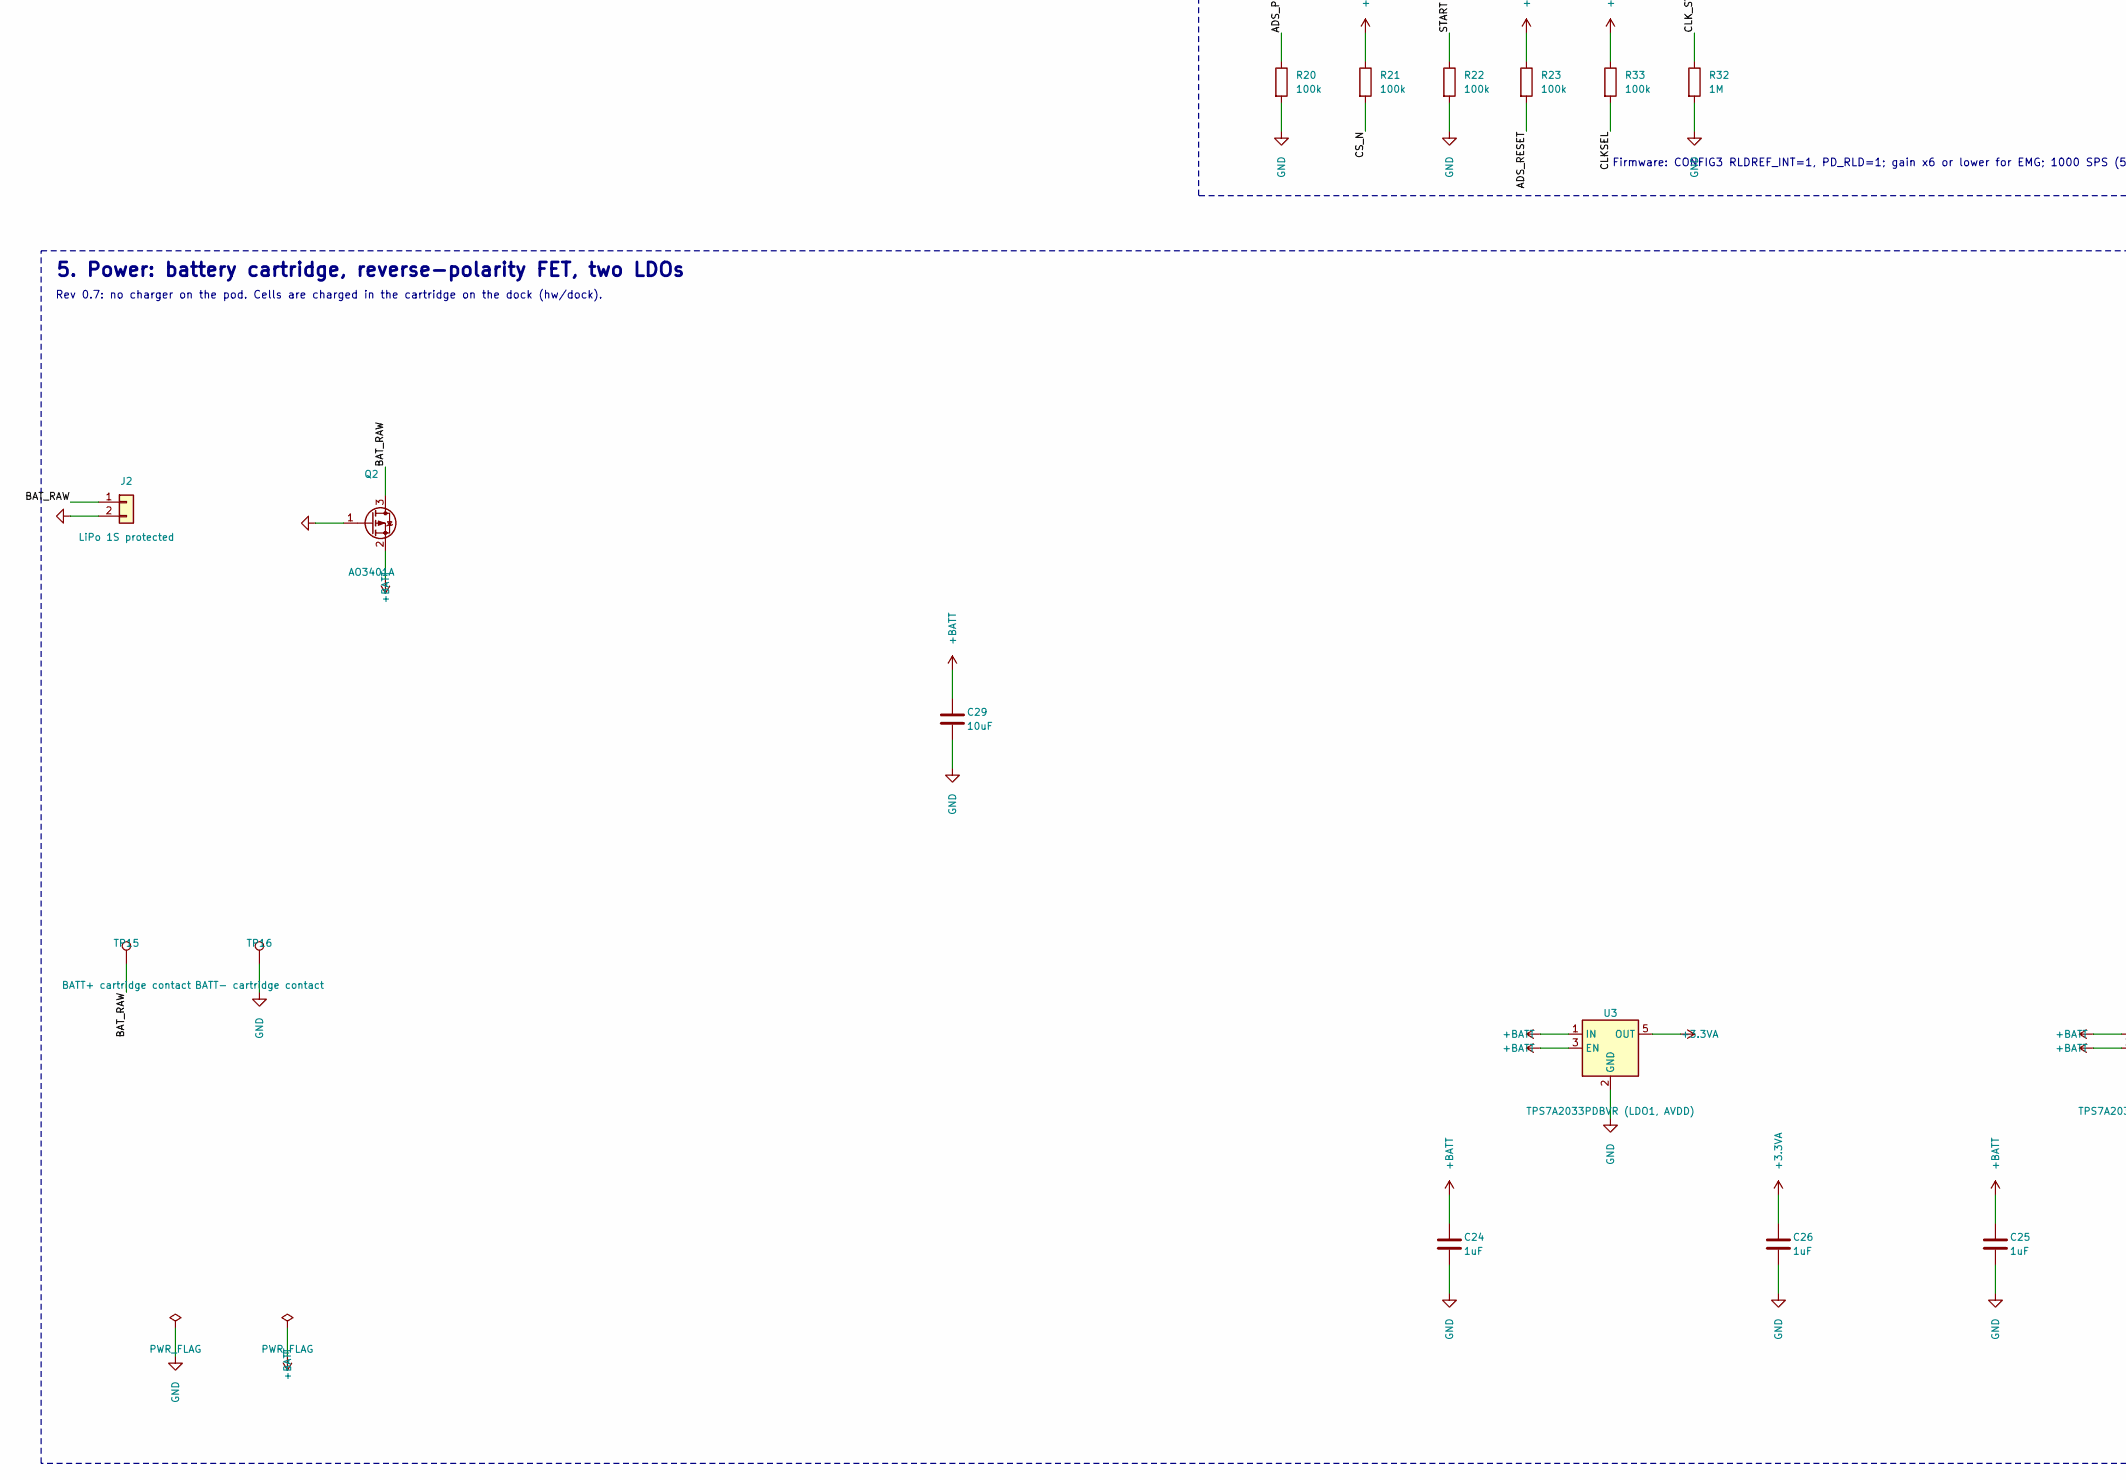
[picture p4: schematic pod.kicad_sch, ss-pod v1: ADS1298 + nRF52840 (NINA-B306) EMG pod, part in row 2, column 1]

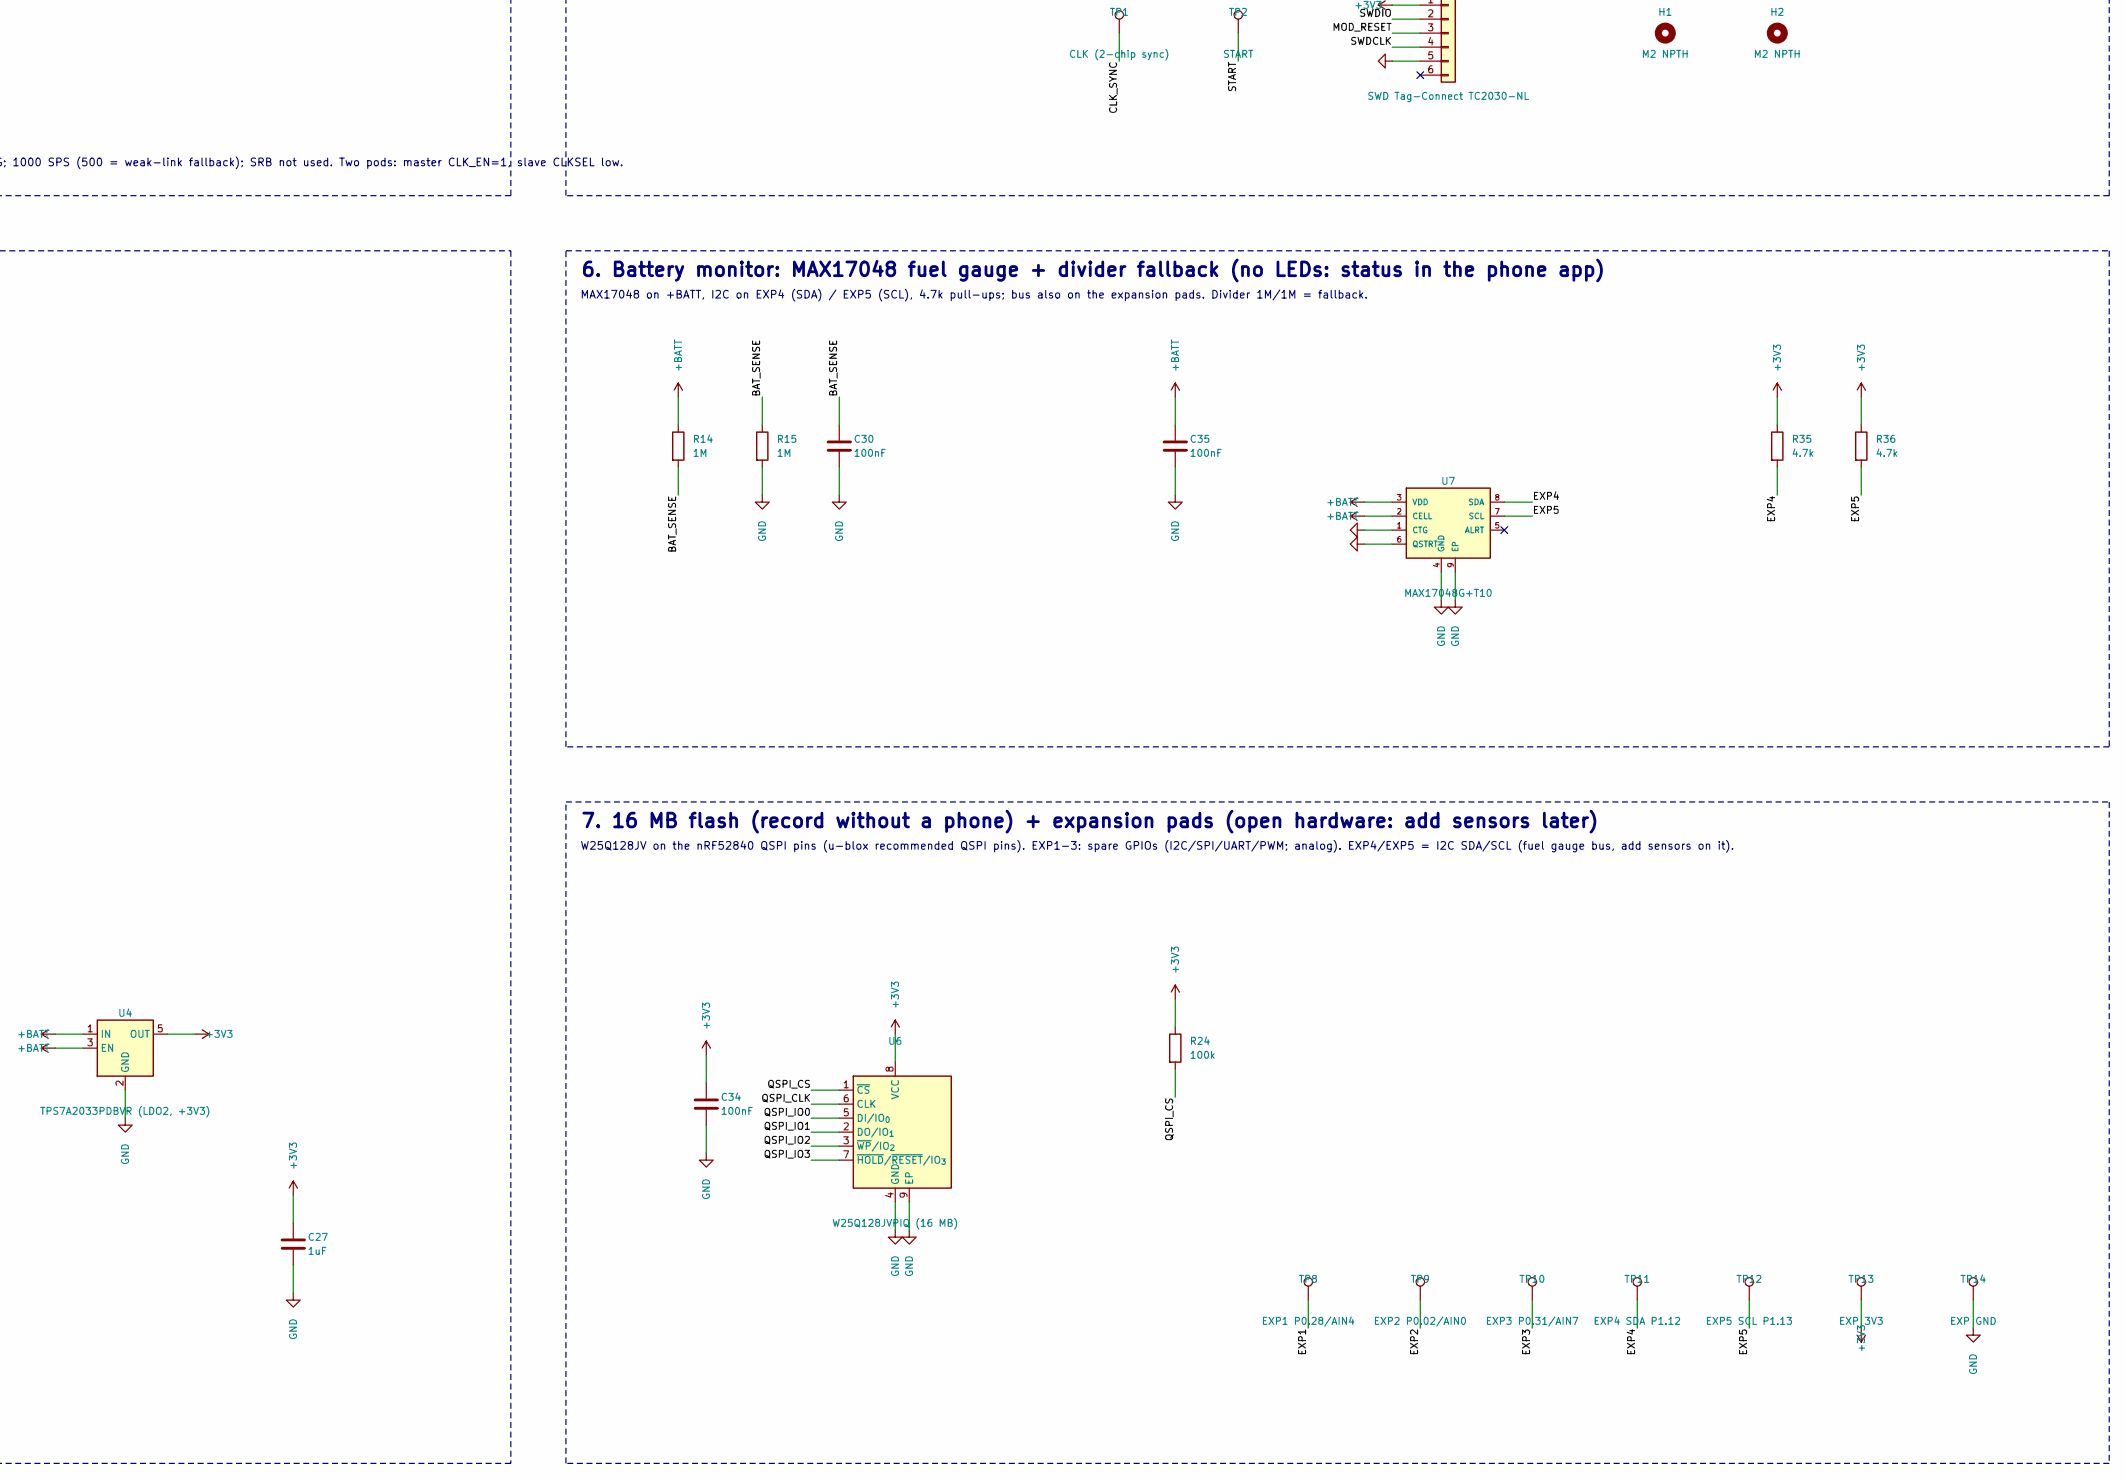
[picture p5: schematic pod.kicad_sch, ss-pod v1: ADS1298 + nRF52840 (NINA-B306) EMG pod, part in row 2, column 2]

Parts:
C1, C2, C3, C4, C5, C6, C7, C8, C9, C10, C33: 1nF; C_0402_1005Metric
C11: 10nF; C_0402_1005Metric
C12, C18, C20, C22, C30, C32, C34, C35: 100nF; C_0402_1005Metric
C13, C29: 10uF; C_0805_2012Metric
C14: 22uF; C_0805_2012Metric
C15, C16, C17, C19, C21, C23, C24, C25, C26, C27: 1uF; C_0402_1005Metric
D2, D3, D4: TPD4E1B06DCKR; SOT-363_SC-70-6
FB1, FB2, FB3, FB4, FB5, FB6, FB7, FB8, FB9, FB10: BLM15HD182SN1D; L_0402_1005Metric
H1, H2: M2 NPTH; M2_NPTH_clamp
J2: LiPo 1S protected; JST_SH_SM02B-SRSS-TB_1x02-1MP_P1.00mm_Horizontal
J3: SWD Tag-Connect TC2030-NL; Tag-Connect_TC2030-IDC-NL_2x03_P1.27mm_Vertical
P1: pogo E1; Harwin_P70-1000045R_pad2.2
P2: pogo E2; Harwin_P70-1000045R_pad2.2
P3: pogo E3; Harwin_P70-1000045R_pad2.2
P4: pogo E4; Harwin_P70-1000045R_pad2.2
P5: pogo E5; Harwin_P70-1000045R_pad2.2
P6: pogo E6; Harwin_P70-1000045R_pad2.2
P7: pogo E7; Harwin_P70-1000045R_pad2.2
P8: pogo E8; Harwin_P70-1000045R_pad2.2
P9: pogo REF_ELEC; Harwin_P70-1000045R_pad2.2
P10: pogo BIAS; Harwin_P70-1000045R_pad2.2
P11: pogo CLK_POGO; Harwin_P70-1000045R_pad2.2
P12: pogo GND; Harwin_P70-1000045R_pad2.2
Q2: AO3401A; SOT-23
R1, R2, R3, R4, R5, R6, R7, R8, R9: 2.2k; R_0402_1005Metric
R10: 392k; R_0402_1005Metric
R13, R20, R21, R22, R23, R24, R33: 100k; R_0402_1005Metric
R14, R15, R32: 1M; R_0402_1005Metric
R25: 10k; R_0402_1005Metric
R31: 100R; R_0402_1005Metric
R34: 0R DNP; R_0402_1005Metric; not fitted
R35, R36: 4.7k; R_0402_1005Metric
TP1: CLK (2-chip sync); TestPad_D0.8mm
TP2: START; TestPad_D0.8mm
TP8: EXP1 P0.28/AIN4; TestPad_D0.8mm
TP9: EXP2 P0.02/AIN0; TestPad_D0.8mm
TP10: EXP3 P0.31/AIN7; TestPad_D0.8mm
TP11: EXP4 SDA P1.12; TestPad_D0.8mm
TP12: EXP5 SCL P1.13; TestPad_D0.8mm
TP13: EXP 3V3; TestPad_D0.8mm
TP14: EXP GND; TestPad_D0.8mm
TP15: BATT+ cartridge contact; TabPad_D1.8mm
TP16: BATT- cartridge contact; TabPad_D1.8mm
U1: ADS1298IPAG; TQFP-64_10x10mm_P0.5mm
U2: NINA-B306-00B; u-blox_NINA-B306
U3: TPS7A2033PDBVR (LDO1, AVDD); SOT-23-5
U4: TPS7A2033PDBVR (LDO2, +3V3); SOT-23-5
U6: W25Q128JVPIQ (16 MB); WSON-8-1EP_6x5mm_P1.27mm_EP3.4x4.3mm
U7: MAX17048G+T10; TDFN-8-1EP_2x2mm_P0.5mm_EP0.8x1.2mm

Connections:
+3.3VA: C18.1, C19.1, C26.1, U1.17 (TESTP_PACE_OUT1), U1.18 (TESTP_PACE_OUT2), U1.19 (AVDD), U1.21 (AVDD), U1.22 (AVDD), U1.54 (AVDD1), U1.56 (AVDD), U1.59 (AVDD), U1.62 (RLDIN), U3.5 (OUT)
+3V3: C20.1, C21.1, C22.1, C23.1, C27.1, C34.1, J3.1, R13.1, R21.1, R23.1, R24.1, R33.1, R35.1, R36.1, TP13.1, U1.48 (DVDD), U1.50 (DVDD), U2.9 (VCC_IO), U2.10 (VCC), U4.5 (OUT), U6.8 (VCC)
+BATT: C24.1, C25.1, C29.1, C35.1, Q2.2 (S), R14.1, U3.1 (IN), U3.3 (EN), U4.1 (IN), U4.3 (EN), U7.2 (CELL), U7.3 (VDD)
/ADS_PWDN: R20.1, U1.35 (~PWDN), U2.7 (GPIO_7/P0.25)
/ADS_RESET: R23.2, U1.36 (~RESET), U2.5 (GPIO_5/P0.24)
/BAT_RAW: J2.1, Q2.3 (D), TP15.1
/BAT_SENSE: C30.1, R14.2, R15.1, U2.16 (GPIO_16/P0.03/AIN1)
/BIAS: D4.2 (IO2), FB10.1, P10.1
/BIAS_F: C10.1, FB10.2, R25.2
/CLKSEL: R33.2, U1.52 (CLKSEL), U2.23 (GPIO_23/P0.29)
/CLK_POGO: D4.4 (IO3), P11.1, R31.2
/CLK_SYNC: R31.1, R32.1, TP1.1, U1.37 (CLK)
/CS_N: R21.2, U1.39 (~CS), U2.3 (GPIO_3/P0.15)
/DRDY: U1.47 (~DRDY), U2.25 (GPIO_25/P0.04)
/E1: D2.1 (IO1), FB1.1, P1.1
/E1_F: FB1.2, R1.1
/E2: D2.2 (IO2), FB2.1, P2.1
/E2_F: FB2.2, R2.1
/E3: D2.4 (IO3), FB3.1, P3.1
/E3_F: FB3.2, R3.1
/E4: D2.5 (IO4), FB4.1, P4.1
/E4_F: FB4.2, R4.1
/E5: D3.1 (IO1), FB5.1, P5.1
/E5_F: FB5.2, R5.1
/E6: D3.2 (IO2), FB6.1, P6.1
/E6_F: FB6.2, R6.1
/E7: D3.4 (IO3), FB7.1, P7.1
/E7_F: FB7.2, R7.1
/E8: D3.5 (IO4), FB8.1, P8.1
/E8_F: FB8.2, R8.1
/EXP1: TP8.1, U2.17 (GPIO_17/P0.28)
/EXP2: TP9.1, U2.18 (GPIO_18/P0.02)
/EXP3: TP10.1, U2.20 (GPIO_20/P0.31)
/EXP4: R35.2, TP11.1, U2.21 (GPIO_21/P1.12), U7.8 (SDA)
/EXP5: R36.2, TP12.1, U2.22 (GPIO_22/P1.13), U7.7 (SCL)
/IN1P: C1.1, R1.2, U1.16 (IN1P)
/IN2P: C2.1, R2.2, U1.14 (IN2P)
/IN3P: C3.1, R3.2, U1.12 (IN3P)
/IN4P: C4.1, R4.2, U1.10 (IN4P)
/IN5P: C5.1, R5.2, U1.8 (IN5P)
/IN6P: C6.1, R6.2, U1.6 (IN6P)
/IN7P: C7.1, R7.2, U1.4 (IN7P)
/IN8P: C8.1, R8.2, U1.2 (IN8P)
/MISO: U1.43 (DOUT), U2.1 (GPIO_1/P0.13)
/MOD_RESET: J3.3, R13.2, U2.19 (RESET_N/P0.18)
/MOSI: U1.34 (DIN), U2.8 (SWO/P1.00)
/QSPI_CLK: U2.52 (GPIO_52/P0.19), U6.6 (CLK)
/QSPI_CS: R24.2, U2.51 (GPIO_51/P0.17), U6.1 (~CS)
/QSPI_IO0: U2.50 (GPIO_50/P0.20), U6.5 (DI/IO_{0})
/QSPI_IO1: U2.48 (GPIO_48/P0.21), U6.2 (DO/IO_{1})
/QSPI_IO2: U2.49 (GPIO_49/P0.22), U6.3 (~WP/IO_{2})
/QSPI_IO3: U2.47 (GPIO_47/P0.23), U6.7 (~HOLD/~RESET/IO_{3})
/REF: C9.1, R9.2, U1.1 (IN8N), U1.3 (IN7N), U1.5 (IN6N), U1.7 (IN5N), U1.9 (IN4N), U1.11 (IN3N), U1.13 (IN2N), U1.15 (IN1N)
/REF_ELEC: D4.1 (IO1), FB9.1, P9.1
/REF_F: FB9.2, R9.1
/RLDINV: C11.2, R10.2, U1.61 (RLDINV)
/RLDOUT: C11.1, R10.1, R25.1, U1.63 (RLDOUT)
/RLDREF: C32.1, U1.60 (RLDREF)
/SCLK: U1.40 (SCLK), U2.2 (GPIO_2/P0.14)
/START: R22.1, TP2.1, U1.38 (START), U2.4 (GPIO_4/P0.16)
/SWDCLK: J3.4, U2.11 (SWDCLK)
/SWDIO: J3.2, U2.15 (SWDIO)
/VBUS_MOD: R34.1, U2.31 (VBUS(5V in))
/VCAP1: C14.1, U1.28 (VCAP1)
/VCAP2: C15.1, U1.30 (VCAP2)
/VCAP3: C16.1, U1.55 (VCAP3)
/VCAP4: C17.1, U1.26 (VCAP4)
/VREFP: C12.1, C13.1, U1.24 (VREFP)
/WCT: C33.1, U1.64 (WCT)
GND: C1.2, C2.2, C3.2, C4.2, C5.2, C6.2, C7.2, C8.2, C9.2, C10.2, C12.2, C13.2, C14.2, C15.2, C16.2, C17.2, C18.2, C19.2, C20.2, C21.2, C22.2, C23.2, C24.2, C25.2, C26.2, C27.2, C29.2, C30.2, C32.2, C33.2, C34.2, C35.2, D2.3 (GND), D3.3 (GND), D4.3 (GND), J2.2, J3.5, P12.1, Q2.1 (G), R15.2, R20.2, R22.2, R32.2, R34.2, TP14.1, TP16.1, U1.20 (AVSS), U1.23 (AVSS), U1.25 (VREFN), U1.31 (RESV1), U1.32 (AVSS), U1.33 (DGND), U1.41 (DAISY_IN), U1.42 (GPIO1), U1.44 (GPIO2), U1.45 (GPIO3), U1.46 (GPIO4), U1.49 (DGND), U1.51 (DGND), U1.53 (AVSS1), U1.57 (AVSS), U1.58 (AVSS), U2.6 (GND), U2.12 (GND), U2.14 (GND), U2.26 (GND), U2.30 (GND), U2.53 (GND), U2.56 (EGP), U2.57 (EAGP), U3.2 (GND), U4.2 (GND), U6.4 (GND), U6.9 (EP), U7.1 (CTG), U7.4 (GND), U7.6 (QSTRT), U7.9 (EP)

Notes on the sheet:
1. Electrode pogo pins + input protection
Pogo pins P1-P12 (top side, gold) -> ESD array (electrode side) -> ferrite bead -> 2.2k series -> 1nF to GND -> ADS1298. RC: OpenBCI Cyton; bead: MobilECG-II.
REF electrode feeds all eight INxN (referential montage). BIAS pad <- bead <- 10k R25 <- RLDOUT (MobilECG-II: 10k).
FB1-FB10: Murata BLM15HD182SN1D (0402, GHz-band bead). P11 CLK_POGO <- 100R R31 <- ADS CLK; ESD on D4 IO3.
2. ADS1298 analog front end + 3. bias drive (RLD)
Unipolar: AVDD 3.3V from LDO1 only, DVDD 3.3V from LDO2. Caps per TI SBAS459K Figure 106, placed at the package.
Firmware: CONFIG3 RLDREF_INT=1, PD_RLD=1; gain x6 or lower for EMG; 1000 SPS (500 = weak-link fallback); SRB not used. Two pods: master CLK_EN=1, slave CLKSEL low.
4. Radio: u-blox NINA-B306-00B (nRF52840, internal antenna, 32.768 kHz crystal inside)
ADS link on the outer left pin column (pins 1-5, 7, 8) + pin 25: none near the radio (UBX-17052099). EXP1-5 ARE near the radio: < 10 kHz only.
5. Power: battery cartridge, reverse-polarity FET, two LDOs
Rev 0.7: no charger on the pod. Cells are charged in the cartridge on the dock (hw/dock).
6. Battery monitor: MAX17048 fuel gauge + divider fallback (no LEDs: status in the phone app)
MAX17048 on +BATT, I2C on EXP4 (SDA) / EXP5 (SCL), 4.7k pull-ups; bus also on the expansion pads. Divider 1M/1M = fallback.
7. 16 MB flash (record without a phone) + expansion pads (open hardware: add sensors later)
W25Q128JV on the nRF52840 QSPI pins (u-blox recommended QSPI pins). EXP1-3: spare GPIOs (I2C/SPI/UART/PWM; analog). EXP4/EXP5 = I2C SDA/SCL (fuel gauge bus, add sensors on it).

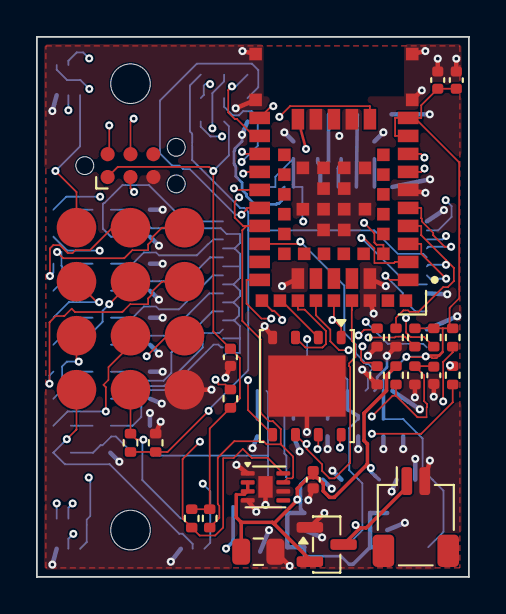
[picture p6: board pod.kicad_pcb from above]

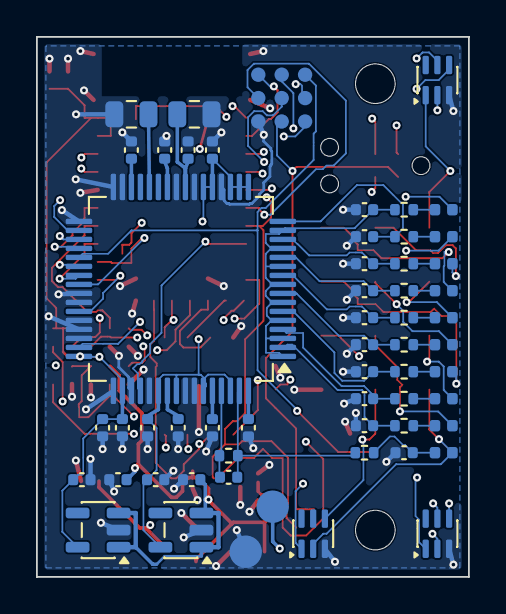
[picture p7: board pod.kicad_pcb from below]

Board: 6 copper layers, 24.0 x 30.0 mm, 105 parts (65 on the bottom side), 70 nets.
