rkrafted/silent-speech/hw/revisions/2026-10-16-676691bc/tab_charger/tab_charger.kicad_pcb

## KiCad design hw/revisions/2026-10-16-676691bc/tab_charger/tab_charger.kicad_pcb (2026-10-31)

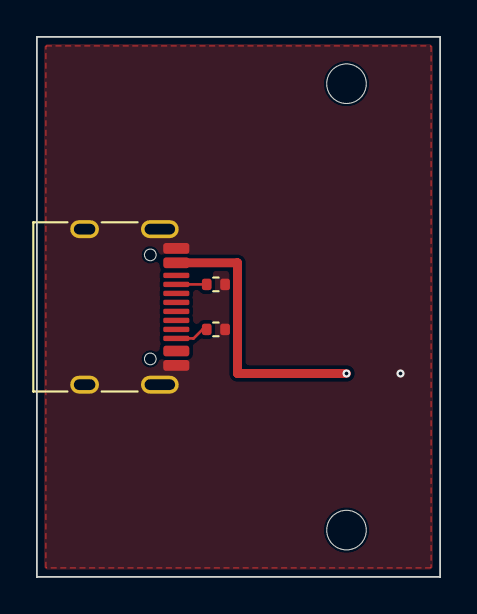
[picture p8: board tab_charger.kicad_pcb from above]

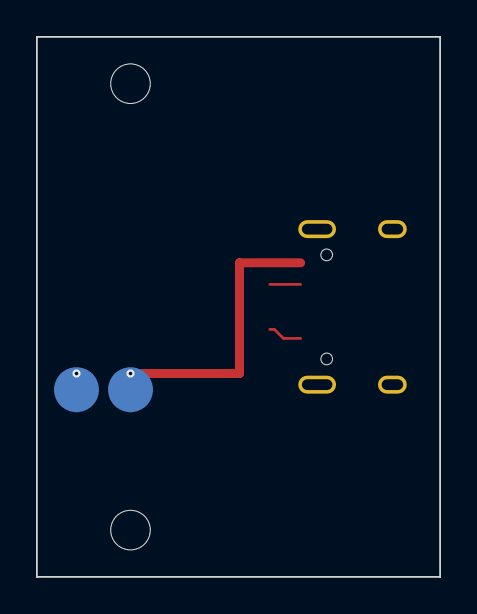
[picture p9: board tab_charger.kicad_pcb from below]

Board: 2 copper layers, 22.4 x 30.0 mm, 7 parts (2 on the bottom side), 5 nets.

Parts:
H1, H2: M2_NPTH_clamp
J1: TYPE-C-31-M-12; USB_C_Receptacle_HRO_TYPE-C-31-M-12
P11, P12: TabPad_D2.5mm
R1, R2: 5.1k; R_0402_1005Metric

Connections:
CC1: J1.A5, R1.1
CC2: J1.B5, R2.1
GND: J1.A1, J1.A12, J1.B1, J1.B12, J1.SH, P12.1, R1.2, R2.2
VBUS: J1.A4, J1.B9, P11.1
VBUS_B: J1.A9, J1.B4
