rkrafted/silent-speech/hw/revisions/2026-10-16-676691bc/cartridge/cartridge.kicad_pcb

## KiCad design hw/revisions/2026-10-16-676691bc/cartridge/cartridge.kicad_pcb (2026-10-31)

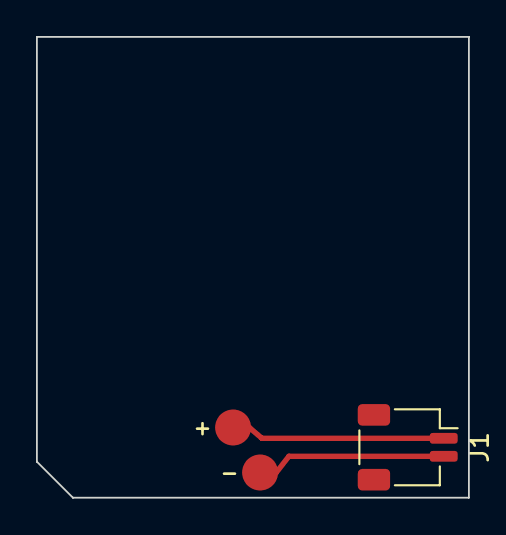
[picture p10: board cartridge.kicad_pcb from above]

Board: 2 copper layers, 24.0 x 25.6 mm, 3 parts (0 on the bottom side), 2 nets.

Parts:
J1: cell plug (JST SH, pin 1 = +); JST_SH_SM02B-SRSS-TB_1x02-1MP_P1.00mm_Horizontal
P1: pogo 5.5mm BATT+; Pogo_SMD_tall_pad2.0
P2: pogo 5.5mm BATT-; Pogo_SMD_tall_pad2.0

Connections:
BATT+: J1.1, P1.1
BATT-: J1.2, P2.1
