rkrafted/silent-speech/hw/revisions/2026-10-16-676691bc/tab_electrode/tab_electrode.kicad_pcb

## KiCad design hw/revisions/2026-10-16-676691bc/tab_electrode/tab_electrode.kicad_pcb (2026-10-31)

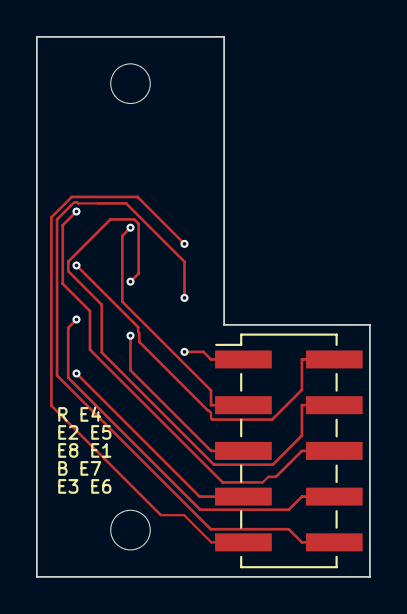
[picture p13: board hw/revisions/2026-10-16-676691bc/tab_electrode/tab_electrode.kicad_pcb from above]

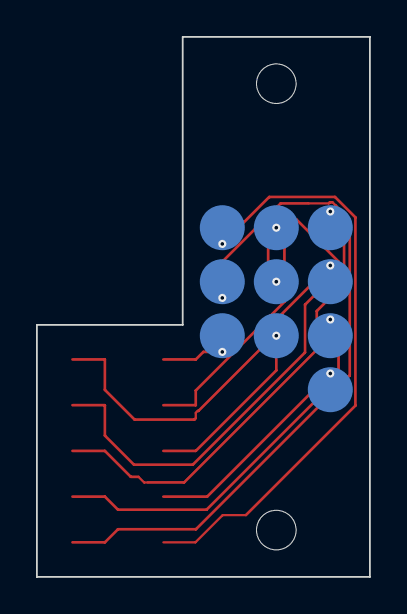
[picture p14: board hw/revisions/2026-10-16-676691bc/tab_electrode/tab_electrode.kicad_pcb from below]

Board: 2 copper layers, 18.5 x 30.0 mm, 13 parts (10 on the bottom side), 10 nets.

Parts:
H1, H2: M2_NPTH_clamp
J1: 2x5 2.54 SMD vertical; PinHeader_2x05_P2.54mm_Vertical_SMD
P1, P2, P3, P4, P5, P6, P7, P8, P9, P10: TabPad_D2.5mm

Connections:
BIAS: J1.7, P10.1
E1: J1.6, P1.1
E2: J1.3, P2.1
E3: J1.9, P3.1
E4: J1.2, P4.1
E5: J1.4, P5.1
E6: J1.10, P6.1
E7: J1.8, P7.1
E8: J1.5, P8.1
REF: J1.1, P9.1
