rkrafted/silent-speech/hw/dock/dock.kicad_pcb

## KiCad design hw/dock/dock.kicad_pcb (2026-10-31)

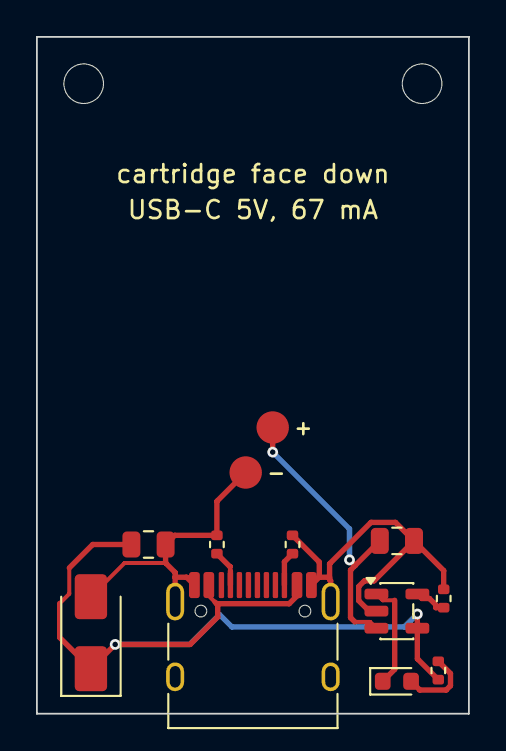
[picture p15: board dock.kicad_pcb from above]

Board: 2 copper layers, 24.0 x 37.6 mm, 14 parts (0 on the bottom side), 8 nets.

Parts:
C1, C2: 10uF 25V; C_0805_2012Metric
D1: SMAJ5.0A; D_SMA
D2: LED red (charging); LED_0603_1608Metric
H1, H2: M2_NPTH_clamp
J1: TYPE-C-31-M-12; USB_C_Receptacle_HRO_TYPE-C-31-M-12
R1, R2: 5.1k; R_0402_1005Metric
R3: 15k; R_0402_1005Metric
R4: 1k; R_0402_1005Metric
TP1: BATT+ contact; TabPad_D1.8mm
TP2: BATT- contact; TabPad_D1.8mm
U1: MCP73831T-2ACI/OT; SOT-23-5

Connections:
CC1: J1.A5, R1.1
CC2: J1.B5, R2.1
GND: C1.2, C2.2, D1.2, J1.A1, J1.A12, J1.B1, J1.B12, J1.SH, R1.2, R2.2, R3.2, TP2.1, U1.2
LED_A: D2.2, R4.2
PROG: R3.1, U1.5
STAT: D2.1, U1.1
VBAT: C2.1, TP1.1, U1.3
VBUS: C1.1, D1.1, J1.A4, J1.A9, J1.B4, J1.B9, R4.1, U1.4
