rkrafted/silent-speech/hw/revisions/2026-10-07-7efeed88/pod/pod.kicad_sch

## KiCad design hw/revisions/2026-10-07-7efeed88/pod/pod.kicad_sch (2026-10-31)

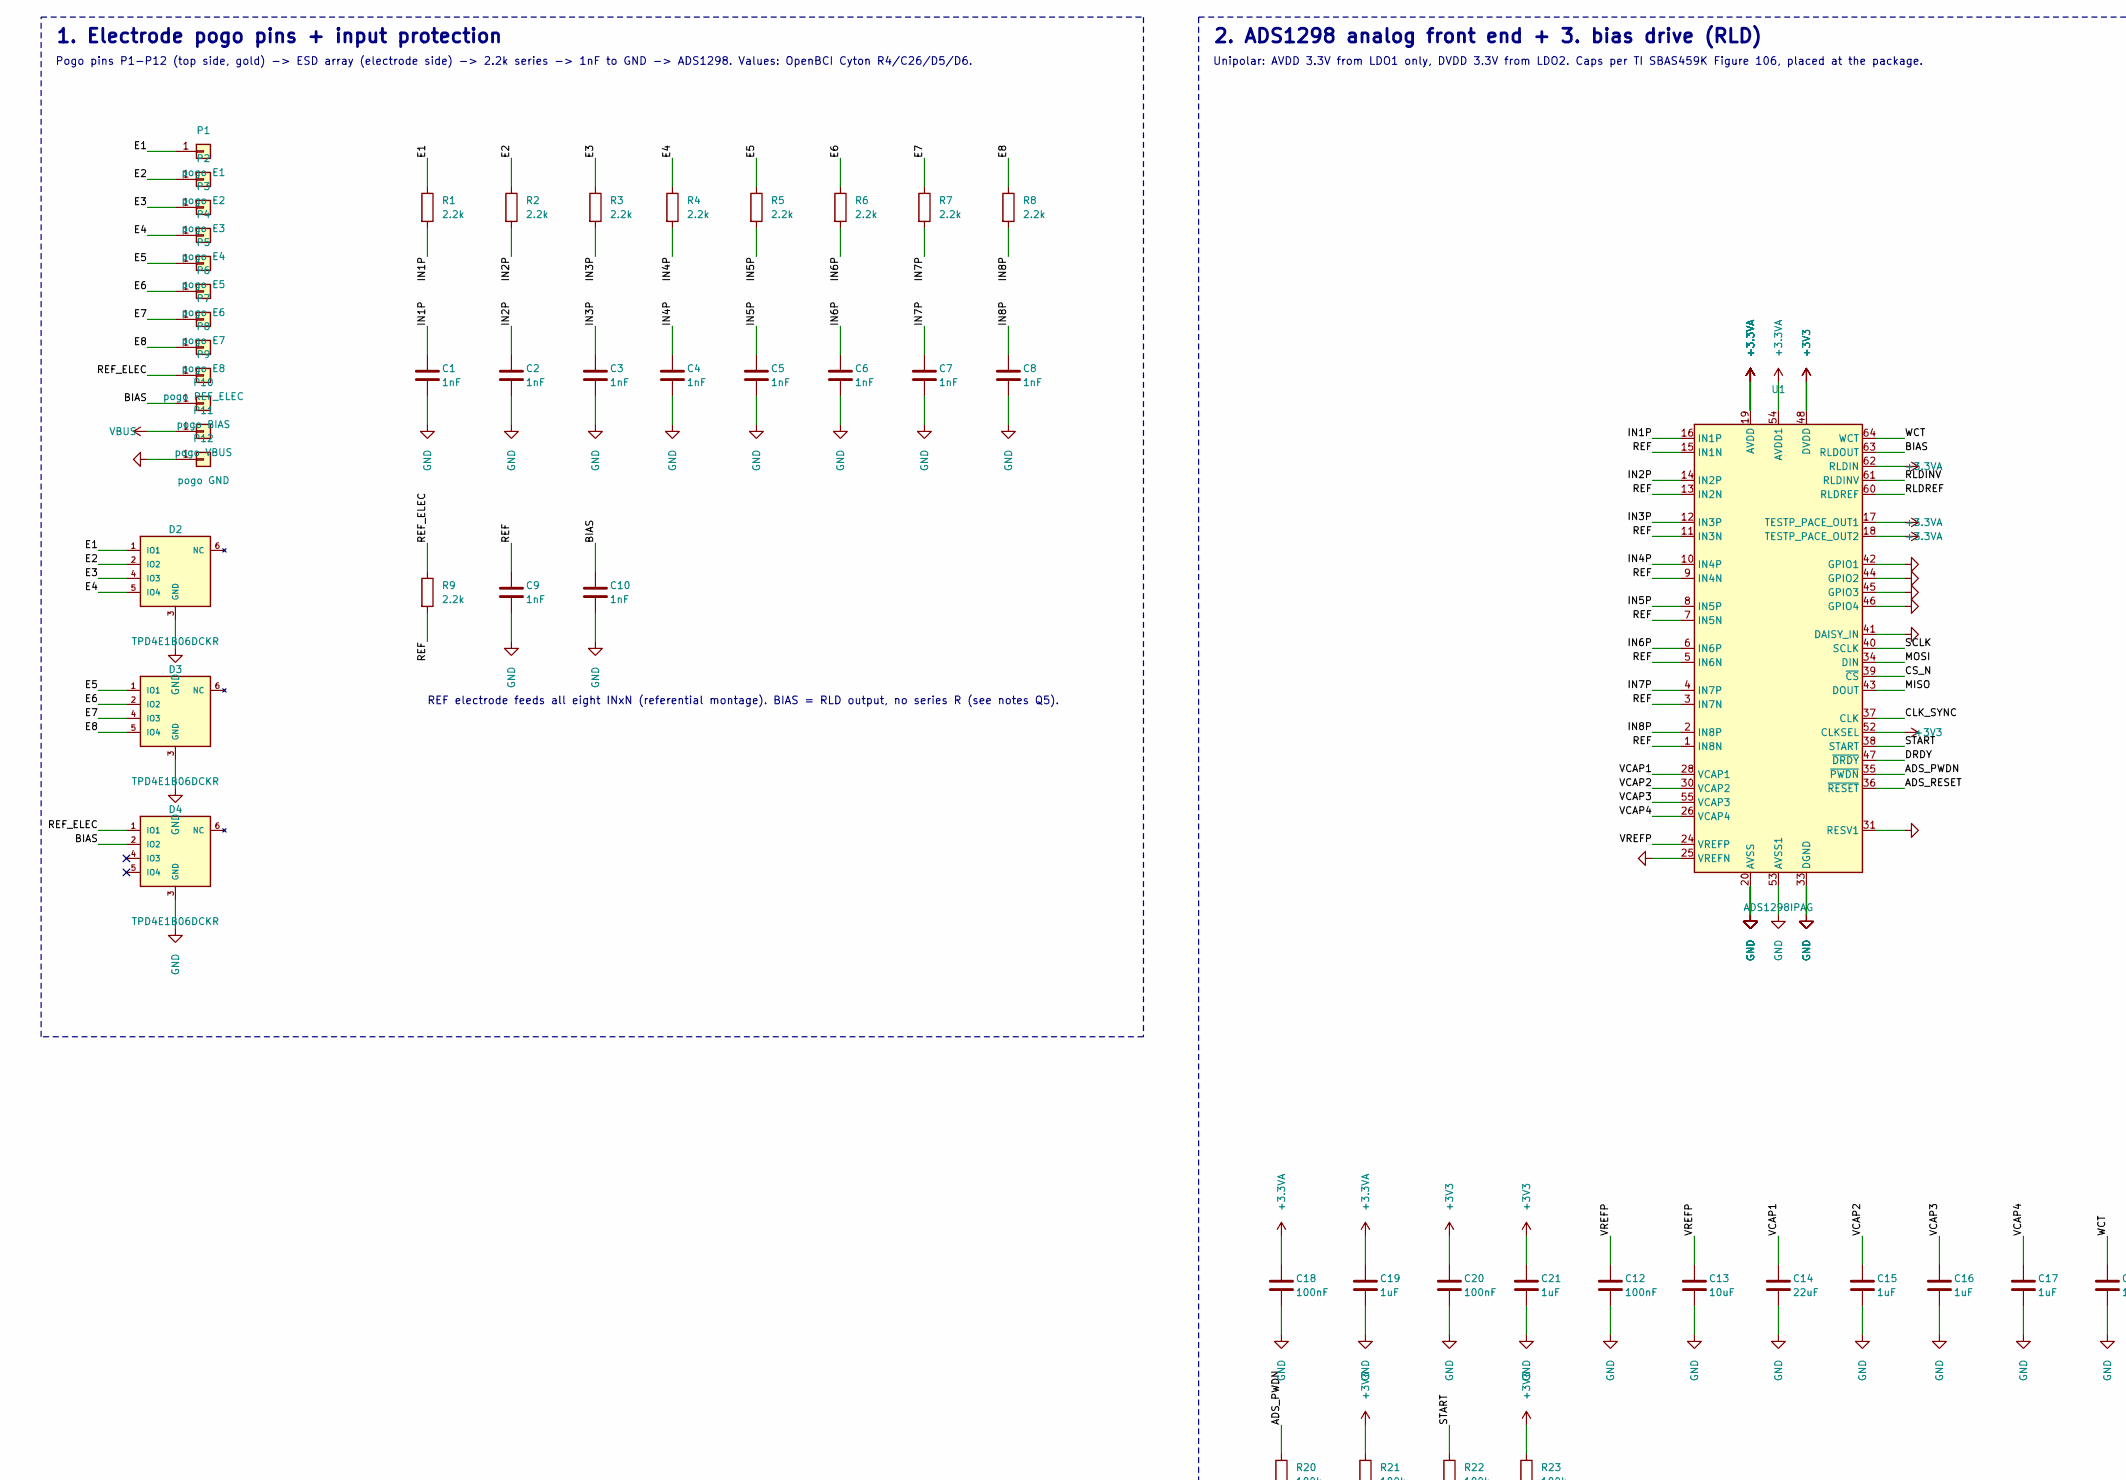
[picture p16: schematic pod.kicad_sch, part in row 1, column 1]

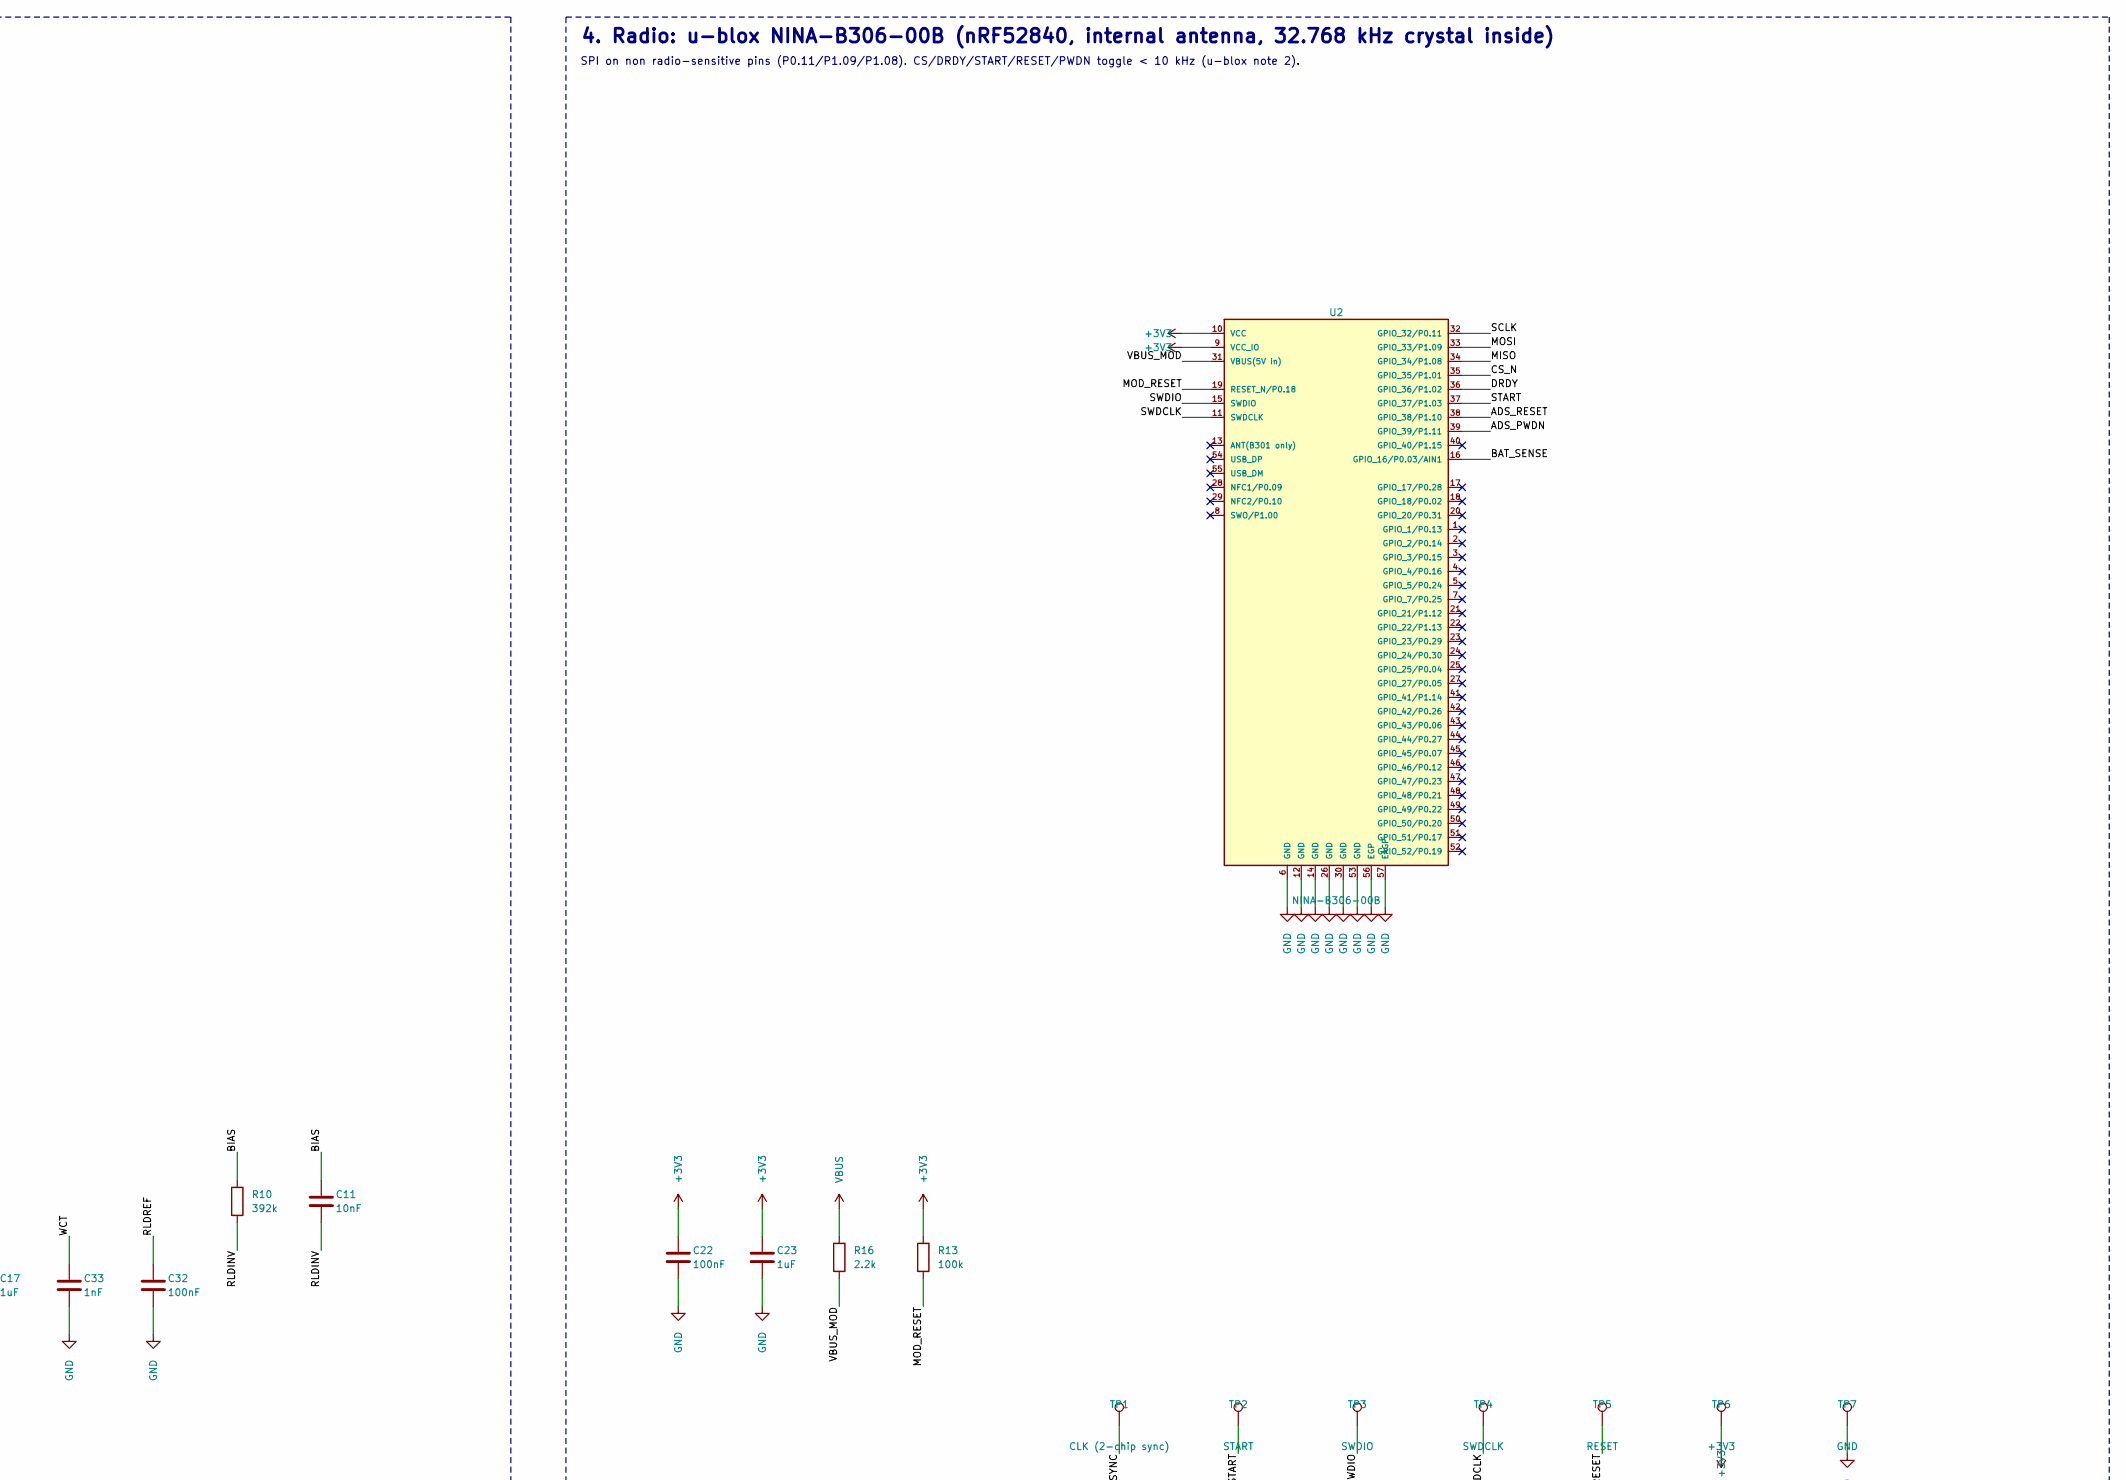
[picture p17: schematic pod.kicad_sch, part in row 1, column 2]

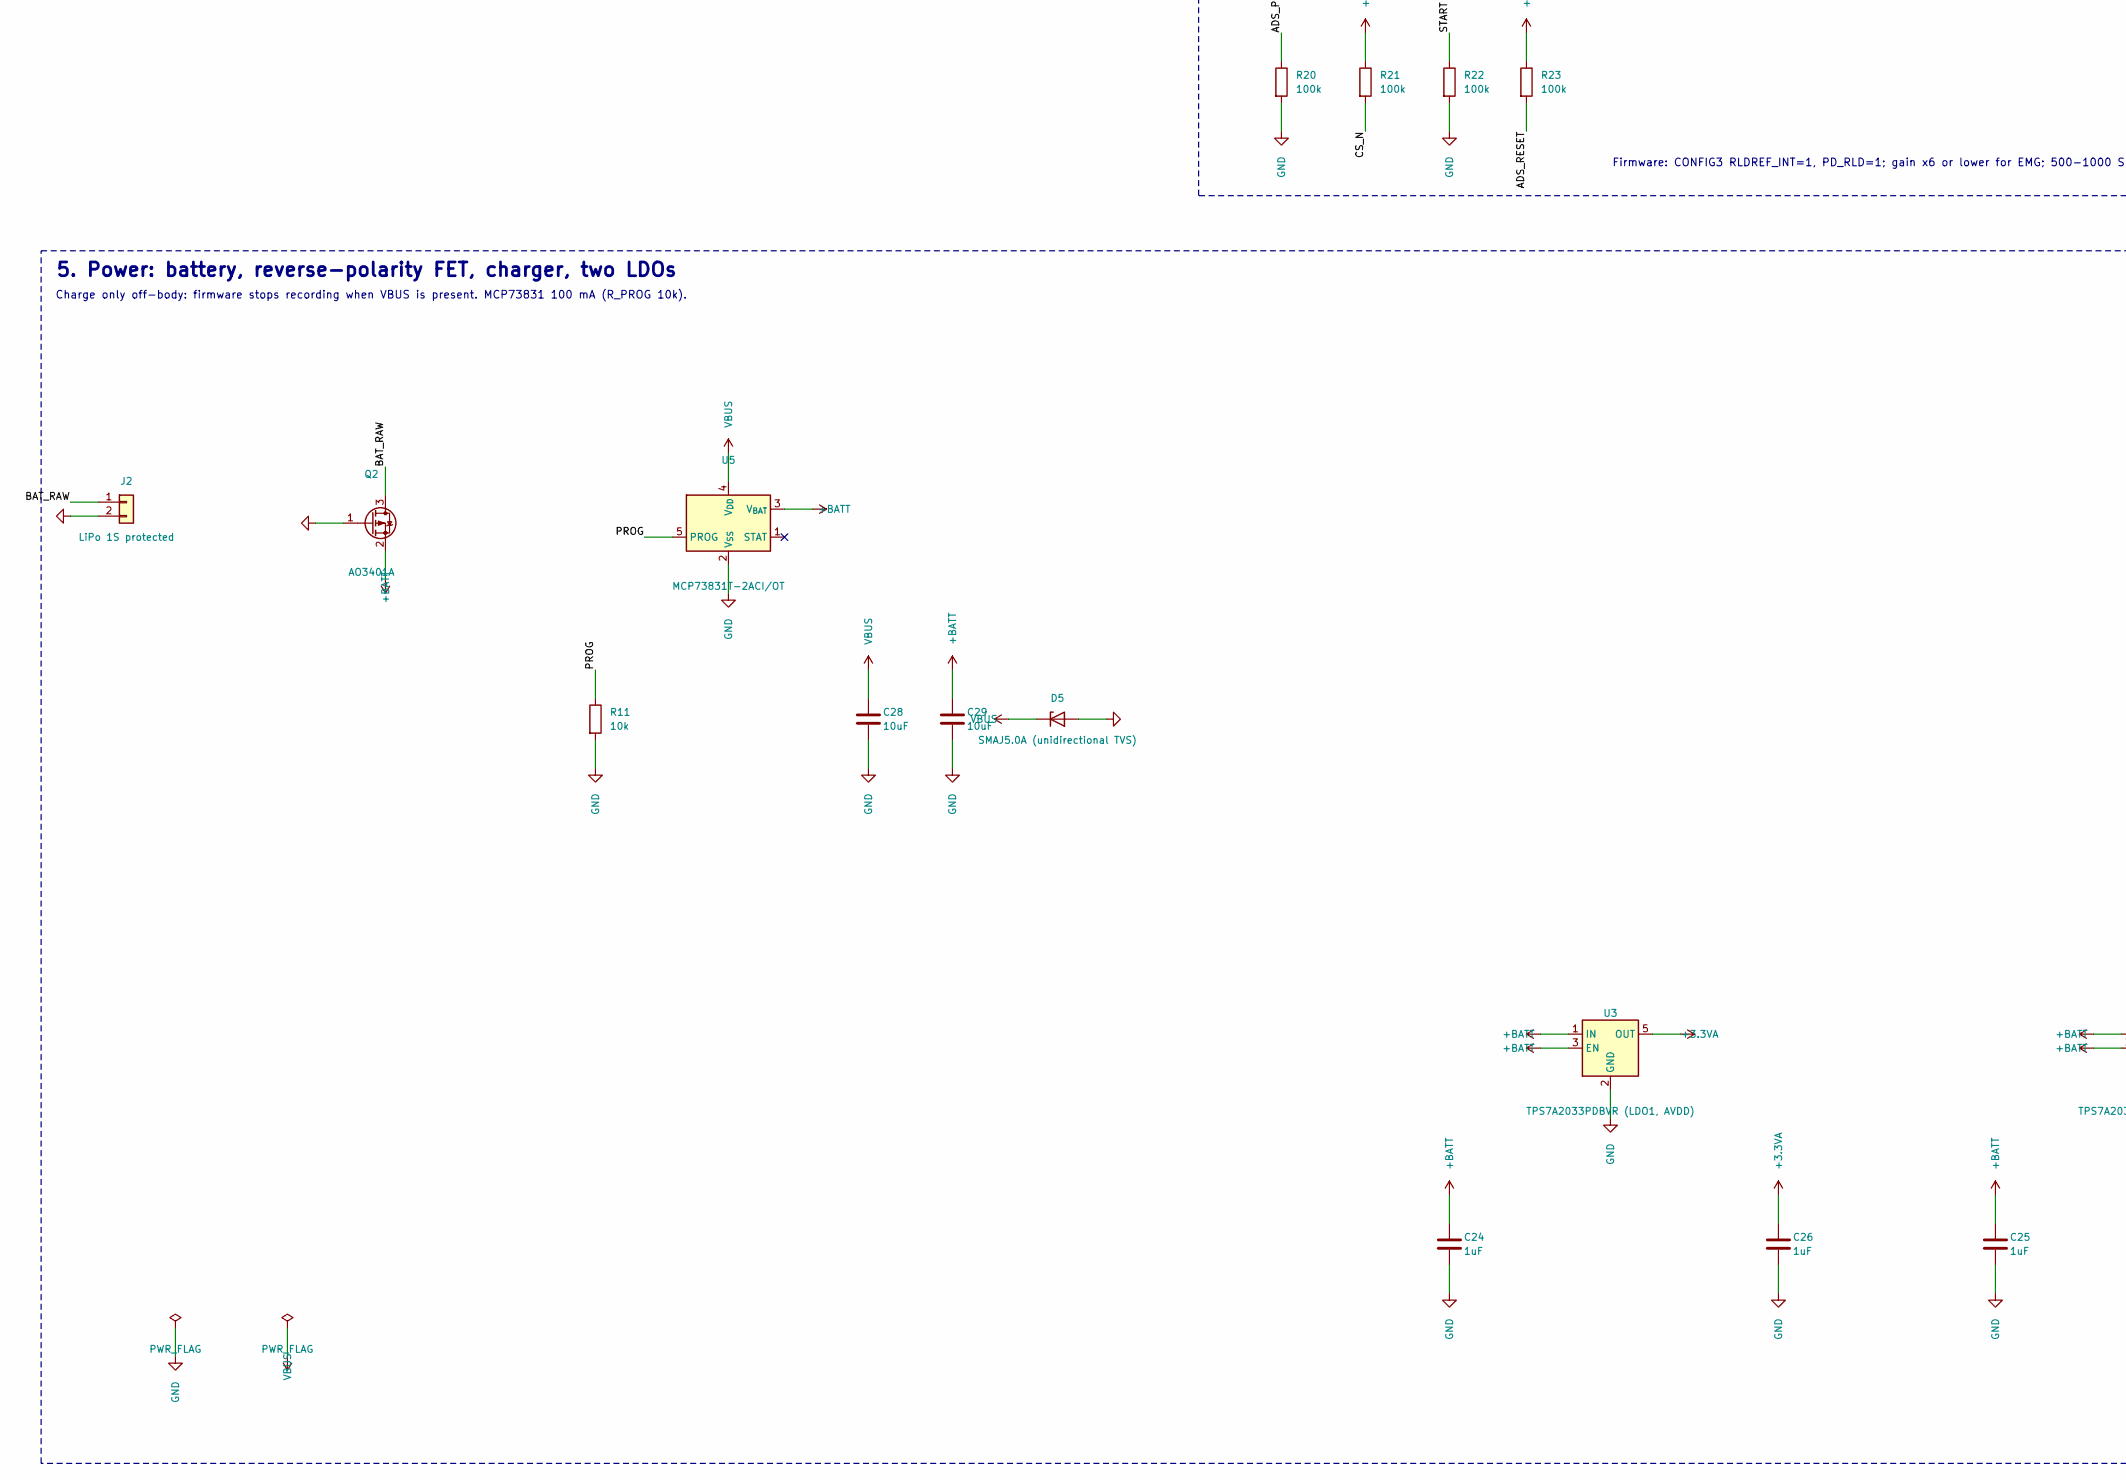
[picture p18: schematic pod.kicad_sch, part in row 2, column 1]

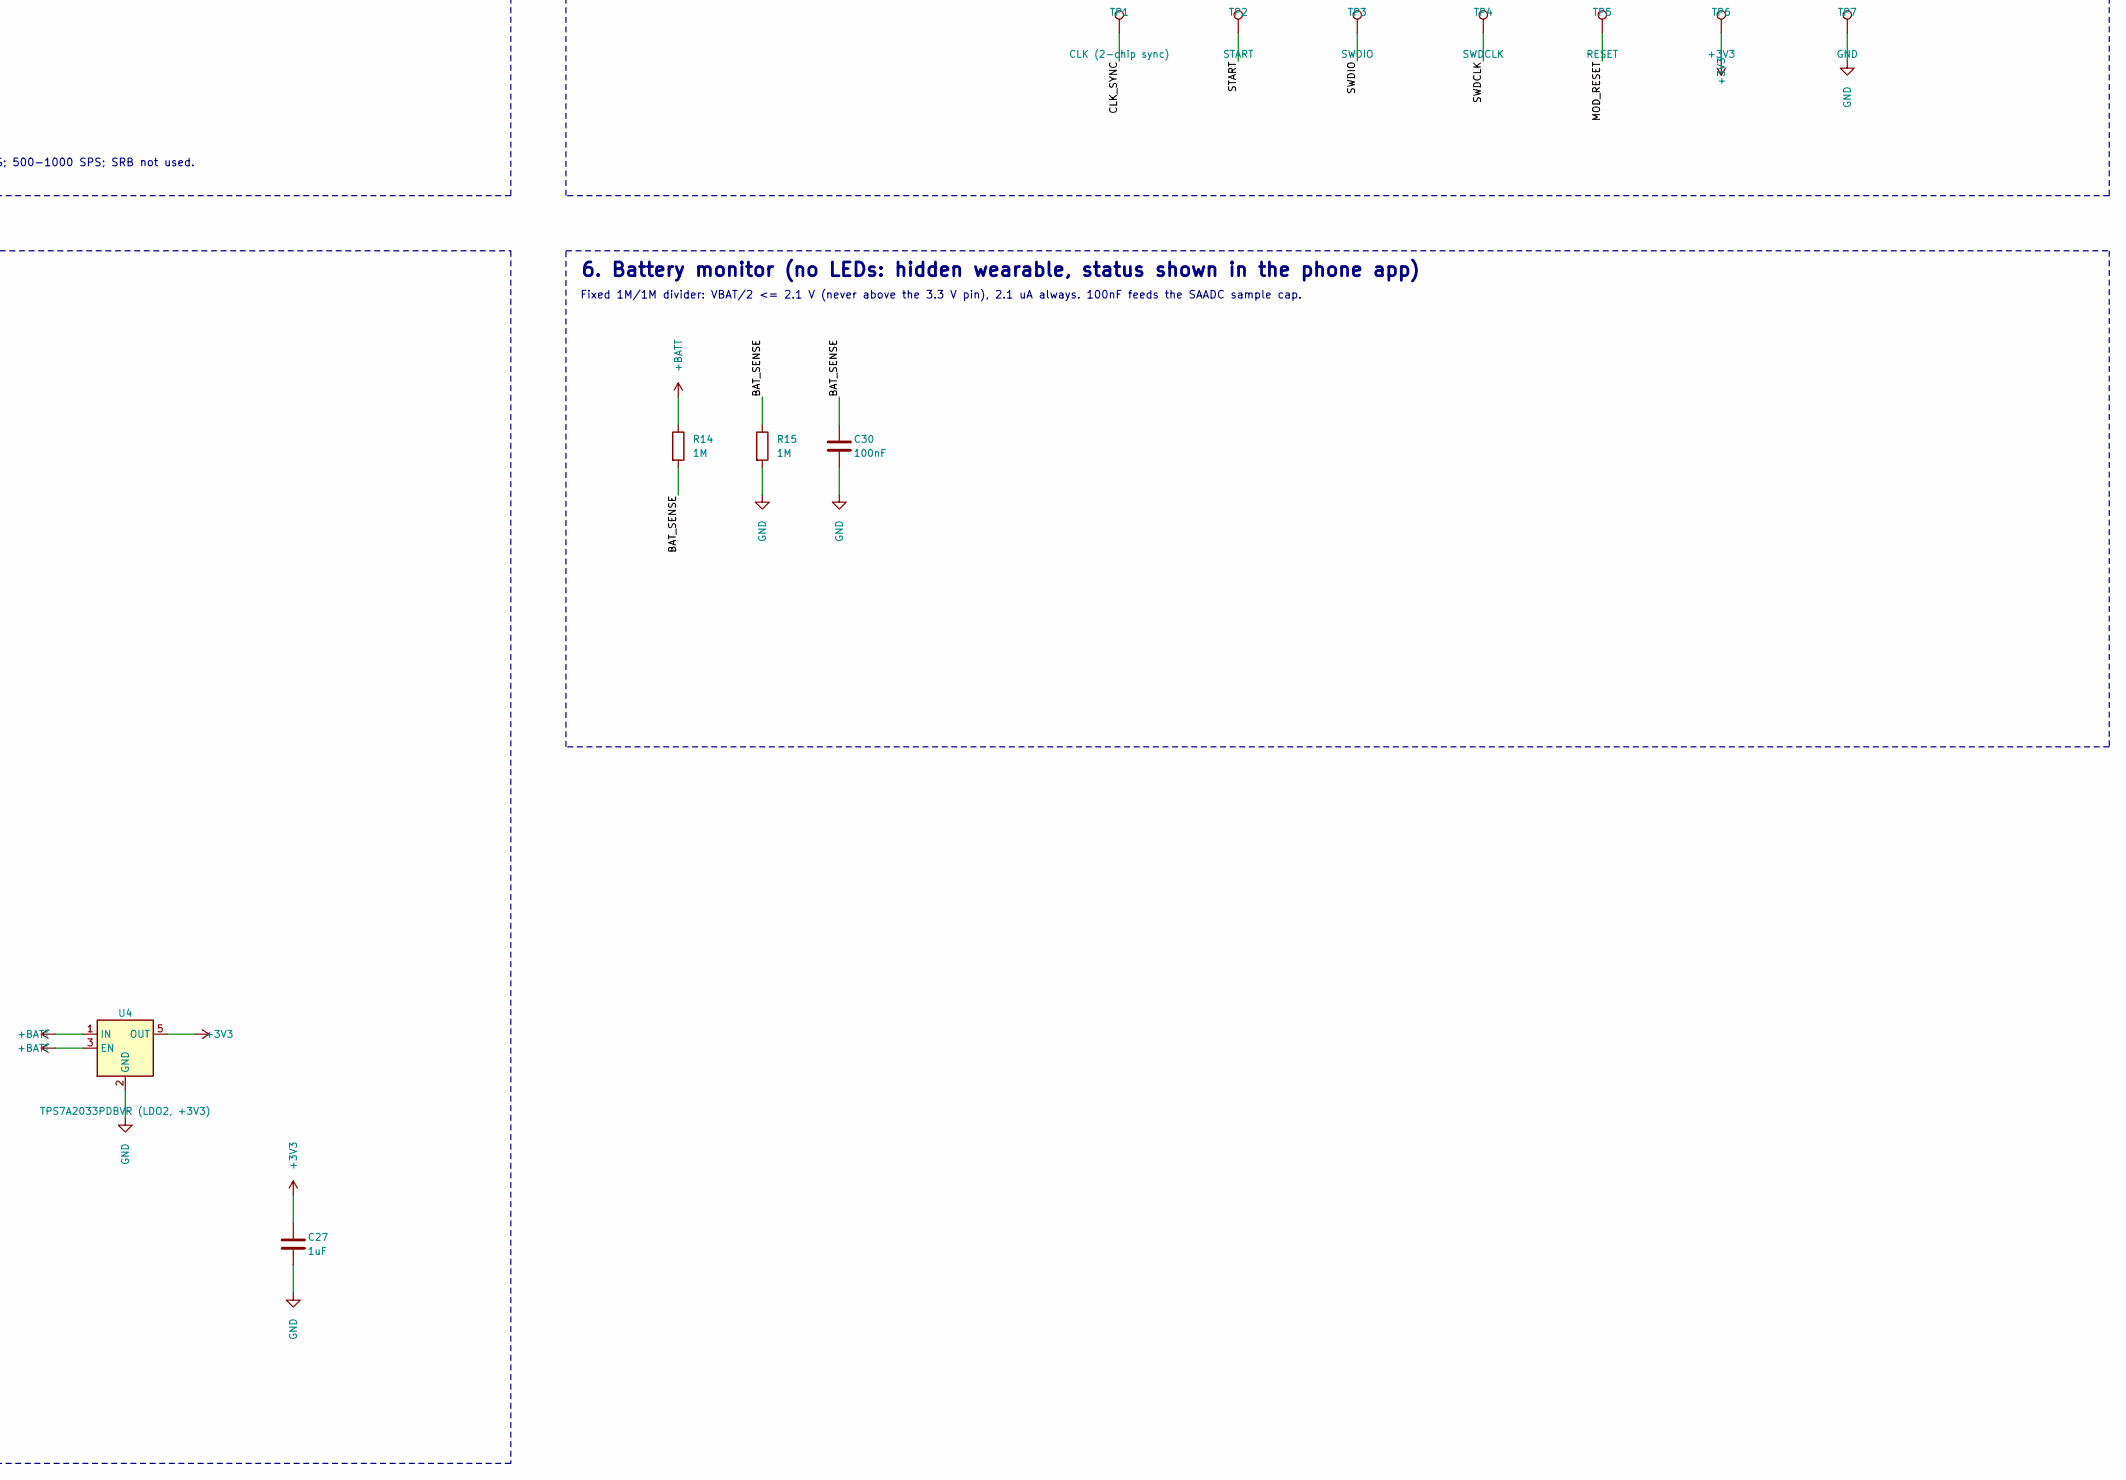
[picture p19: schematic pod.kicad_sch, part in row 2, column 2]

Parts:
C1, C2, C3, C4, C5, C6, C7, C8, C9, C10, C33: 1nF; C_0402_1005Metric
C11: 10nF; C_0402_1005Metric
C12, C18, C20, C22, C30, C32: 100nF; C_0402_1005Metric
C13, C28, C29: 10uF; C_0805_2012Metric
C14: 22uF; C_0805_2012Metric
C15, C16, C17, C19, C21, C23, C24, C25, C26, C27: 1uF; C_0402_1005Metric
D2, D3, D4: TPD4E1B06DCKR; SOT-363_SC-70-6
D5: SMAJ5.0A (unidirectional TVS); D_SMA
J2: LiPo 1S protected; JST_SH_SM02B-SRSS-TB_1x02-1MP_P1.00mm_Horizontal
P1: pogo E1; Harwin_P70-1000045R_pad2.2
P2: pogo E2; Harwin_P70-1000045R_pad2.2
P3: pogo E3; Harwin_P70-1000045R_pad2.2
P4: pogo E4; Harwin_P70-1000045R_pad2.2
P5: pogo E5; Harwin_P70-1000045R_pad2.2
P6: pogo E6; Harwin_P70-1000045R_pad2.2
P7: pogo E7; Harwin_P70-1000045R_pad2.2
P8: pogo E8; Harwin_P70-1000045R_pad2.2
P9: pogo REF_ELEC; Harwin_P70-1000045R_pad2.2
P10: pogo BIAS; Harwin_P70-1000045R_pad2.2
P11: pogo VBUS; Harwin_P70-1000045R_pad2.2
P12: pogo GND; Harwin_P70-1000045R_pad2.2
Q2: AO3401A; SOT-23
R1, R2, R3, R4, R5, R6, R7, R8, R9, R16: 2.2k; R_0402_1005Metric
R10: 392k; R_0402_1005Metric
R11: 10k; R_0402_1005Metric
R13, R20, R21, R22, R23: 100k; R_0402_1005Metric
R14, R15: 1M; R_0402_1005Metric
TP1: CLK (2-chip sync); TestPoint_Pad_D1.0mm
TP2: START; TestPoint_Pad_D1.0mm
TP3: SWDIO; TestPoint_Pad_D1.0mm
TP4: SWDCLK; TestPoint_Pad_D1.0mm
TP5: RESET; TestPoint_Pad_D1.0mm
TP6: +3V3; TestPoint_Pad_D1.0mm
TP7: GND; TestPoint_Pad_D1.0mm
U1: ADS1298IPAG; TQFP-64_10x10mm_P0.5mm
U2: NINA-B306-00B; u-blox_NINA-B306
U3: TPS7A2033PDBVR (LDO1, AVDD); SOT-23-5
U4: TPS7A2033PDBVR (LDO2, +3V3); SOT-23-5
U5: MCP73831T-2ACI/OT; SOT-23-5

Connections:
+3.3VA: C18.1, C19.1, C26.1, U1.17 (TESTP_PACE_OUT1), U1.18 (TESTP_PACE_OUT2), U1.19 (AVDD), U1.21 (AVDD), U1.22 (AVDD), U1.54 (AVDD1), U1.56 (AVDD), U1.59 (AVDD), U1.62 (RLDIN), U3.5 (OUT)
+3V3: C20.1, C21.1, C22.1, C23.1, C27.1, R13.1, R21.1, R23.1, TP6.1, U1.48 (DVDD), U1.50 (DVDD), U1.52 (CLKSEL), U2.9 (VCC_IO), U2.10 (VCC), U4.5 (OUT)
+BATT: C24.1, C25.1, C29.1, Q2.2 (S), R14.1, U3.1 (IN), U3.3 (EN), U4.1 (IN), U4.3 (EN), U5.3 (V_{BAT})
ADS_PWDN: R20.1, U1.35 (~PWDN), U2.39 (GPIO_39/P1.11)
ADS_RESET: R23.2, U1.36 (~RESET), U2.38 (GPIO_38/P1.10)
BAT_RAW: J2.1, Q2.3 (D)
BAT_SENSE: C30.1, R14.2, R15.1, U2.16 (GPIO_16/P0.03/AIN1)
BIAS: C10.1, C11.1, D4.2 (IO2), P10.1, R10.1, U1.63 (RLDOUT)
CLK_SYNC: TP1.1, U1.37 (CLK)
CS_N: R21.2, U1.39 (~CS), U2.35 (GPIO_35/P1.01)
DRDY: U1.47 (~DRDY), U2.36 (GPIO_36/P1.02)
E1: D2.1 (IO1), P1.1, R1.1
E2: D2.2 (IO2), P2.1, R2.1
E3: D2.4 (IO3), P3.1, R3.1
E4: D2.5 (IO4), P4.1, R4.1
E5: D3.1 (IO1), P5.1, R5.1
E6: D3.2 (IO2), P6.1, R6.1
E7: D3.4 (IO3), P7.1, R7.1
E8: D3.5 (IO4), P8.1, R8.1
GND: C1.2, C2.2, C3.2, C4.2, C5.2, C6.2, C7.2, C8.2, C9.2, C10.2, C12.2, C13.2, C14.2, C15.2, C16.2, C17.2, C18.2, C19.2, C20.2, C21.2, C22.2, C23.2, C24.2, C25.2, C26.2, C27.2, C28.2, C29.2, C30.2, C32.2, C33.2, D2.3 (GND), D3.3 (GND), D4.3 (GND), D5.2 (A), J2.2, P12.1, Q2.1 (G), R11.2, R15.2, R20.2, R22.2, TP7.1, U1.20 (AVSS), U1.23 (AVSS), U1.25 (VREFN), U1.31 (RESV1), U1.32 (AVSS), U1.33 (DGND), U1.41 (DAISY_IN), U1.42 (GPIO1), U1.44 (GPIO2), U1.45 (GPIO3), U1.46 (GPIO4), U1.49 (DGND), U1.51 (DGND), U1.53 (AVSS1), U1.57 (AVSS), U1.58 (AVSS), U2.6 (GND), U2.12 (GND), U2.14 (GND), U2.26 (GND), U2.30 (GND), U2.53 (GND), U2.56 (EGP), U2.57 (EAGP), U3.2 (GND), U4.2 (GND), U5.2 (V_{SS})
IN1P: C1.1, R1.2, U1.16 (IN1P)
IN2P: C2.1, R2.2, U1.14 (IN2P)
IN3P: C3.1, R3.2, U1.12 (IN3P)
IN4P: C4.1, R4.2, U1.10 (IN4P)
IN5P: C5.1, R5.2, U1.8 (IN5P)
IN6P: C6.1, R6.2, U1.6 (IN6P)
IN7P: C7.1, R7.2, U1.4 (IN7P)
IN8P: C8.1, R8.2, U1.2 (IN8P)
MISO: U1.43 (DOUT), U2.34 (GPIO_34/P1.08)
MOD_RESET: R13.2, TP5.1, U2.19 (RESET_N/P0.18)
MOSI: U1.34 (DIN), U2.33 (GPIO_33/P1.09)
PROG: R11.1, U5.5 (PROG)
REF: C9.1, R9.2, U1.1 (IN8N), U1.3 (IN7N), U1.5 (IN6N), U1.7 (IN5N), U1.9 (IN4N), U1.11 (IN3N), U1.13 (IN2N), U1.15 (IN1N)
REF_ELEC: D4.1 (IO1), P9.1, R9.1
RLDINV: C11.2, R10.2, U1.61 (RLDINV)
RLDREF: C32.1, U1.60 (RLDREF)
SCLK: U1.40 (SCLK), U2.32 (GPIO_32/P0.11)
START: R22.1, TP2.1, U1.38 (START), U2.37 (GPIO_37/P1.03)
SWDCLK: TP4.1, U2.11 (SWDCLK)
SWDIO: TP3.1, U2.15 (SWDIO)
VBUS: C28.1, D5.1 (K), P11.1, R16.1, U5.4 (V_{DD})
VBUS_MOD: R16.2, U2.31 (VBUS(5V in))
VCAP1: C14.1, U1.28 (VCAP1)
VCAP2: C15.1, U1.30 (VCAP2)
VCAP3: C16.1, U1.55 (VCAP3)
VCAP4: C17.1, U1.26 (VCAP4)
VREFP: C12.1, C13.1, U1.24 (VREFP)
WCT: C33.1, U1.64 (WCT)

Notes on the sheet:
1. Electrode pogo pins + input protection
Pogo pins P1-P12 (top side, gold) -> ESD array (electrode side) -> 2.2k series -> 1nF to GND -> ADS1298. Values: OpenBCI Cyton R4/C26/D5/D6.
REF electrode feeds all eight INxN (referential montage). BIAS = RLD output, no series R (see notes Q5).
2. ADS1298 analog front end + 3. bias drive (RLD)
Unipolar: AVDD 3.3V from LDO1 only, DVDD 3.3V from LDO2. Caps per TI SBAS459K Figure 106, placed at the package.
Firmware: CONFIG3 RLDREF_INT=1, PD_RLD=1; gain x6 or lower for EMG; 500-1000 SPS; SRB not used.
4. Radio: u-blox NINA-B306-00B (nRF52840, internal antenna, 32.768 kHz crystal inside)
SPI on non radio-sensitive pins (P0.11/P1.09/P1.08). CS/DRDY/START/RESET/PWDN toggle < 10 kHz (u-blox note 2).
5. Power: battery, reverse-polarity FET, charger, two LDOs
Charge only off-body: firmware stops recording when VBUS is present. MCP73831 100 mA (R_PROG 10k).
6. Battery monitor (no LEDs: hidden wearable, status shown in the phone app)
Fixed 1M/1M divider: VBAT/2 <= 2.1 V (never above the 3.3 V pin), 2.1 uA always. 100nF feeds the SAADC sample cap.
